HARDWAREdotASTRO/Small_Radio_Telescope/Pics/71dty6aQaML._SY679_.jpg

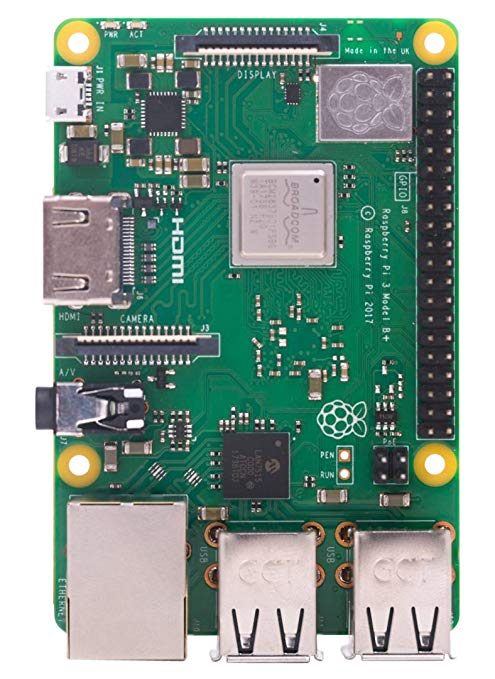
Pics/71dty6aQaML._SY679_.jpg
