HARDWAREdotASTRO/Small_Radio_Telescope/ArduinoTestFiles/SmallRadioTelescope/PicturesAndVideos/SignalsReceiver/SignalsReceiver.jpg

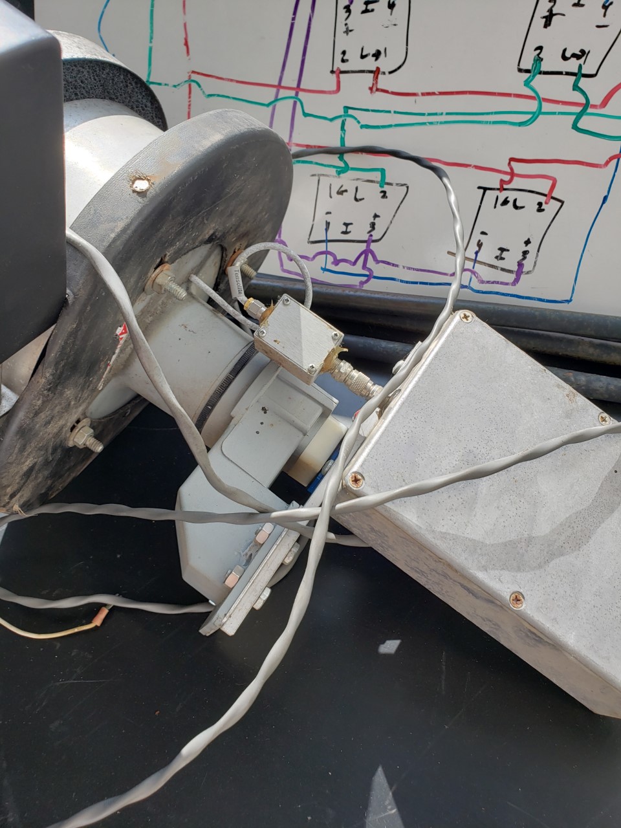
ArduinoTestFiles/SmallRadioTelescope/PicturesAndVideos/SignalsReceiver/SignalsReceiver.jpg
