HARDWAREdotASTRO/Small_Radio_Telescope/README.md

# Small_Radio_Telescope
Code to be used with control system for Winona State University's Small Radio Telescope (SRT).

For specific information about the workings see https://osf.io/wx659/wiki/home/
