HARDWAREdotASTRO/Small_Radio_Telescope/Research/Resources/ecliptic_to_motor_translation_math.pdf

SRT MEMO #018
MASSACHUSETTS INSTITUTE OF TECHNOLOGY HAYSTACK OBSERVATORY
WESTFORD, MASSACHUSETTS 01886

June 13, 2005
Telephone: 978-692-4764
Fax: 781-981-0590
To: SRT Group

From: Alan E.E. Rogers

Subject: | | Interferometer geometry calculations

For the “VLBI” mode we start with the latitude, longitude and height of each end of the “baseline” and convert to geocentric right handed x, y, z coordinates. This coordinate conversion is done by function
( | ) () (
( | ) () ( )
( | ) () | ()
cos | cos
cos | sin
1 | sin

=+
=+
= +−+
x | n hgt | lat | lon)
y | n hgt | lat | lon
z | n | e hgt | lat
where | ( | ) () 1
2 | 2
n a | e | lat = | −1 sin
a = 6378137 m | WGS84
e = 2f-f ²
f = 1/298.257223563 WGS84

The vector baseline is defined as the vector from site1 (the “reference” site) to site2 (the remote site)

2 | 1
2 | 1
2 | 1

=−
=−
=−

x

y

z

b | xx
b | y | y
b | z | z
The delay τ of a signal’s arrival at the remote site is τ =− | =− | + | + ˆ | ( | ) G
i | xx | yy | zz b s c | bs bs bs c
Where c = velocity of propagation
sˆ = unit vector in the direction of the source
sx = cos (dec) cos (gha)
sy = -cos (dec) sin (gha)
sz = sin(dec)

where gha = gst – ra = Greenwich hour angle gst = Greenwich sidereal time

1

ra = apparent right ascension
dec = apparent declination

or from the derivatives of the phase with respect to ra and dec

φ | πλ = | − ( | ) | ()( ) 2 | cos | cos | cos | sin | sin ( | ) dec | gha b | dec | gha b | dec b x | ( ) ( ) y | z + | ( )

In units of fringes per arc second
( | ) () | () ( | )
( | ) ( ) | ( )( ) | ( )( )( | )
sin | cos | 648,000
cos | cos | sin | sin | sin | 648,000
π | λ
π | λ
= | +
= | − | +
x | y
z | x | y
u | b | gha b | gha
v | b | dec b | gha | dec b | gha | dec

The interferometer phase (normally defined as being positive (NRAO’s convention) when the signal arrives earlier at the 2nd site is
φ | πλ =+2 | ˆ | ( | ) G
b s | radians i
or φ =−2 | ( πτ f | radians)
where λ = wavelength (m)
f = frequency (Hz)

The components of the baseline projected in the direction of the source in the directions of increasing RA and increasing declination are known as u and v and are often expressed in units of fringes per arc second. These can be derived from the baseline projections
| | () | ()
( ) | ( )( ) | ( )( )
sin | cos
cos | cos | sin | sin | sin
= | +
= | − | +
x | y
z | x | y
u b | gha b | gha
v b | dec b | gha | dec b | gha | dec

2
