HARDWAREdotASTRO/Small_Radio_Telescope/ArduinoTestFiles/SmallRadioTelescope/PicturesAndVideos/SRTMotorAssembly/ArduinoSwitchSchematic.jpg

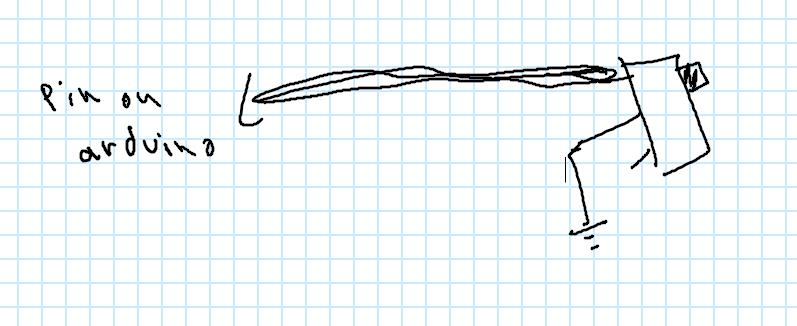
ArduinoTestFiles/SmallRadioTelescope/PicturesAndVideos/SRTMotorAssembly/ArduinoSwitchSchematic.jpg
