HARDWAREdotASTRO/Small_Radio_Telescope/ArduinoTestFiles/SmallRadioTelescope/PicturesAndVideos/SRTMotorAssembly/pololu schematic.jpg

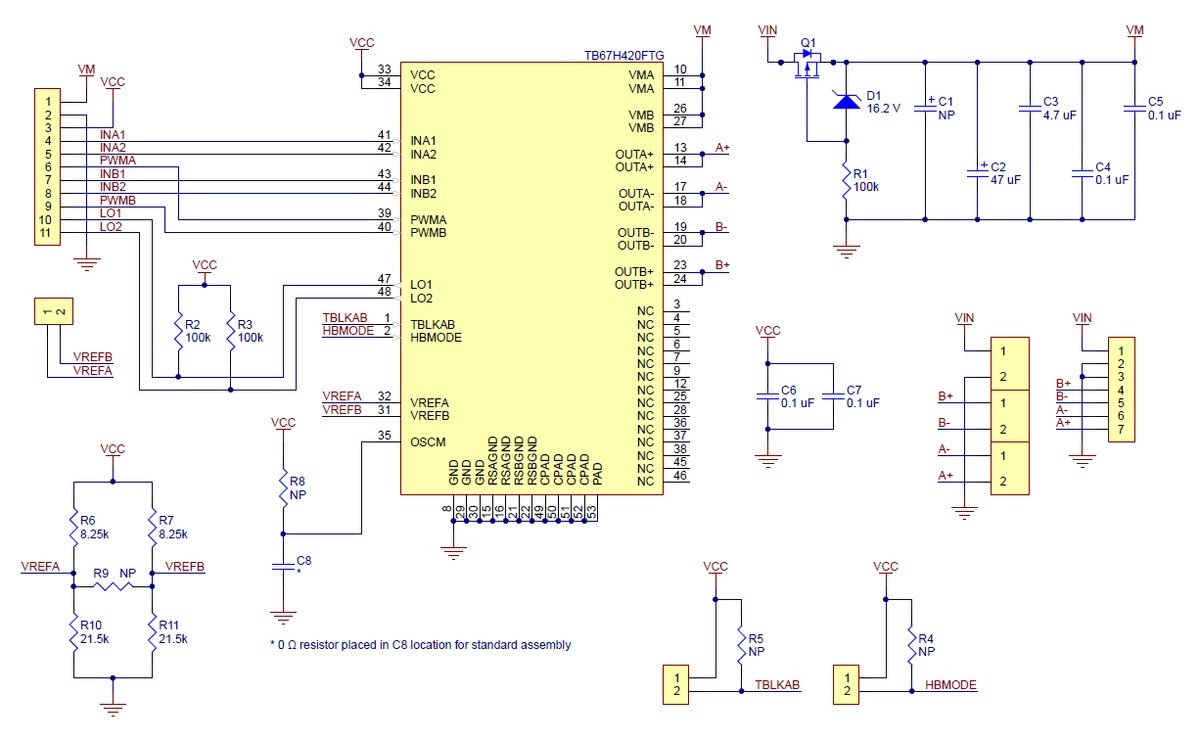
ArduinoTestFiles/SmallRadioTelescope/PicturesAndVideos/SRTMotorAssembly/pololu schematic.jpg
