HARDWAREdotASTRO/Small_Radio_Telescope/ArduinoTestFiles/SmallRadioTelescope/PicturesAndVideos/SRTMotorAssembly/PololuChipPinoutDescriptionTable.PNG

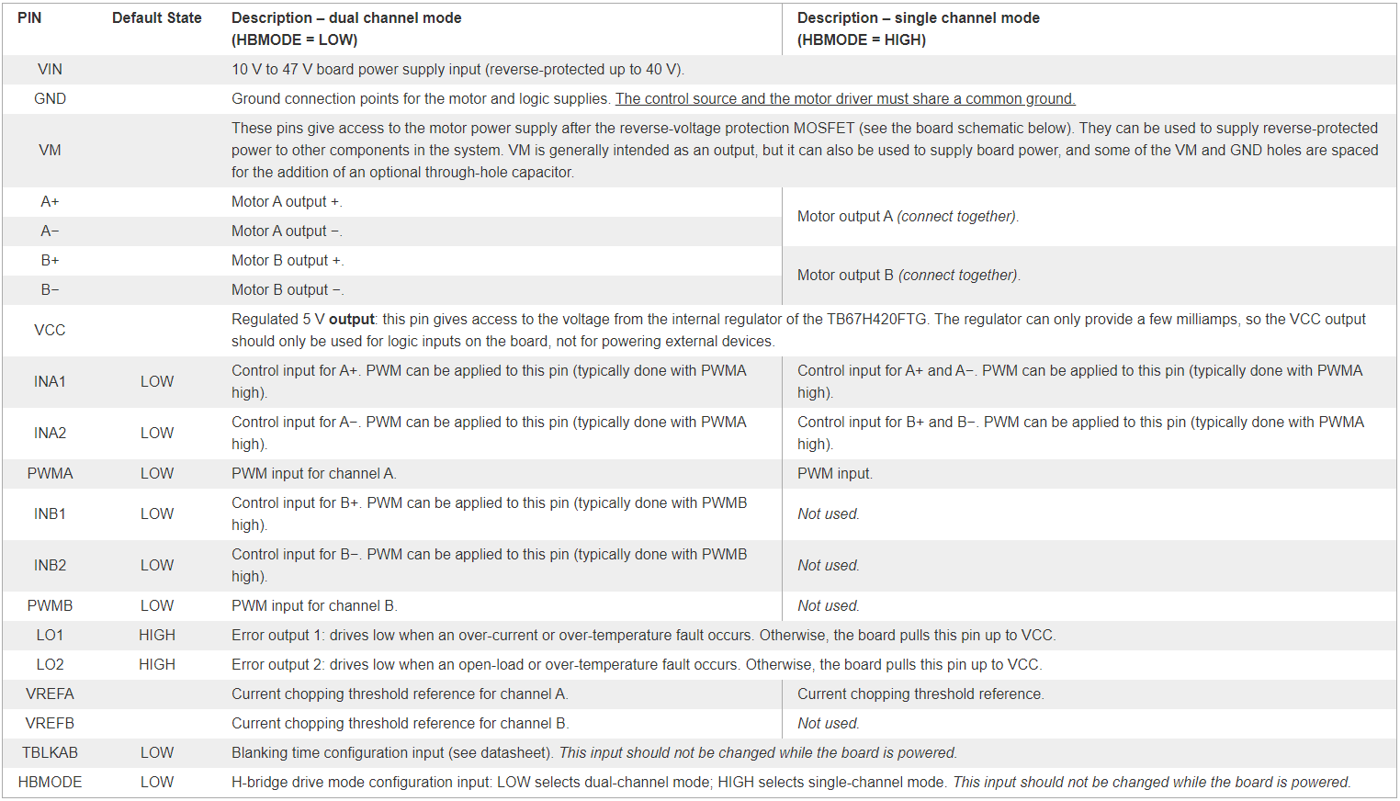
ArduinoTestFiles/SmallRadioTelescope/PicturesAndVideos/SRTMotorAssembly/PololuChipPinoutDescriptionTable.PNG
