HARDWAREdotASTRO/Small_Radio_Telescope/ArduinoTestFiles/SmallRadioTelescope/PicturesAndVideos/SRTMotorAssembly/pololuPinoutDiagram.jpg

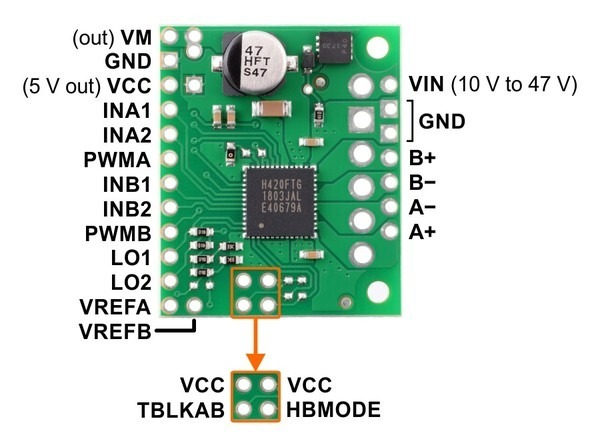
ArduinoTestFiles/SmallRadioTelescope/PicturesAndVideos/SRTMotorAssembly/pololuPinoutDiagram.jpg
