HARDWAREdotASTRO/Small_Radio_Telescope/Pics/4-reed-switch.jpg

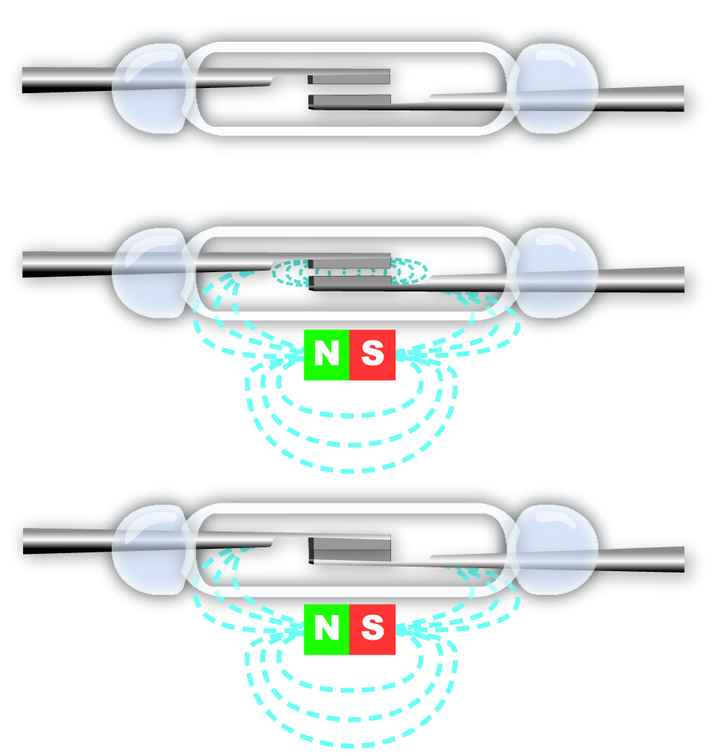
Pics/4-reed-switch.jpg
