HARDWAREdotASTRO/Small_Radio_Telescope/Pics/51K5cifF0kL.jpg

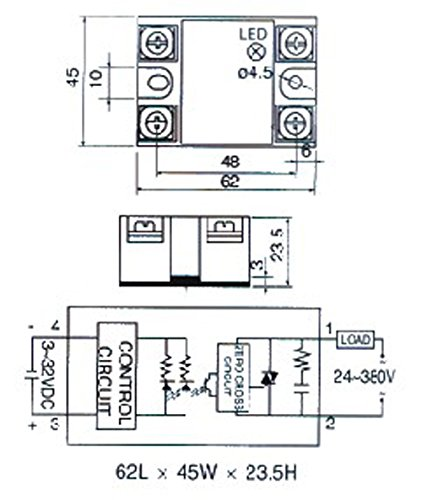
Pics/51K5cifF0kL.jpg
