HARDWAREdotASTRO/Small_Radio_Telescope/Pics/71DZKc+WAvL._SL1000_.jpg

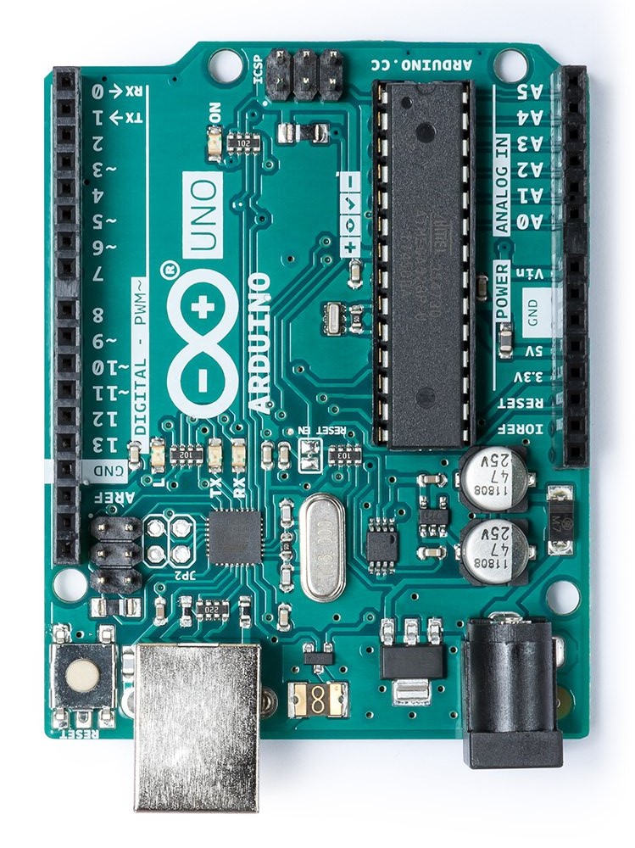
Pics/71DZKc+WAvL._SL1000_.jpg
