HARDWAREdotASTRO/Small_Radio_Telescope/Pics/arduino-raspberry-pi-serial-connect-1024x840.jpg

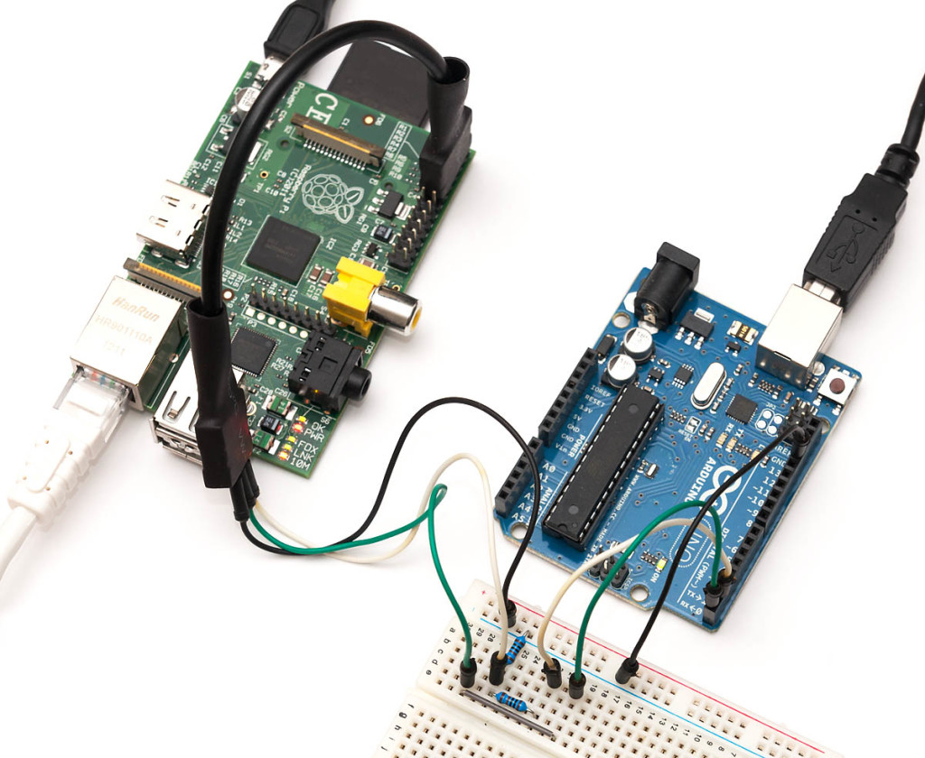
Pics/arduino-raspberry-pi-serial-connect-1024x840.jpg
