HARDWAREdotASTRO/Small_Radio_Telescope/Pics/box2.PNG

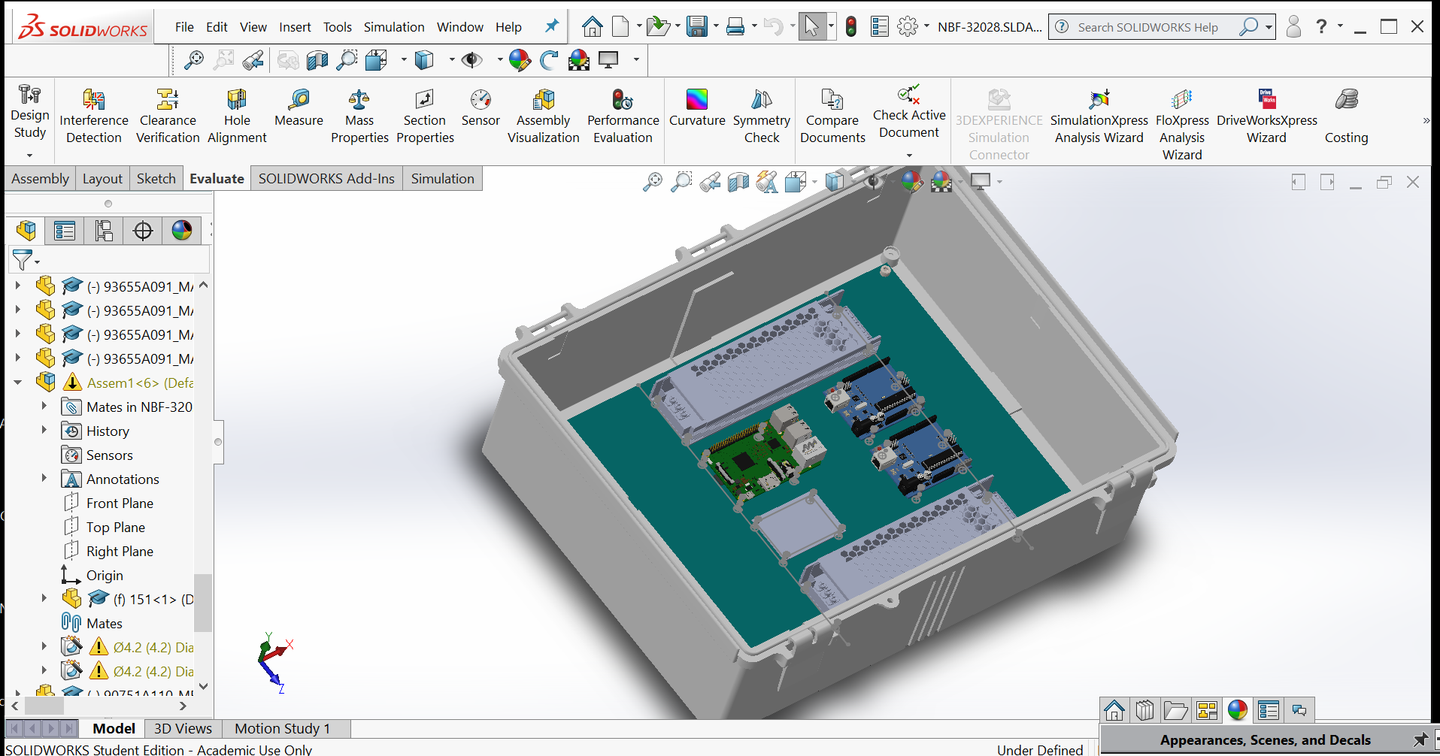
Pics/box2.PNG
