HARDWAREdotASTRO/Small_Radio_Telescope/Pics/box.PNG

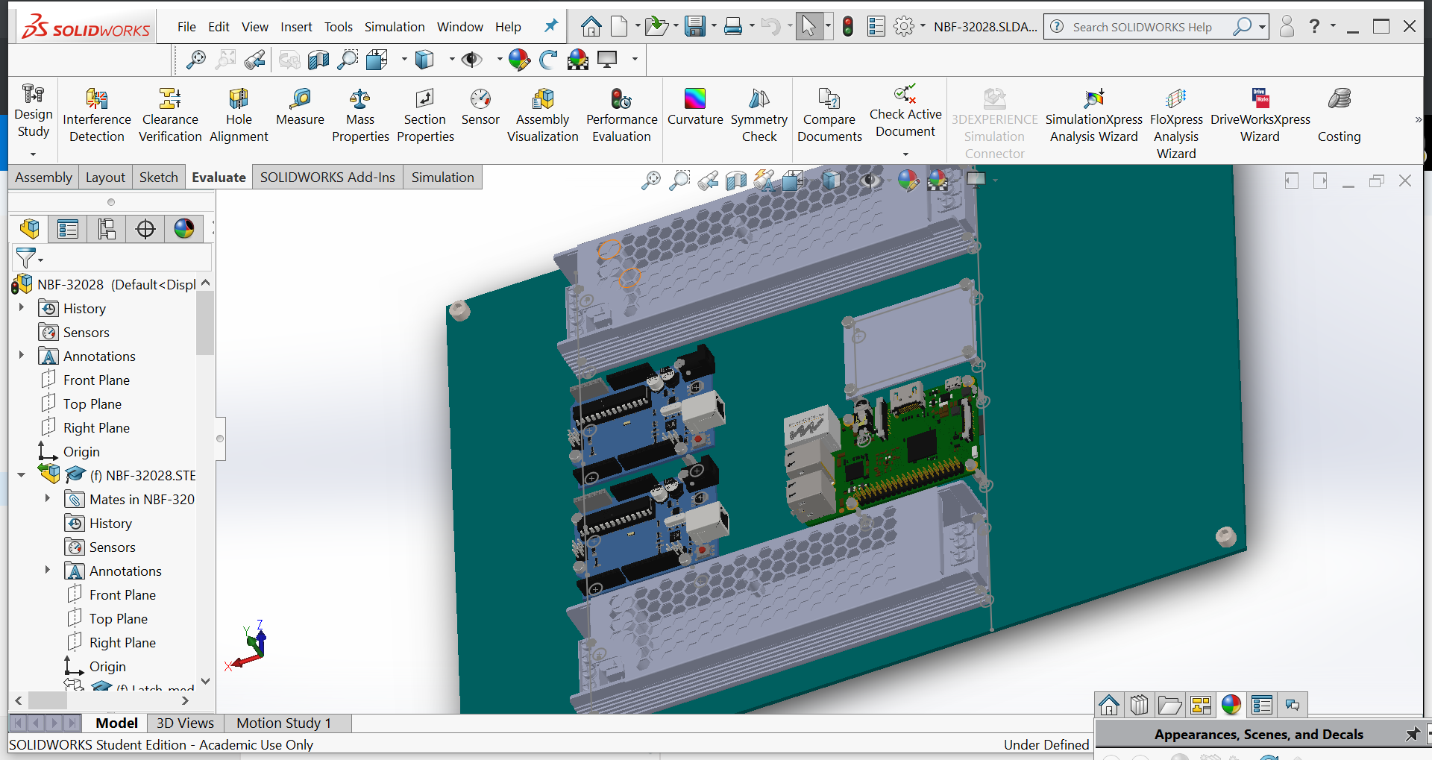
Pics/box.PNG
