HARDWAREdotASTRO/Small_Radio_Telescope/Pics/Capsfgture.PNG

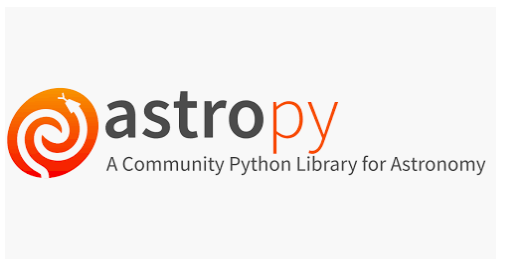
Pics/Capsfgture.PNG
