HARDWAREdotASTRO/Small_Radio_Telescope/Pics/Capture1.PNG

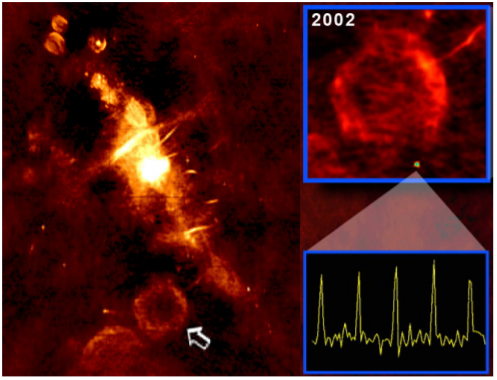
Pics/Capture1.PNG
