HARDWAREdotASTRO/Small_Radio_Telescope/Pics/Capture2.PNG

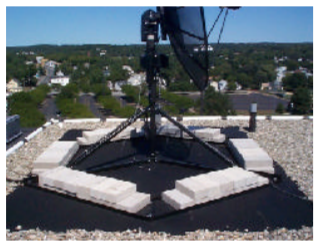
Pics/Capture2.PNG
