HARDWAREdotASTRO/Small_Radio_Telescope/Pics/Capturedgn.PNG

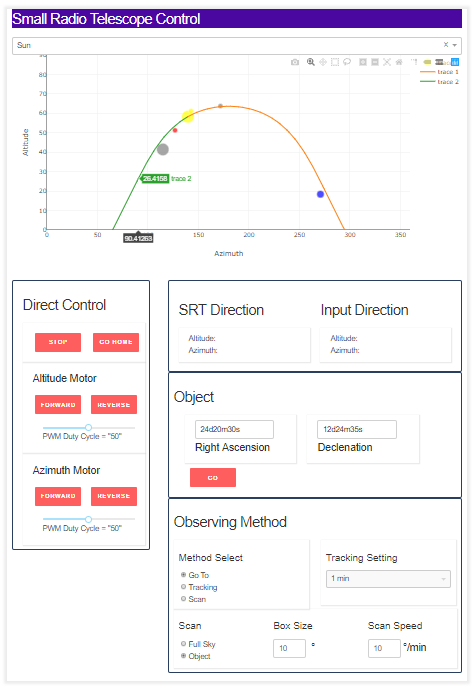
Pics/Capturedgn.PNG
