HARDWAREdotASTRO/Small_Radio_Telescope/Pics/Clean_sens.PNG

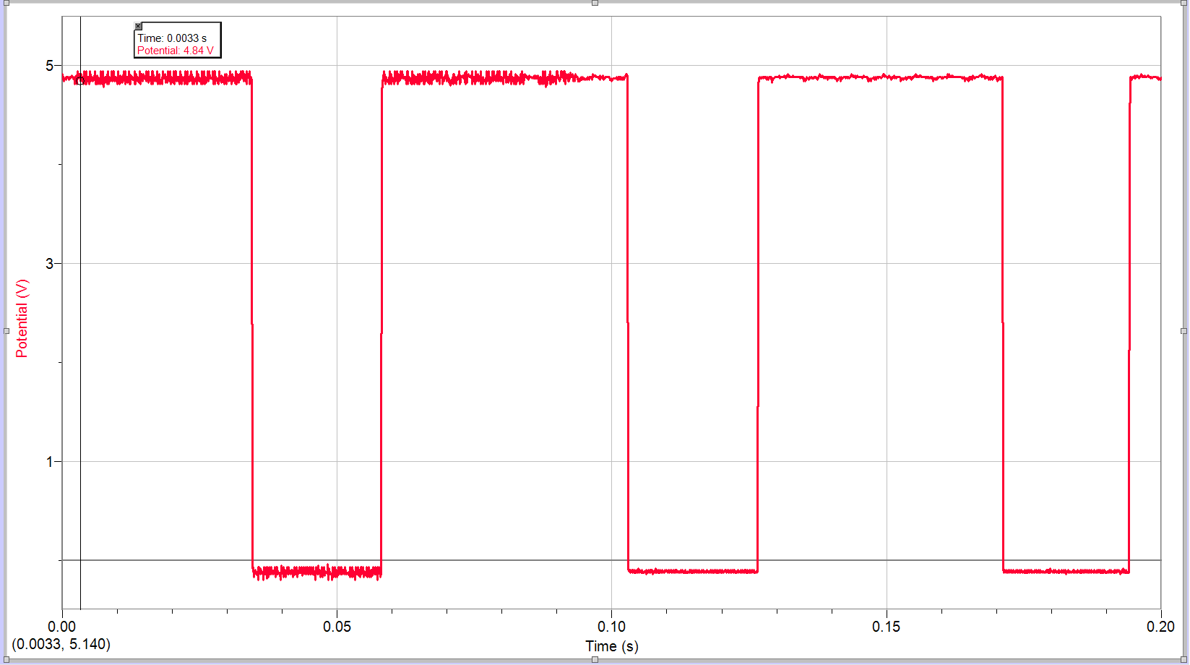
Pics/Clean_sens.PNG
