HARDWAREdotASTRO/Small_Radio_Telescope/Pics/cover.PNG

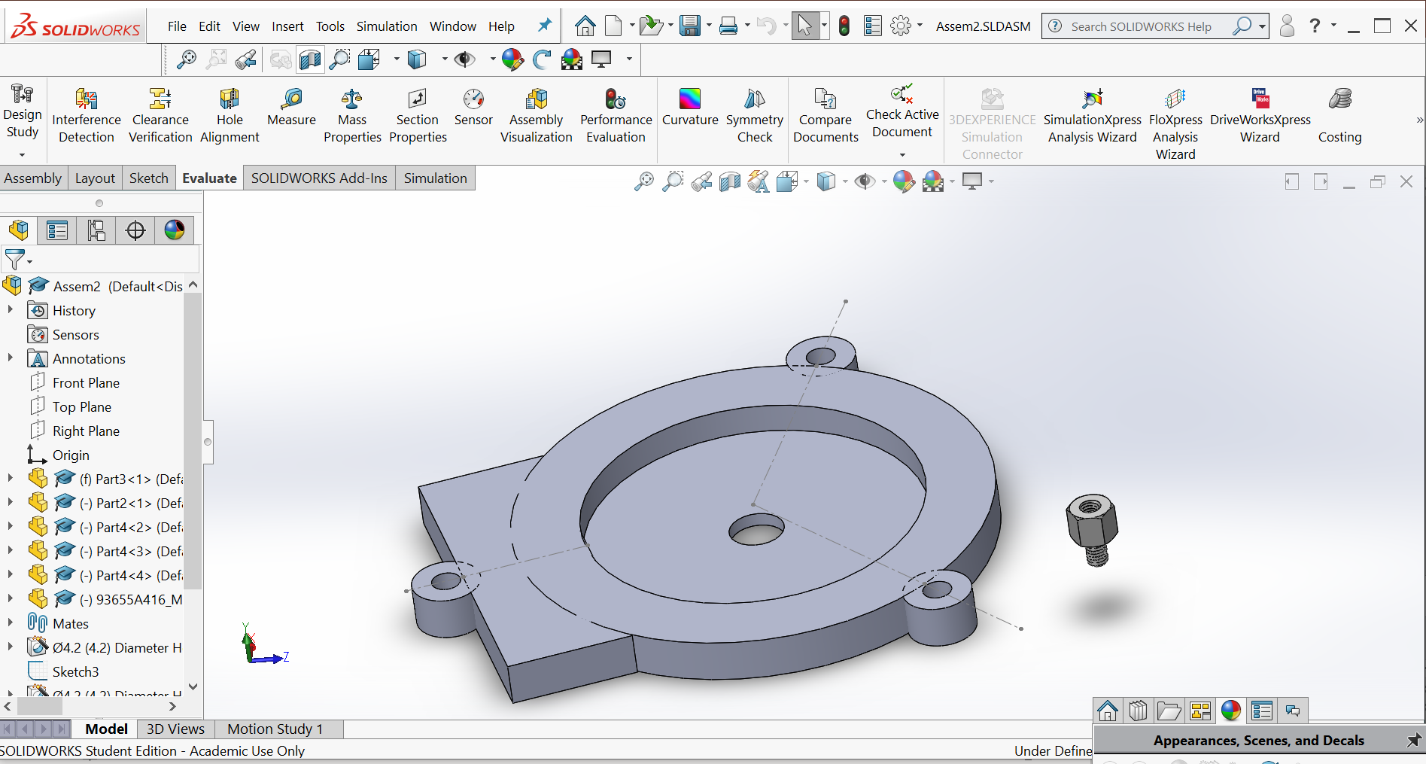
Pics/cover.PNG
