HARDWAREdotASTRO/Small_Radio_Telescope/Pics/cs04p13l.jpg

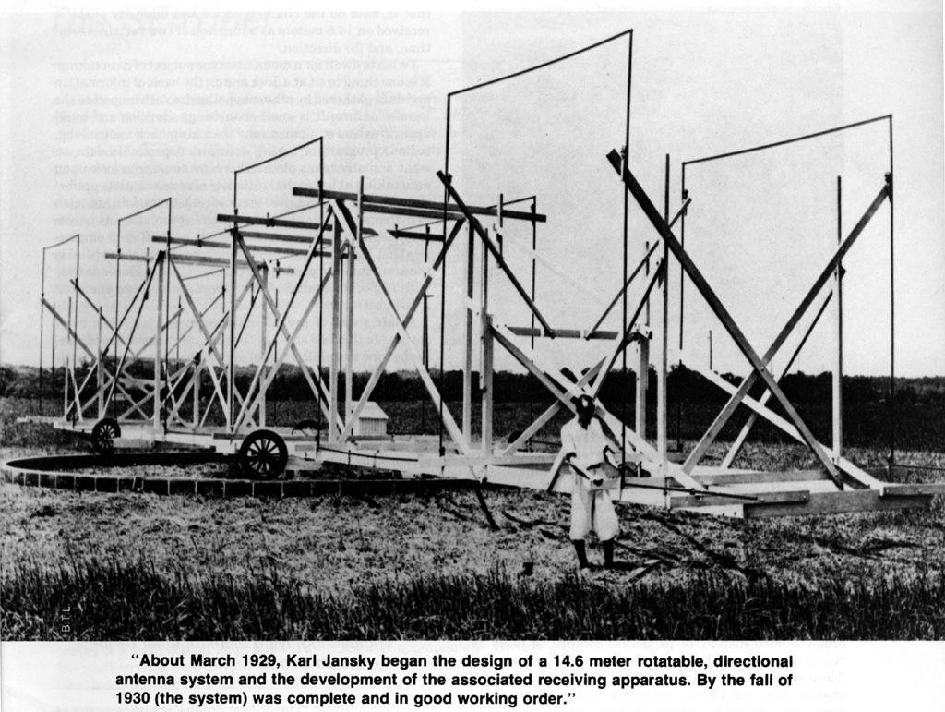
Pics/cs04p13l.jpg
