HARDWAREdotASTRO/Small_Radio_Telescope/Pics/download.jpg

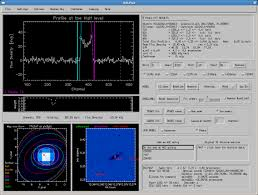
Pics/download.jpg
