HARDWAREdotASTRO/Small_Radio_Telescope/Pics/gc_1meter_big.gif

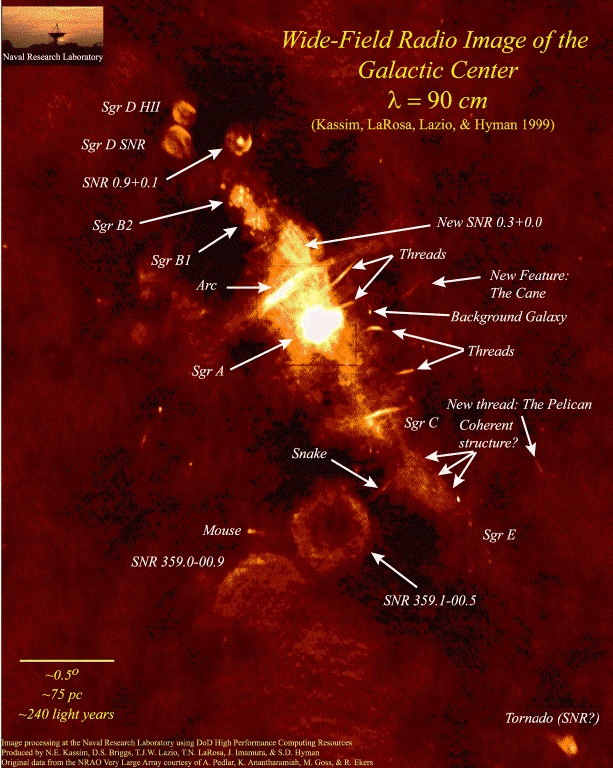
Pics/gc_1meter_big.gif
