HARDWAREdotASTRO/Small_Radio_Telescope/Pics/gears.jpg

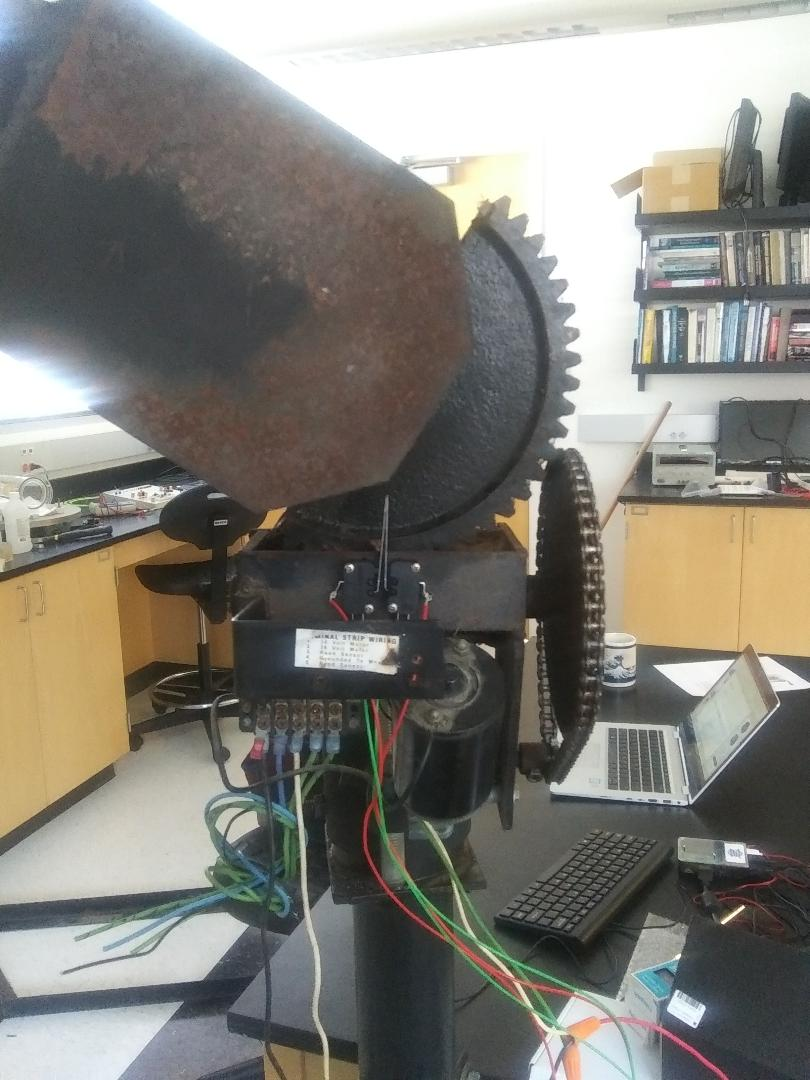
Pics/gears.jpg
