HARDWAREdotASTRO/Small_Radio_Telescope/Pics/GPIOreference.PNG

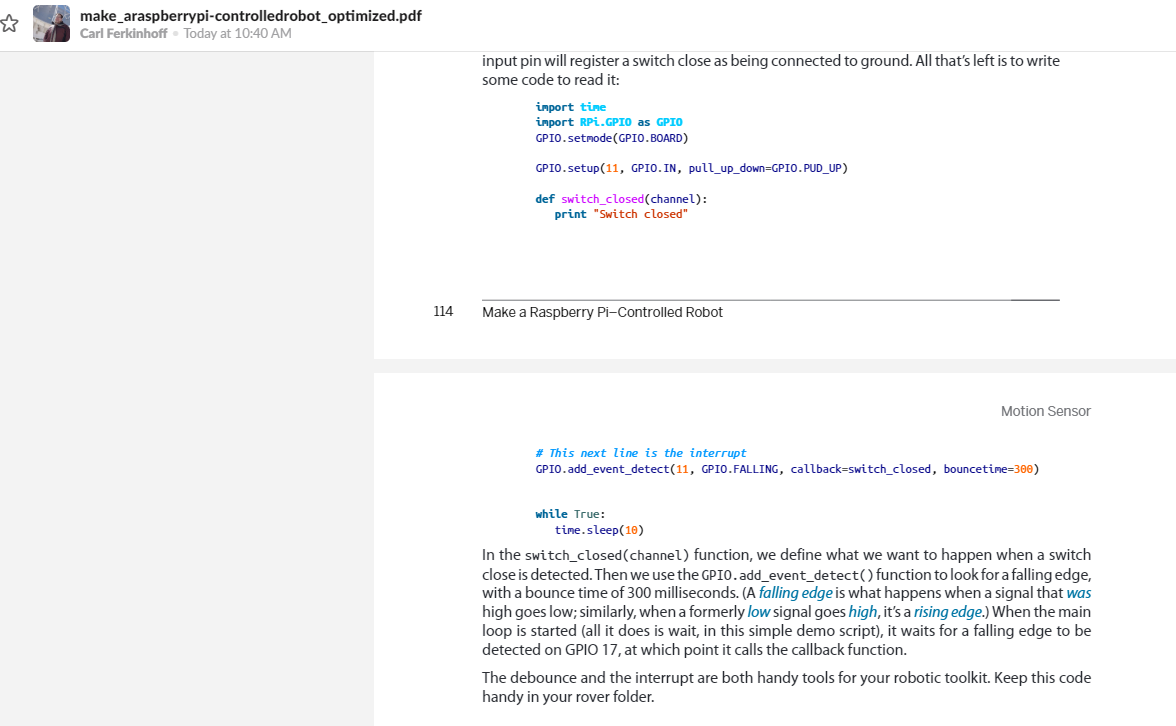
Pics/GPIOreference.PNG
