HARDWAREdotASTRO/Small_Radio_Telescope/Pics/HO_front-page_01.jpg

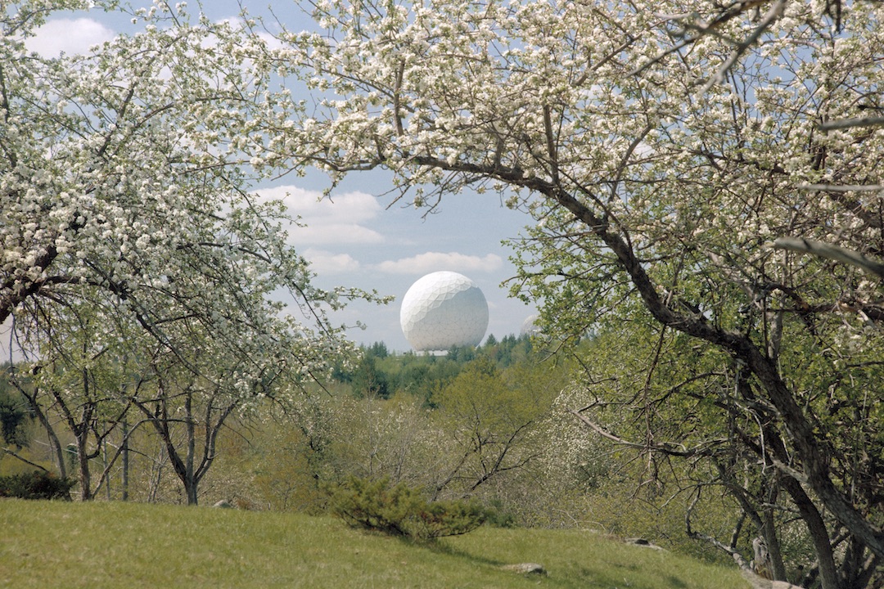
Pics/HO_front-page_01.jpg
