HARDWAREdotASTRO/Small_Radio_Telescope/Pics/IMG_0026.JPG

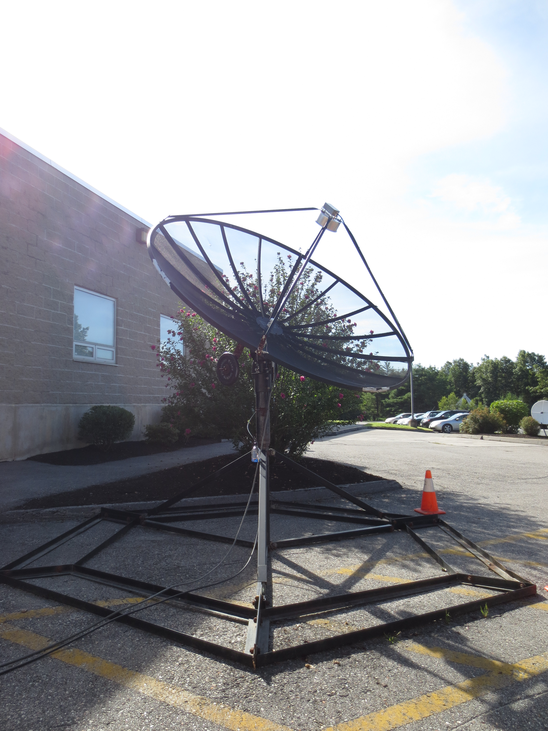
Pics/IMG_0026.JPG
