HARDWAREdotASTRO/Small_Radio_Telescope/Pics/IMGP8953.JPG

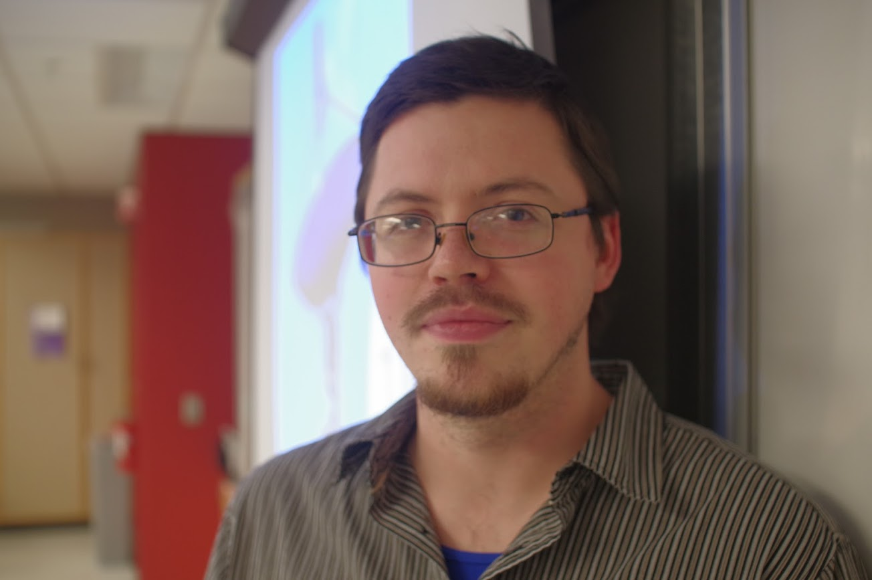
Pics/IMGP8953.JPG
