HARDWAREdotASTRO/Small_Radio_Telescope/Pics/Karl_Jansky.jpg

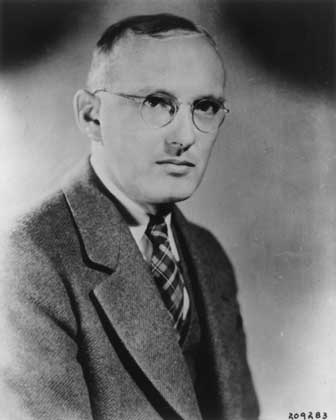
Pics/Karl_Jansky.jpg
