HARDWAREdotASTRO/Small_Radio_Telescope/Pics/limiting_switch.jpg

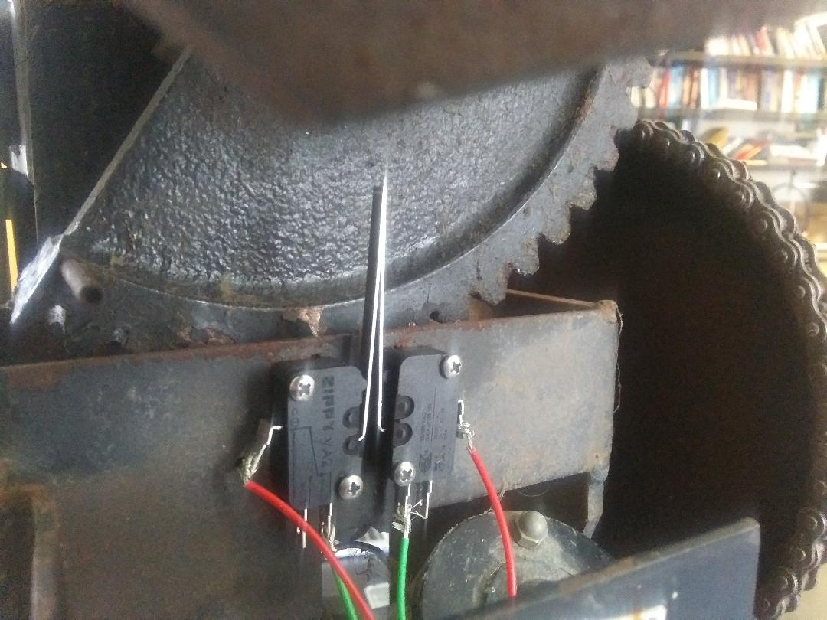
Pics/limiting_switch.jpg
