HARDWAREdotASTRO/Small_Radio_Telescope/Pics/memberimage.jpg

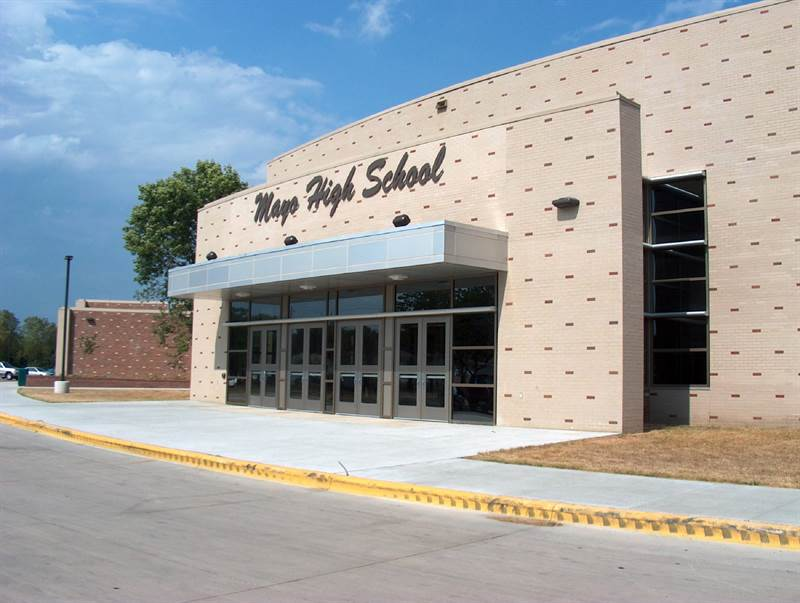
Pics/memberimage.jpg
