HARDWAREdotASTRO/Small_Radio_Telescope/Pics/motor_schematic.PNG

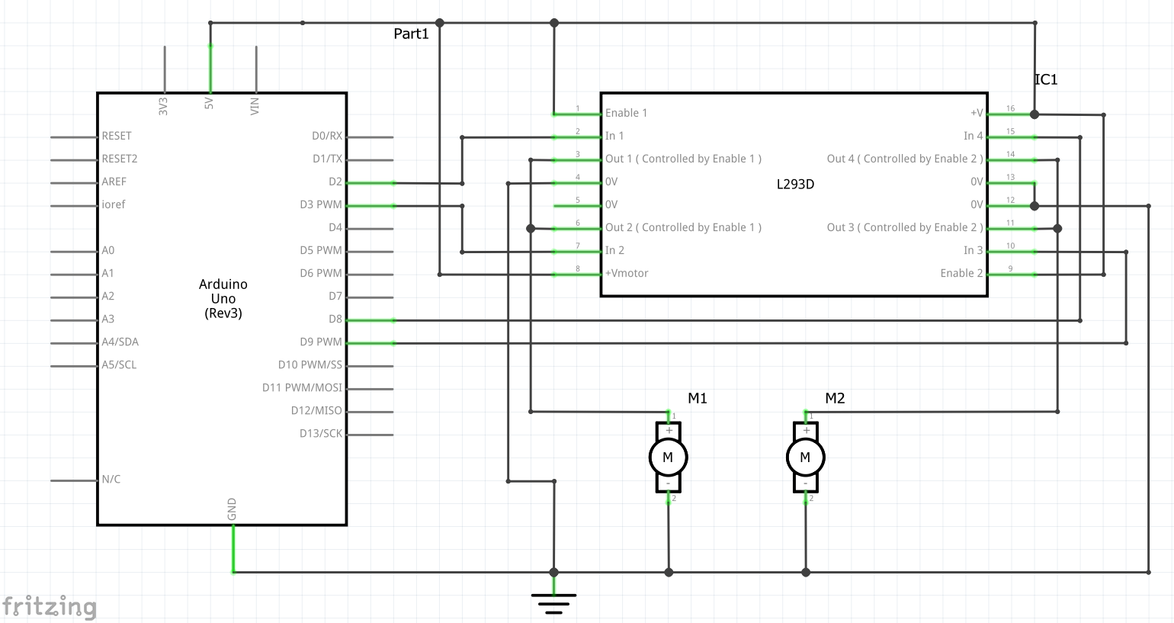
Pics/motor_schematic.PNG
