HARDWAREdotASTRO/Small_Radio_Telescope/Pics/nhi_allsky.gif

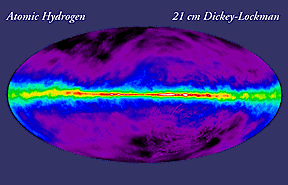
Pics/nhi_allsky.gif
