HARDWAREdotASTRO/Small_Radio_Telescope/Pics/Pololu.jpg

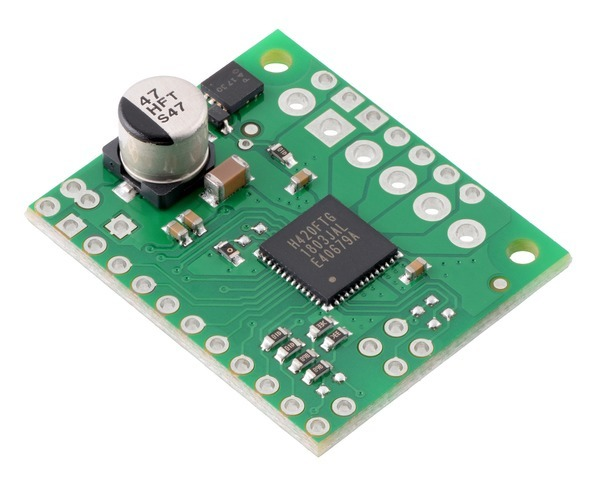
Pics/Pololu.jpg
