HARDWAREdotASTRO/Small_Radio_Telescope/Pics/reed-switch-normally-open.jpg

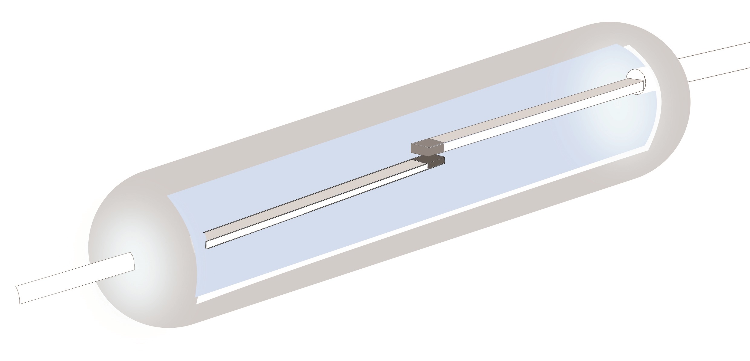
Pics/reed-switch-normally-open.jpg
