HARDWAREdotASTRO/Small_Radio_Telescope/Pics/Reed_switch.jpg

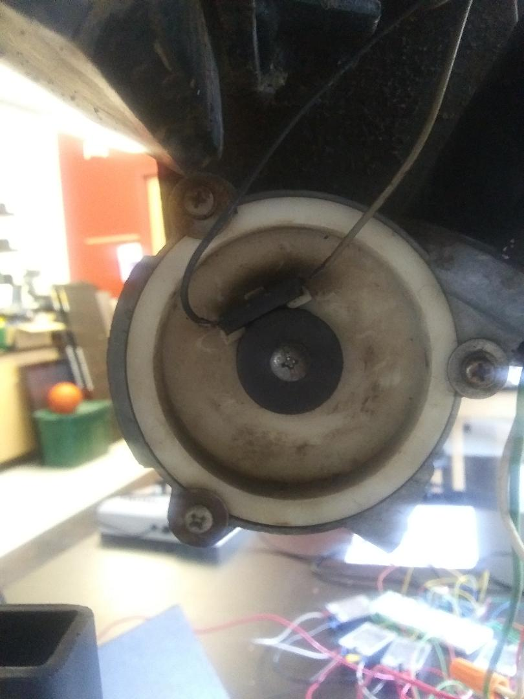
Pics/Reed_switch.jpg
