HARDWAREdotASTRO/Small_Radio_Telescope/Pics/reed_switch.PNG

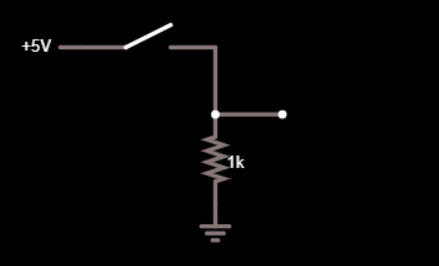
Pics/reed_switch.PNG
