HARDWAREdotASTRO/Small_Radio_Telescope/Pics/Shaft.jpg

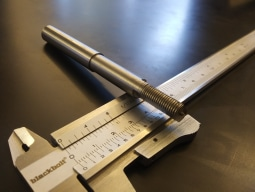
Pics/Shaft.jpg
