HARDWAREdotASTRO/Small_Radio_Telescope/Pics/solid.PNG

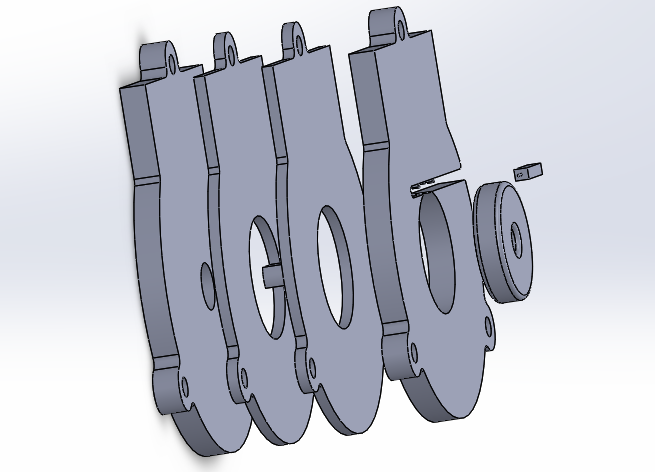
Pics/solid.PNG
