HARDWAREdotASTRO/Small_Radio_Telescope/Pics/srtdecember2.jpg

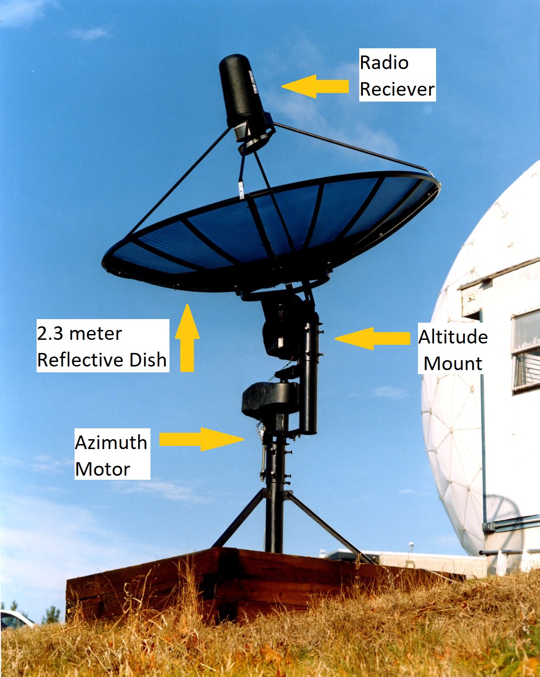
Pics/srtdecember2.jpg
