HARDWAREdotASTRO/Small_Radio_Telescope/Pics/srtdecember22.jpg

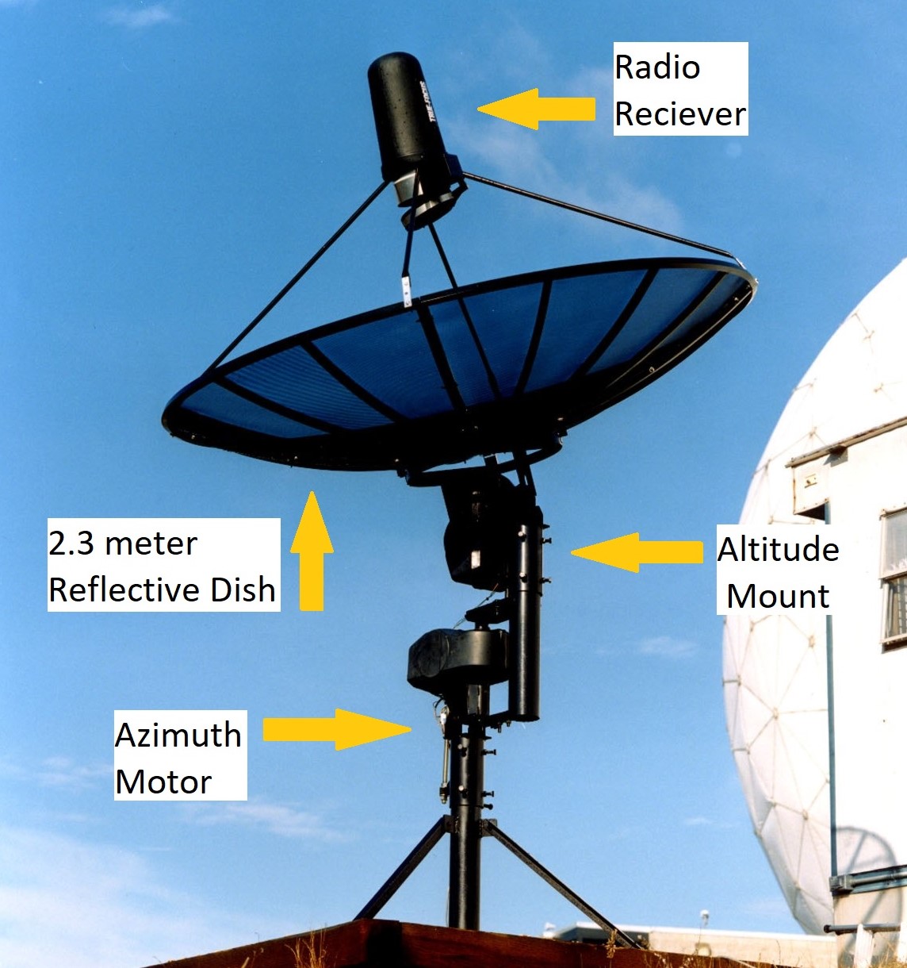
Pics/srtdecember22.jpg
