HARDWAREdotASTRO/Small_Radio_Telescope/Pics/Switches.jpg

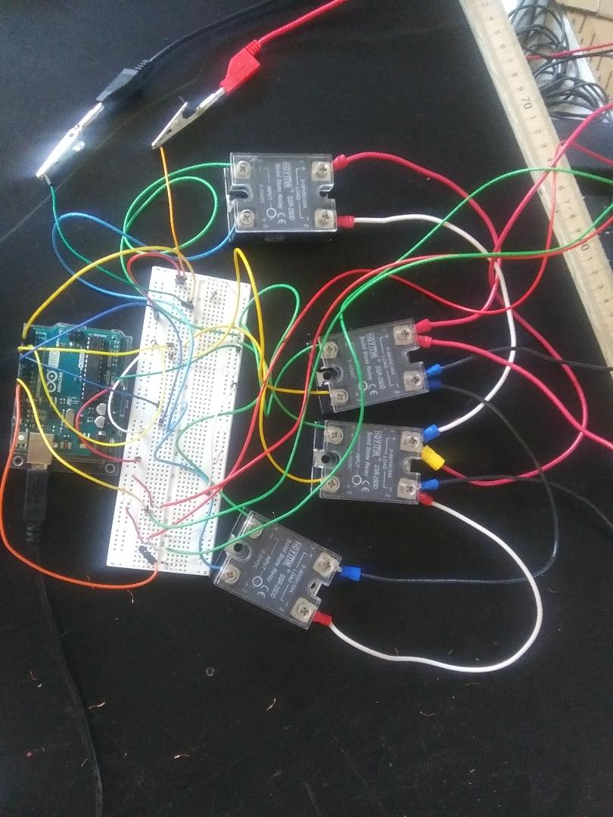
Pics/Switches.jpg
