HARDWAREdotASTRO/Small_Radio_Telescope/Pics/thumbnail3.jpg

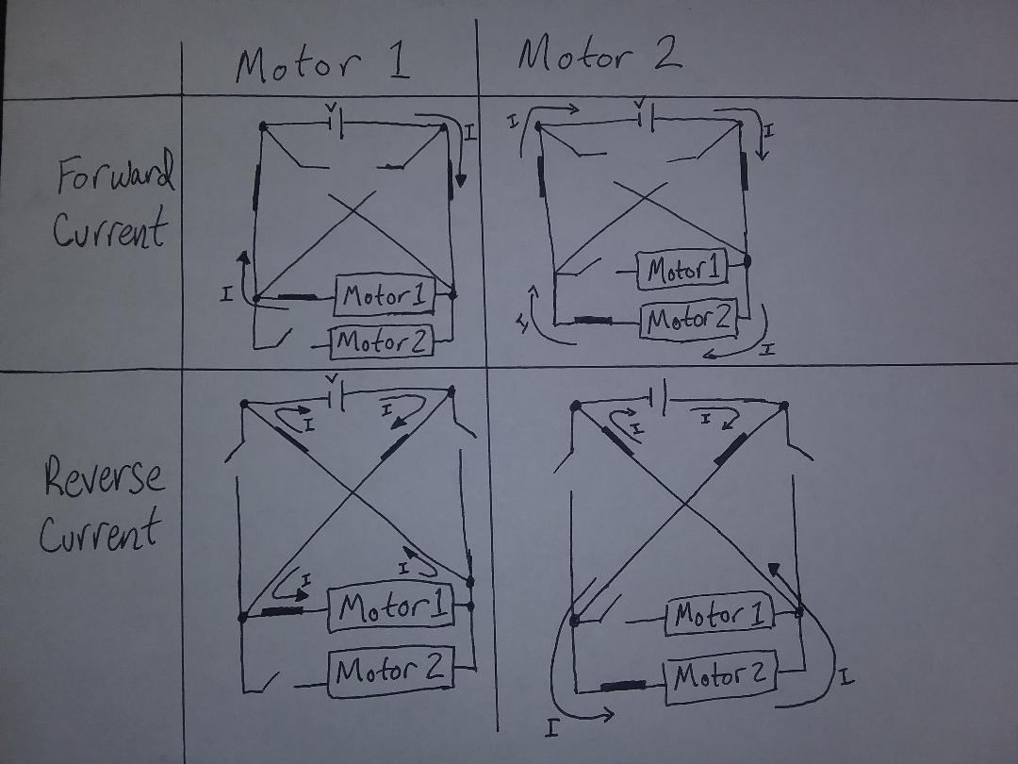
Pics/thumbnail3.jpg
