HARDWAREdotASTRO/Small_Radio_Telescope/Pics/thumbnail4.jpg

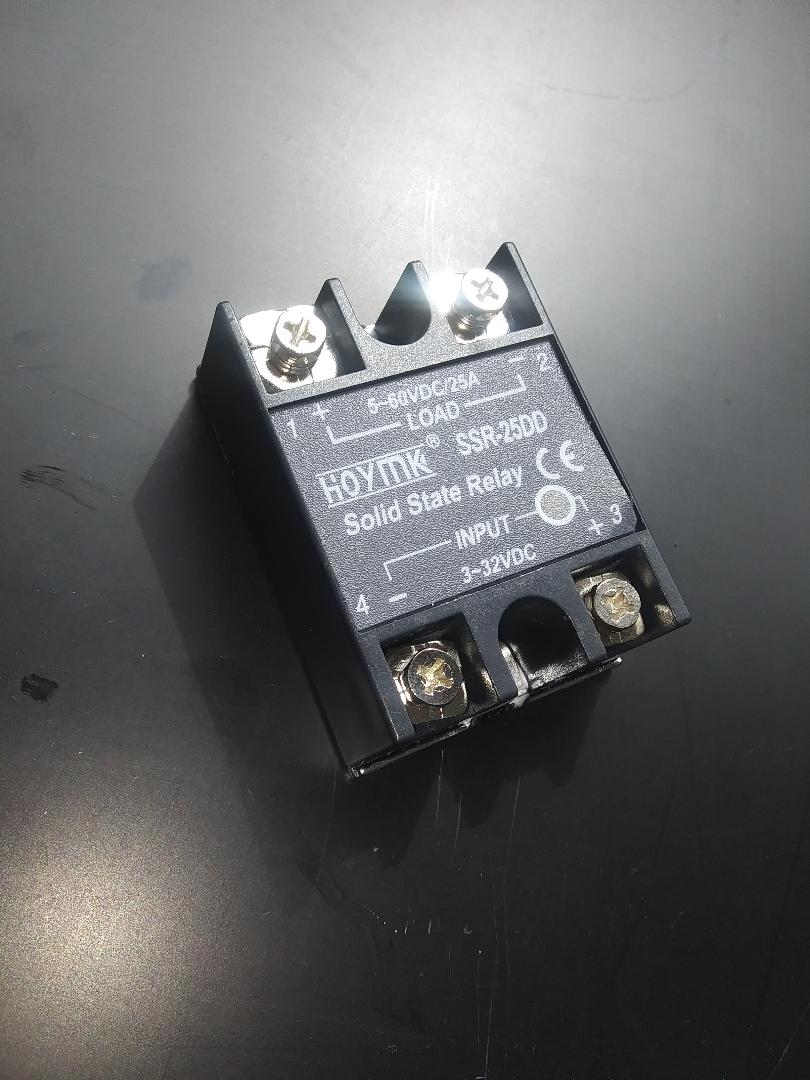
Pics/thumbnail4.jpg
