HARDWAREdotASTRO/Small_Radio_Telescope/Pics/thumbnail (1).jpg

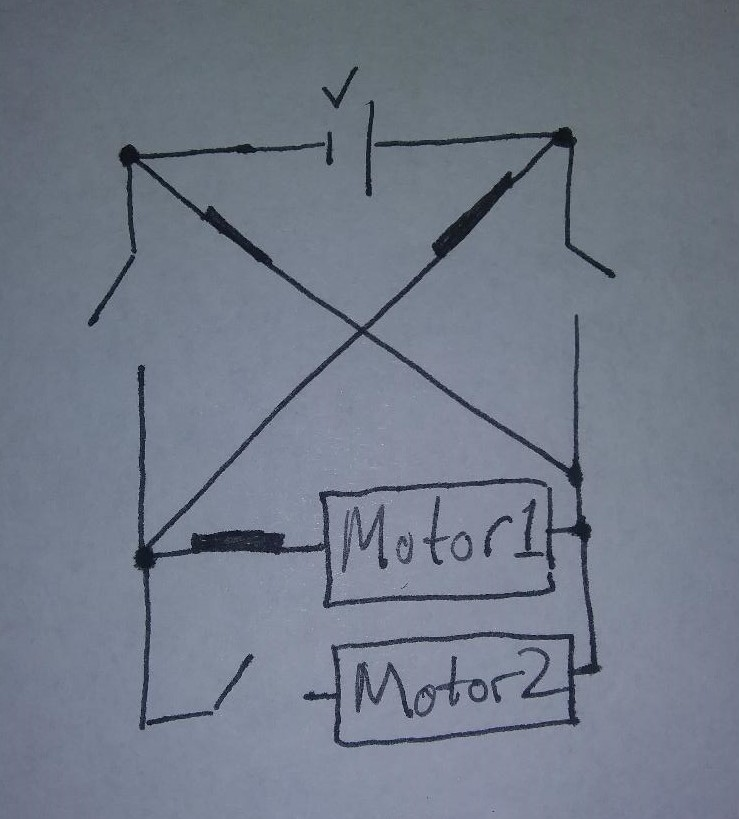
Pics/thumbnail (1).jpg
