HARDWAREdotASTRO/Small_Radio_Telescope/Pics/thumbnail (2).jpg

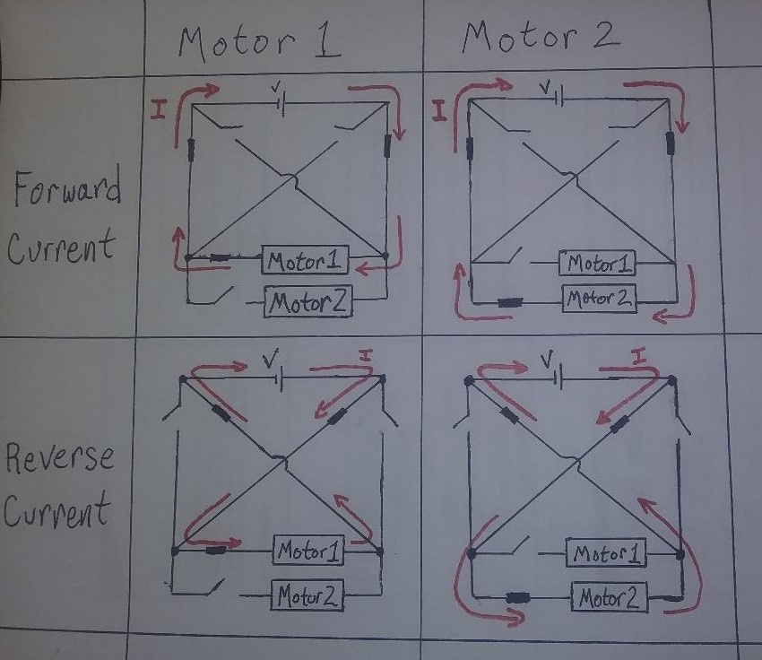
Pics/thumbnail (2).jpg
