HARDWAREdotASTRO/Small_Radio_Telescope/Pics/thumbnail (3).jpg

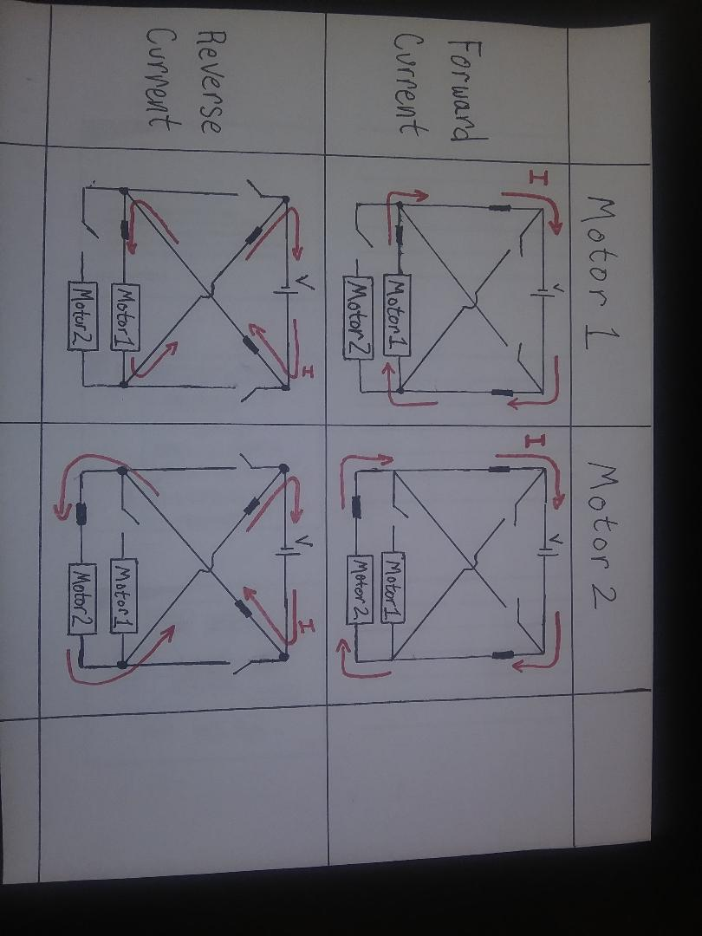
Pics/thumbnail (3).jpg
