HARDWAREdotASTRO/Small_Radio_Telescope/Pics/thumbnail (4).jpg

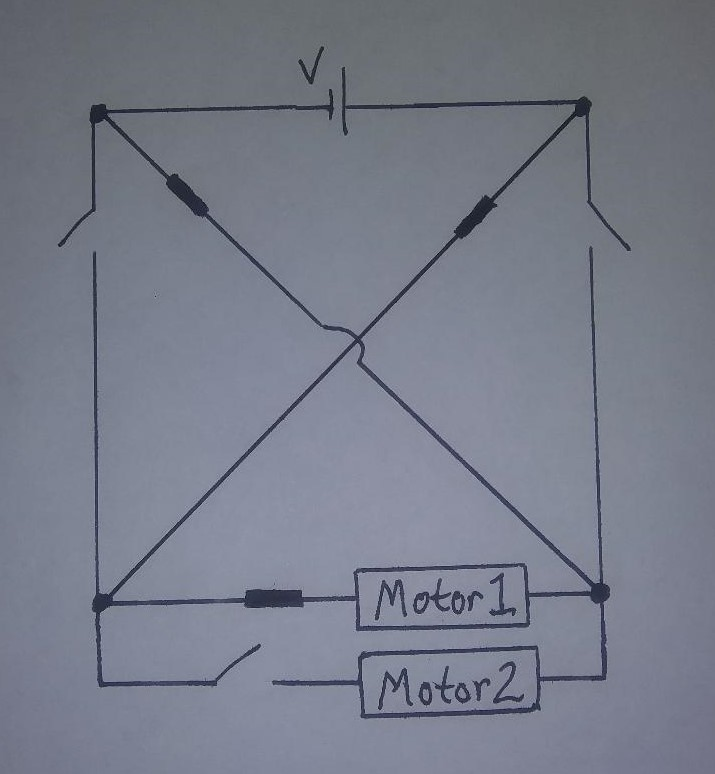
Pics/thumbnail (4).jpg
