HARDWAREdotASTRO/Small_Radio_Telescope/Pics/thumbnail (5).jpg

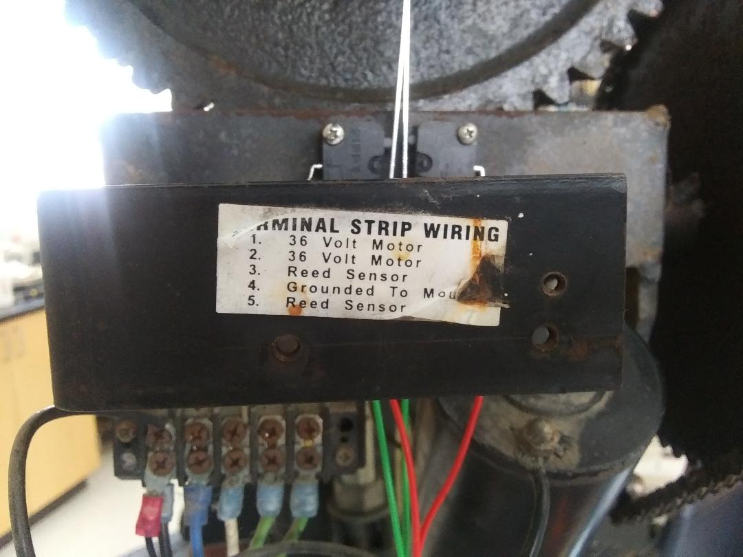
Pics/thumbnail (5).jpg
