HARDWAREdotASTRO/Small_Radio_Telescope/Pics/thumbnail.jpg

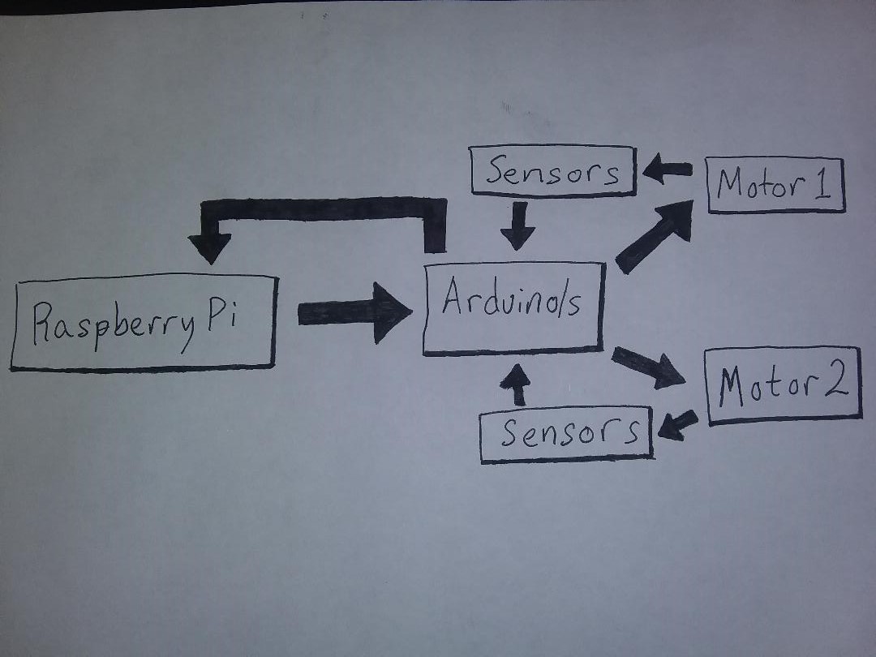
Pics/thumbnail.jpg
