HARDWAREdotASTRO/Small_Radio_Telescope/Pics/Winona State University_200px1.png

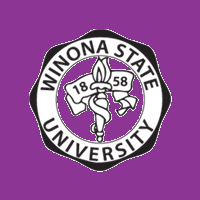
Pics/Winona State University_200px1.png
