HARDWAREdotASTRO/Small_Radio_Telescope/Pics/Winona State University_200px.png

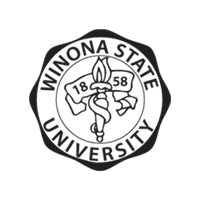
Pics/Winona State University_200px.png
