HARDWAREdotASTRO/Small_Radio_Telescope/Pics/Winona.PNG

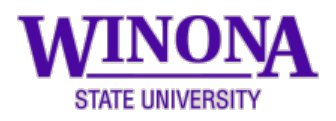
Pics/Winona.PNG
