HARDWAREdotASTRO/Small_Radio_Telescope/Schematics _ Datasheets/Box/Assem1.SLDASM

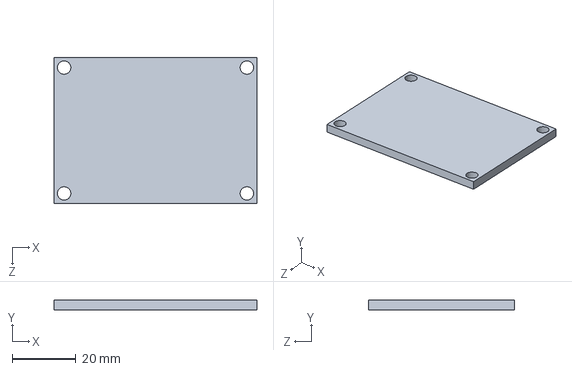
[picture p81: CAD file, 2020-06-30]
Schematics _ Datasheets/Box/Assem1.SLDASM
63.5 x 3.00 x 45.7 mm
