HARDWAREdotASTRO/Small_Radio_Telescope/AdditionalSolidWorksFiles/Box Parts/MW RS-15-5.SLDASM

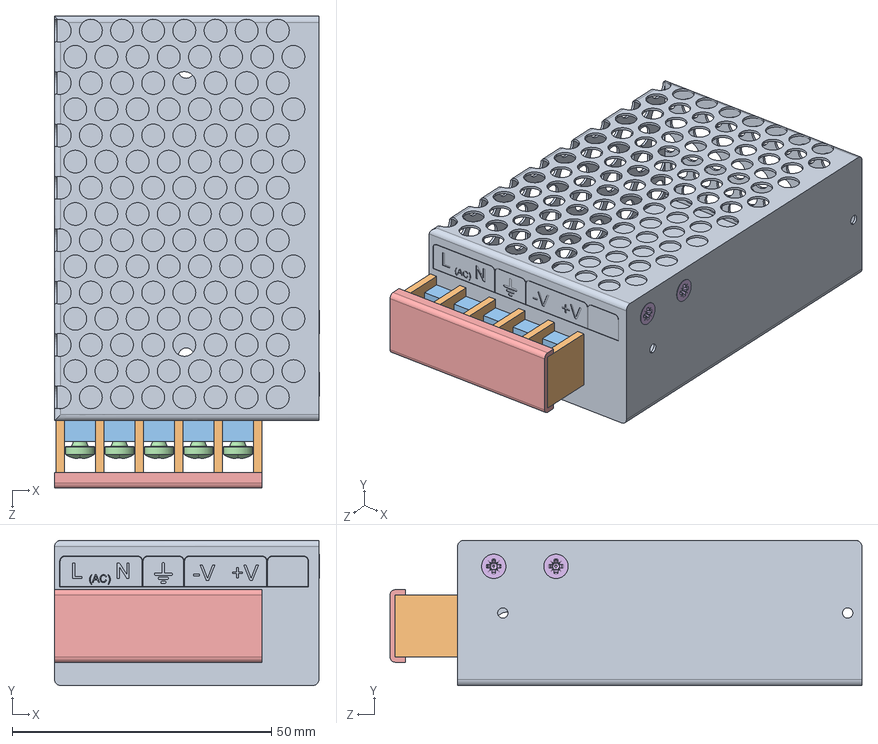
[picture p82: CAD file, 2020-06-30]
AdditionalSolidWorksFiles/Box Parts/MW RS-15-5.SLDASM
51.1 x 28.0 x 91.0 mm
User Library-Power Supply RS-25_Extruded_32-1.STEP
User Library-Power Supply RS-25_Extruded_30-1.STEP x 6
User Library-Power Supply RS-25_Extruded_31-1.STEP x 5
User Library-Power Supply RS-25_screw_iso_7045-m3x4-4_8-h-1.STEP x 5
User Library-Power Supply RS-25_cover transparent-1.STEP
User Library-Power Supply RS-25_screw_uni_7688_-_m2_5x0_45-5-1-4_8_0-1.STEP x 2
