HARDWAREdotASTRO/Small_Radio_Telescope/Schematics _ Datasheets/Motor Cover/Motor Cover/Assem1.SLDASM

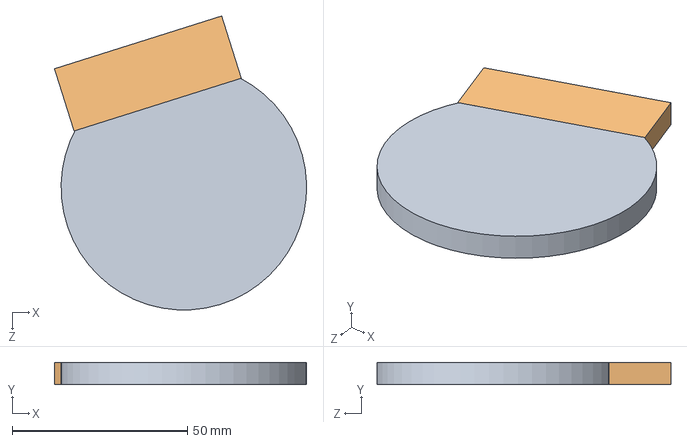
[picture p83: CAD file, 2020-06-30]
Schematics _ Datasheets/Motor Cover/Motor Cover/Assem1.SLDASM
71.9 x 6.35 x 83.8 mm
