HARDWAREdotASTRO/Small_Radio_Telescope/Schematics _ Datasheets/Box 2/NBF-32028 - Copy.SLDASM

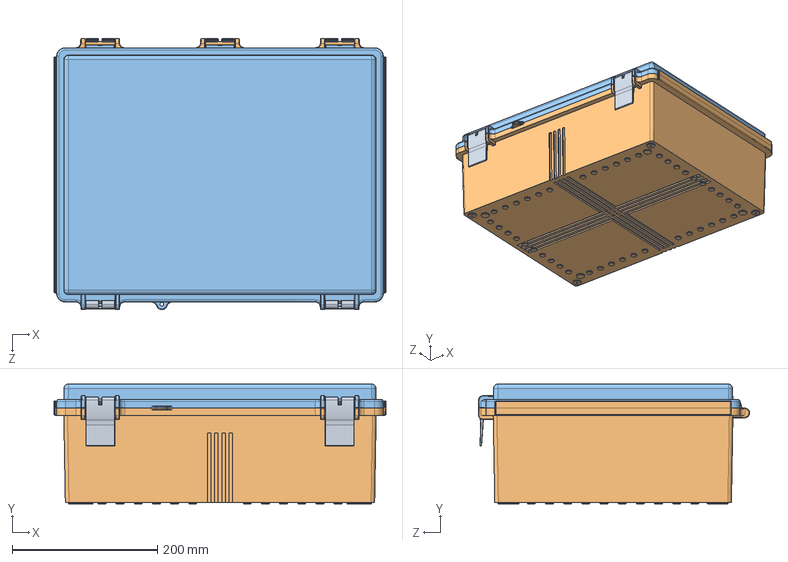
[picture p84: CAD file, 2020-06-30]
Schematics _ Datasheets/Box 2/NBF-32028 - Copy.SLDASM
457.0 x 165.0 x 373.5 mm
Latch-med-large.STEP x 2
NBF-32028-B.STEP
