HARDWAREdotASTRO/Small_Radio_Telescope/Schematics _ Datasheets/Motor Cover/Motor Cover/Assem2.SLDASM

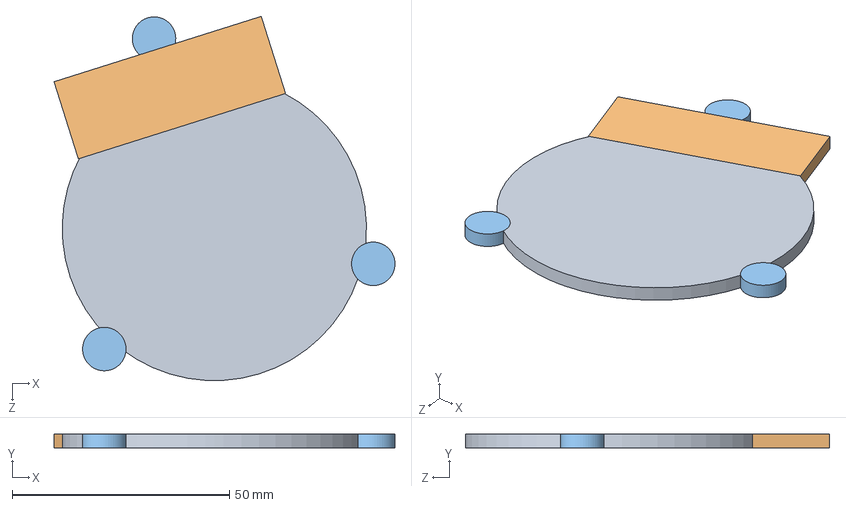
[picture p85: CAD file, 2020-06-30]
Schematics _ Datasheets/Motor Cover/Motor Cover/Assem2.SLDASM
78.5 x 3.17 x 83.8 mm
