HARDWAREdotASTRO/Small_Radio_Telescope/AdditionalSolidWorksFiles/Box Parts/not_a_pololu.SLDPRT

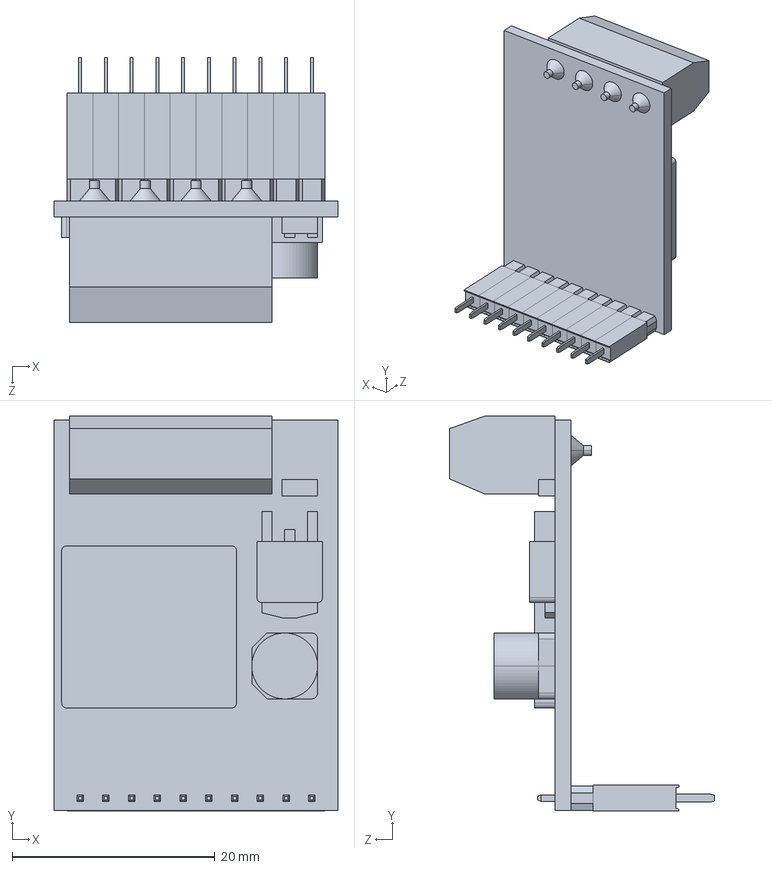
[picture p86: CAD file, 2020-06-30]
AdditionalSolidWorksFiles/Box Parts/not_a_pololu.SLDPRT
28.0 x 39.0 x 26.1 mm
