HARDWAREdotASTRO/Small_Radio_Telescope/AdditionalSolidWorksFiles/Box2020/SingleFuse.SLDPRT

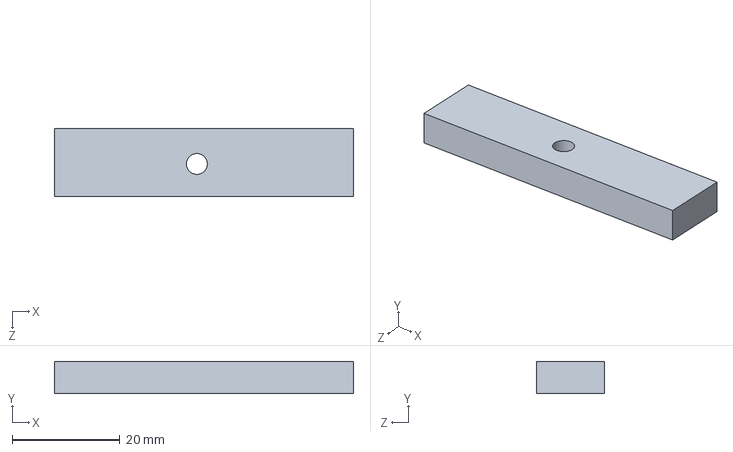
[picture p87: CAD file, 2020-06-30]
AdditionalSolidWorksFiles/Box2020/SingleFuse.SLDPRT
55.6 x 6.00 x 12.7 mm
