HARDWAREdotASTRO/Small_Radio_Telescope/Schematics _ Datasheets/Box 2/152.SLDPRT

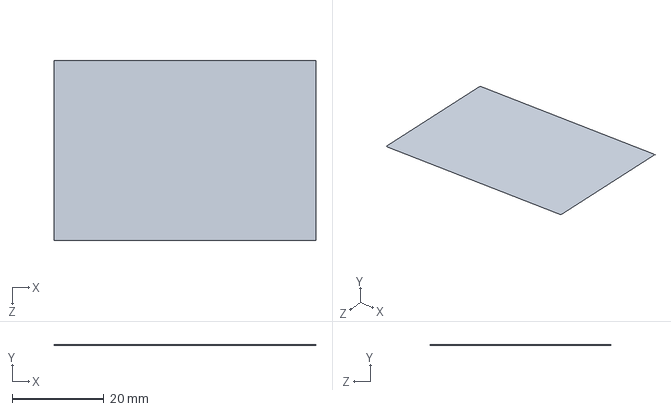
[picture p88: CAD file, 2020-06-30]
Schematics _ Datasheets/Box 2/152.SLDPRT
57.2 x 0.0001 x 39.4 mm
