HARDWAREdotASTRO/Small_Radio_Telescope/Schematics _ Datasheets/Motor Cover/Motor Cover/Part2.SLDPRT

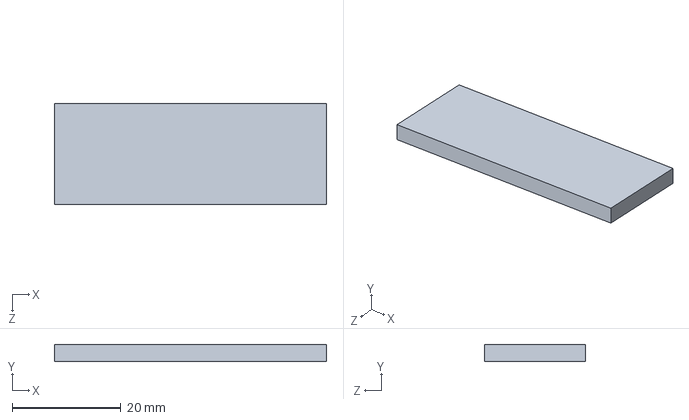
[picture p89: CAD file, 2020-06-30]
Schematics _ Datasheets/Motor Cover/Motor Cover/Part2.SLDPRT
50.0 x 3.17 x 18.6 mm
