HARDWAREdotASTRO/Small_Radio_Telescope/SolidWorks Files/MeanWellUHP200.SLDPRT

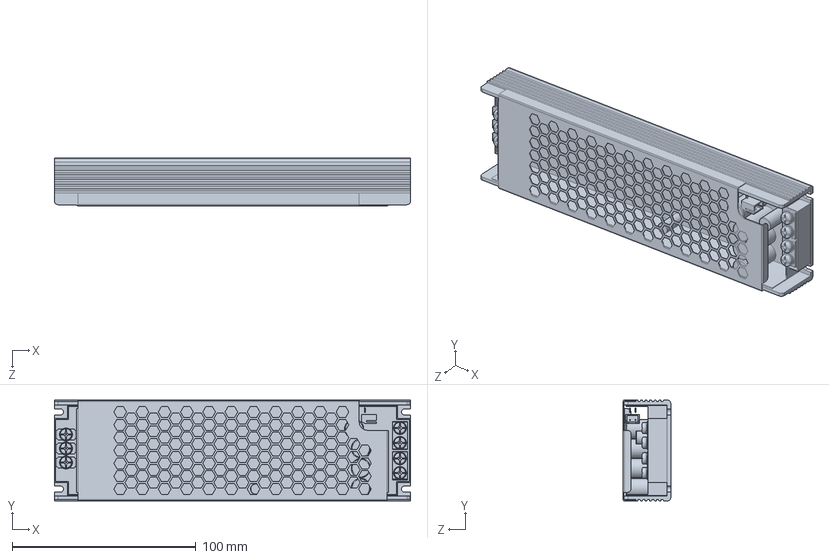
[picture p90: CAD file, 2020-06-04]
SolidWorks Files/MeanWellUHP200.SLDPRT
194.0 x 55.0 x 26.0 mm
