HARDWAREdotASTRO/Small_Radio_Telescope/SolidWorks Files/SRT CAD (updated)/USB-Kabel Stecker Typ B-02.stp

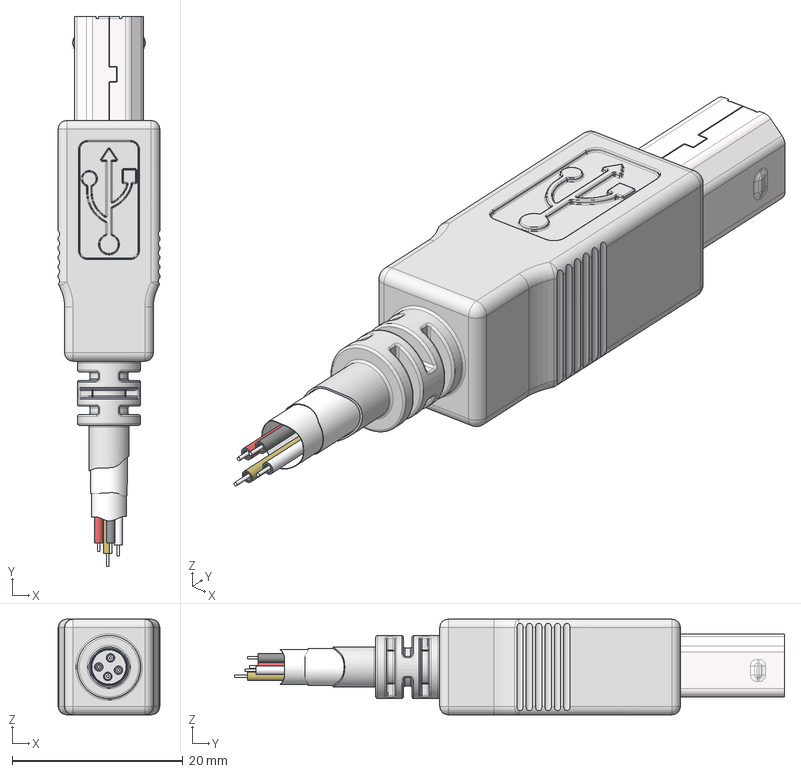
[picture p91: CAD file, 2020-08-05]
SolidWorks Files/SRT CAD (updated)/USB-Kabel Stecker Typ B-02.stp
11.9 x 64.5 x 11.2 mm
