HARDWAREdotASTRO/Small_Radio_Telescope/AdditionalSolidWorksFiles/Box2020/5vpowersup.SLDPRT

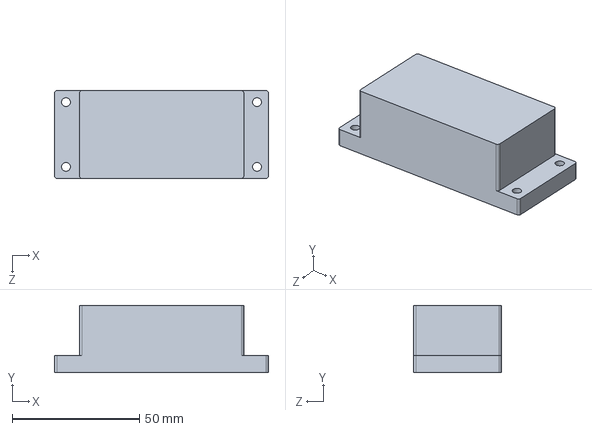
[picture p92: CAD file, 2020-06-30]
AdditionalSolidWorksFiles/Box2020/5vpowersup.SLDPRT
84.0 x 26.4 x 34.5 mm
