HARDWAREdotASTRO/Small_Radio_Telescope/AdditionalSolidWorksFiles/ProperCover/MotorCoverOUTLINE - Copy (2).SLDPRT

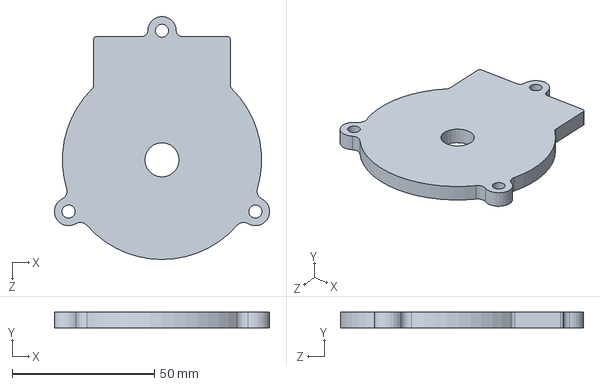
[picture p93: CAD file, 2020-06-30]
AdditionalSolidWorksFiles/ProperCover/MotorCoverOUTLINE - Copy (2).SLDPRT
75.6 x 5.59 x 85.3 mm
