HARDWAREdotASTRO/Small_Radio_Telescope/Schematics _ Datasheets/Box 2/fuzeholder.SLDPRT

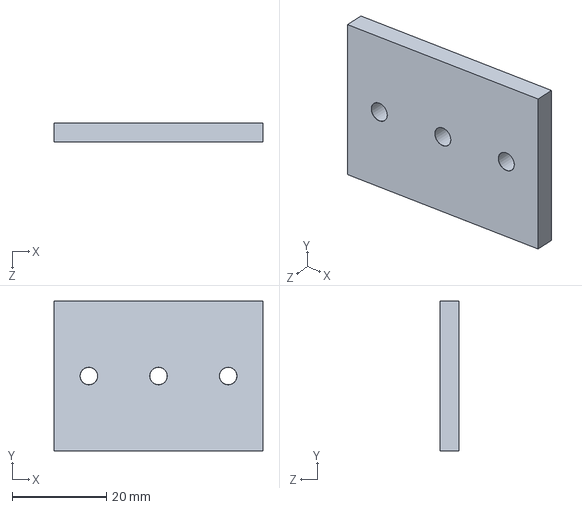
[picture p94: CAD file, 2020-06-30]
Schematics _ Datasheets/Box 2/fuzeholder.SLDPRT
44.4 x 31.8 x 4.00 mm
