HARDWAREdotASTRO/Small_Radio_Telescope/Schematics _ Datasheets/Box/151.SLDPRT

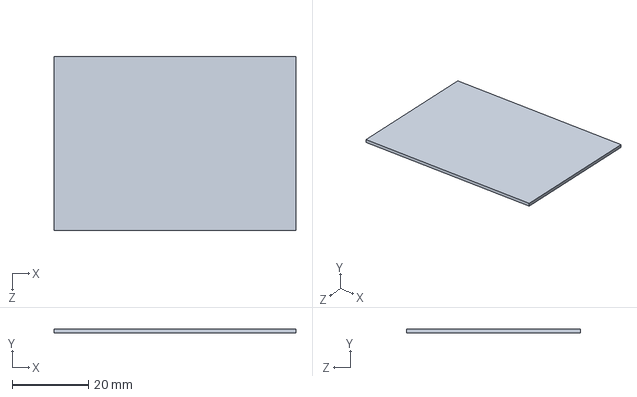
[picture p95: CAD file, 2020-06-30]
Schematics _ Datasheets/Box/151.SLDPRT
63.5 x 1.00 x 45.7 mm
