HARDWAREdotASTRO/Small_Radio_Telescope/Schematics _ Datasheets/Motor Cover/L1_093.SLDPRT

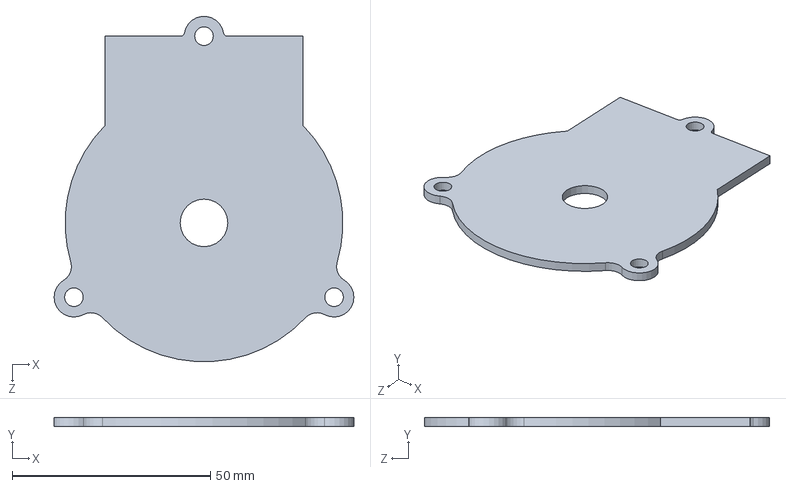
[picture p96: CAD file, 2020-06-30]
Schematics _ Datasheets/Motor Cover/L1_093.SLDPRT
75.6 x 2.38 x 86.9 mm
