HARDWAREdotASTRO/Small_Radio_Telescope/Schematics _ Datasheets/Motor Cover/Motor Cover/Part1.SLDPRT

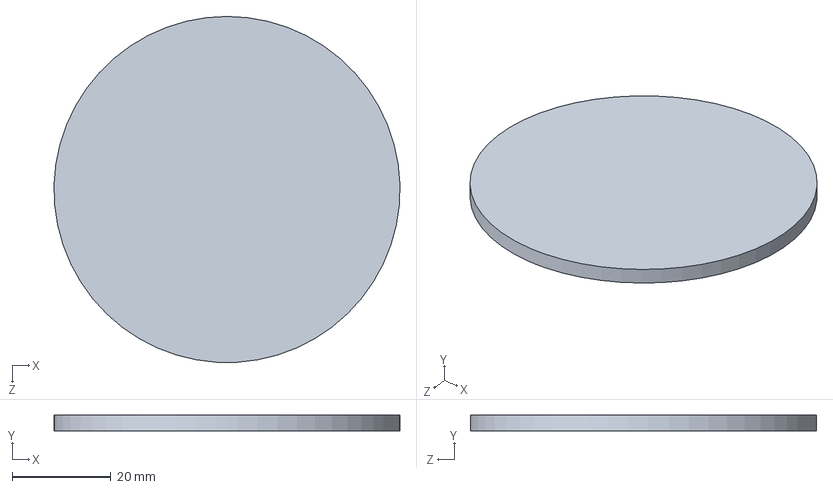
[picture p97: CAD file, 2020-06-30]
Schematics _ Datasheets/Motor Cover/Motor Cover/Part1.SLDPRT
70.0 x 3.17 x 70.0 mm
