HARDWAREdotASTRO/Small_Radio_Telescope/SolidWorks Files/SRT CAD (updated)/USB-C Male.SLDPRT

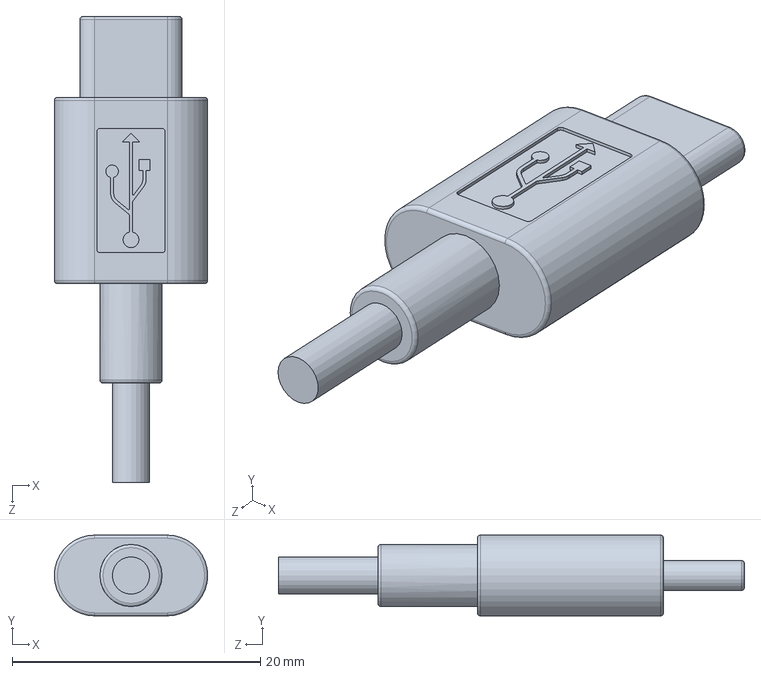
[picture p98: CAD file, 2020-08-05]
SolidWorks Files/SRT CAD (updated)/USB-C Male.SLDPRT
12.4 x 6.50 x 37.5 mm
