HARDWAREdotASTRO/Small_Radio_Telescope/AdditionalSolidWorksFiles/ProperCover/MotorCover093L3.SLDPRT

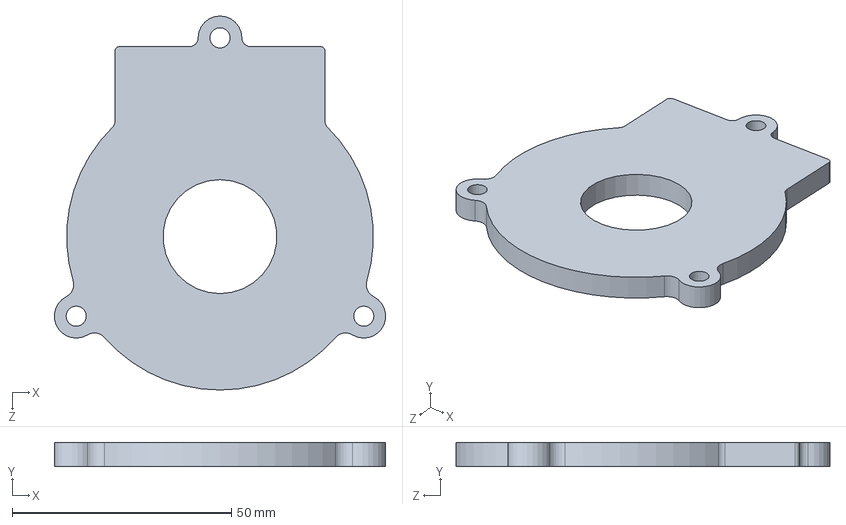
[picture p99: CAD file, 2020-06-30]
AdditionalSolidWorksFiles/ProperCover/MotorCover093L3.SLDPRT
75.6 x 5.59 x 85.3 mm
