HARDWAREdotASTRO/Small_Radio_Telescope/Schematics _ Datasheets/Box 2/Part5.SLDPRT

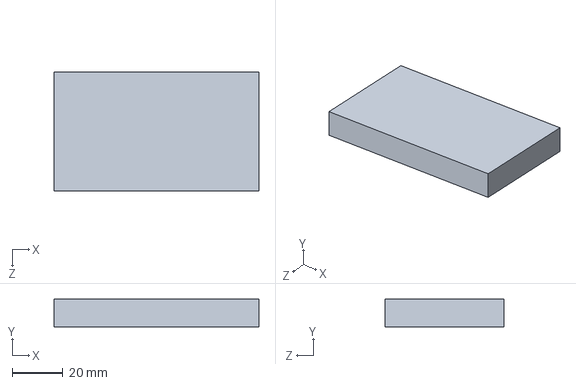
[picture p100: CAD file, 2020-06-30]
Schematics _ Datasheets/Box 2/Part5.SLDPRT
80.8 x 10.9 x 46.7 mm
