HARDWAREdotASTRO/Small_Radio_Telescope/Schematics _ Datasheets/Box/Part3.SLDPRT

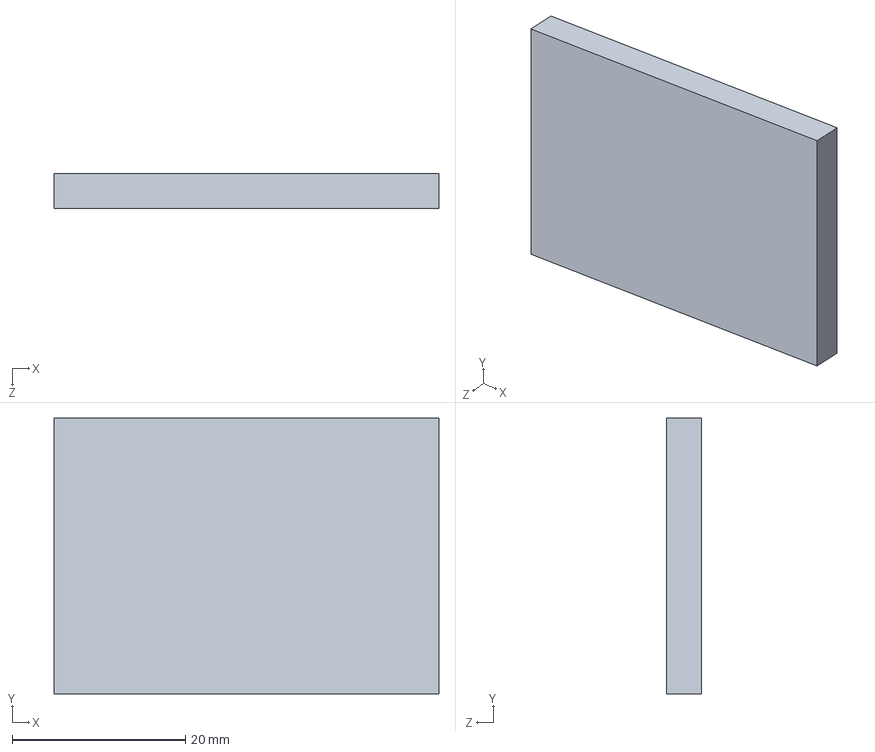
[picture p101: CAD file, 2020-06-30]
Schematics _ Datasheets/Box/Part3.SLDPRT
44.4 x 31.8 x 4.00 mm
