HARDWAREdotASTRO/Small_Radio_Telescope/Schematics _ Datasheets/Motor Cover/ReedSwitch.SLDPRT

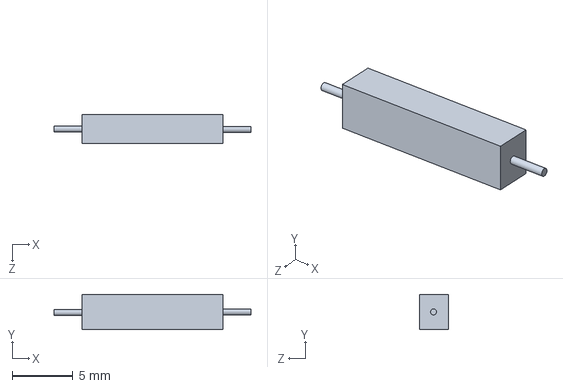
[picture p102: CAD file, 2020-06-30]
Schematics _ Datasheets/Motor Cover/ReedSwitch.SLDPRT
16.3 x 2.92 x 2.41 mm
