HARDWAREdotASTRO/Small_Radio_Telescope/SolidWorks Files/SRT CAD (updated)/USB Male.STEP

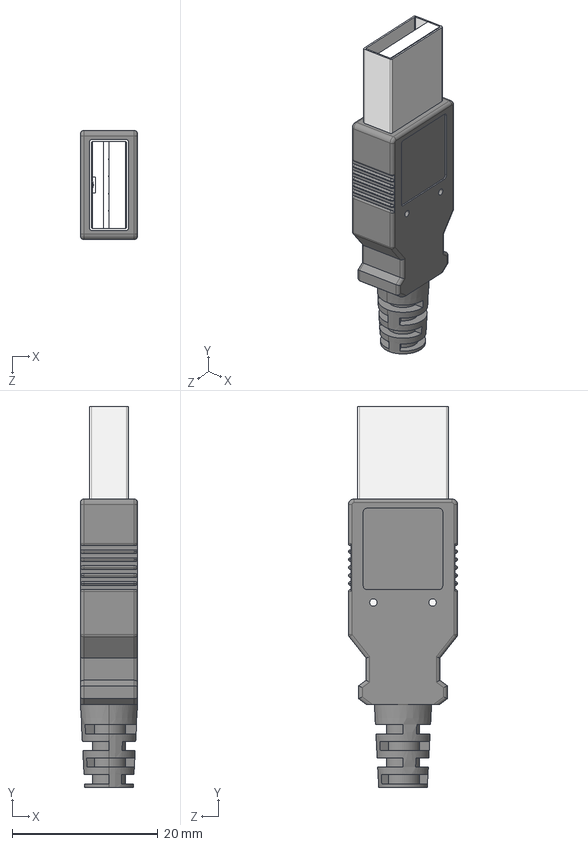
[picture p103: CAD file, 2020-08-05]
SolidWorks Files/SRT CAD (updated)/USB Male.STEP
7.87 x 52.3 x 15.0 mm
