HARDWAREdotASTRO/Small_Radio_Telescope/AdditionalSolidWorksFiles/Box2020/PowerDistBox.SLDPRT

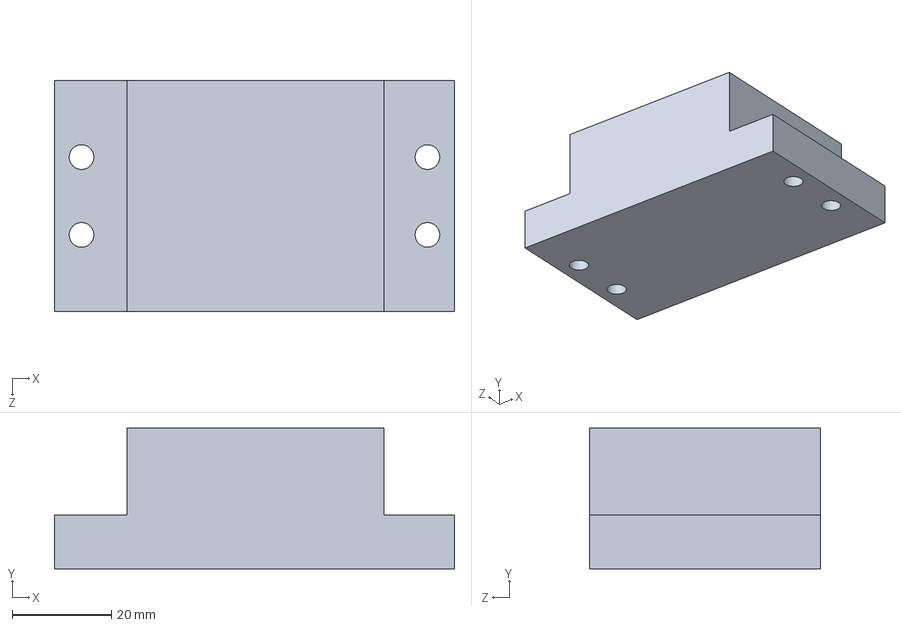
[picture p104: CAD file, 2020-06-30]
AdditionalSolidWorksFiles/Box2020/PowerDistBox.SLDPRT
80.8 x 28.4 x 46.7 mm
