HARDWAREdotASTRO/Small_Radio_Telescope/AdditionalSolidWorksFiles/ProperCover/MotorCoverOUTLINE.DXF

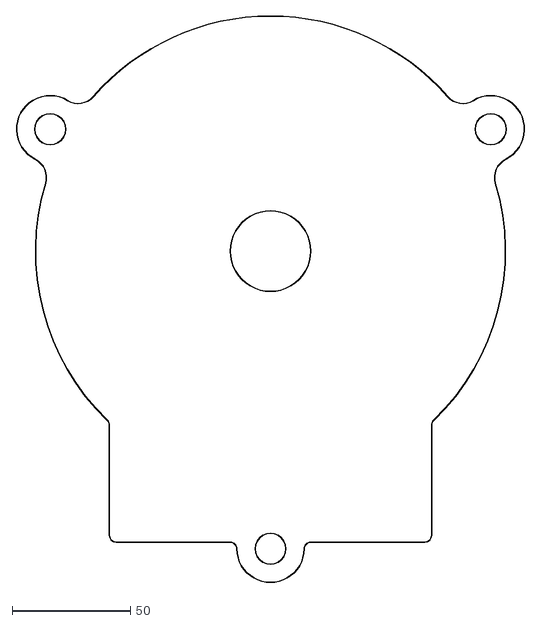
[picture p105: CAD file, 2020-06-30]
AdditionalSolidWorksFiles/ProperCover/MotorCoverOUTLINE.DXF
214.7 x 239.7
