HARDWAREdotASTRO/Small_Radio_Telescope/Schematics _ Datasheets/Box 2/clayton_sheet.SLDPRT

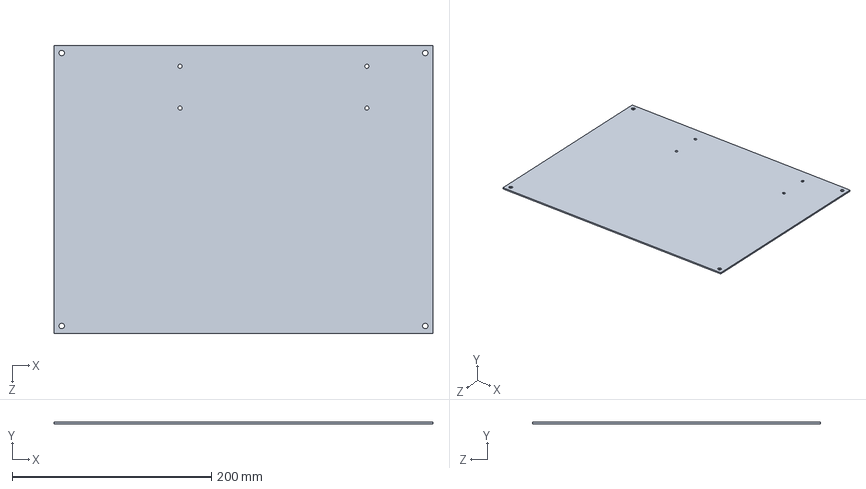
[picture p106: CAD file, 2020-06-30]
Schematics _ Datasheets/Box 2/clayton_sheet.SLDPRT
380.5 x 2.00 x 289.0 mm
