HARDWAREdotASTRO/Small_Radio_Telescope/Schematics _ Datasheets/Motor Cover/Magnet.SLDPRT

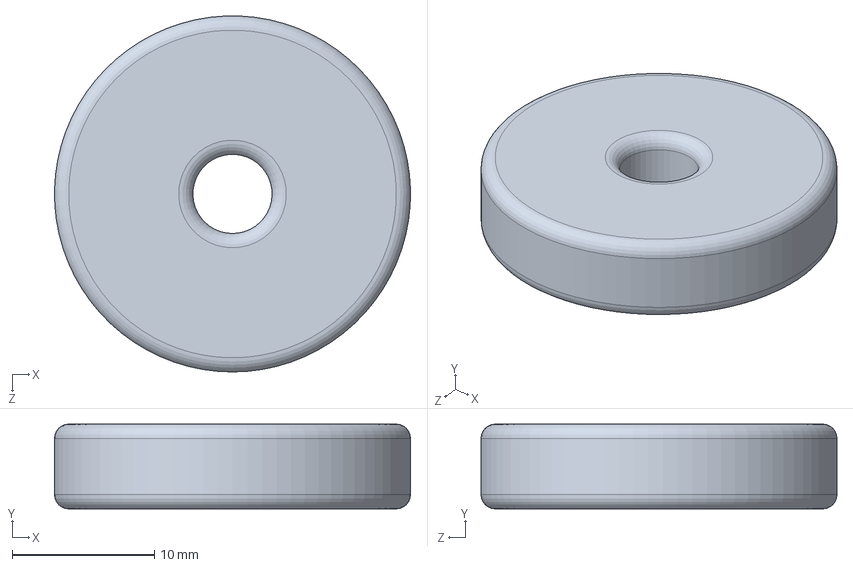
[picture p107: CAD file, 2020-06-30]
Schematics _ Datasheets/Motor Cover/Magnet.SLDPRT
25.0 x 5.95 x 25.0 mm
