HARDWAREdotASTRO/Small_Radio_Telescope/SolidWorks Files/SRT CAD (updated)/TE_1776275-2.SLDPRT

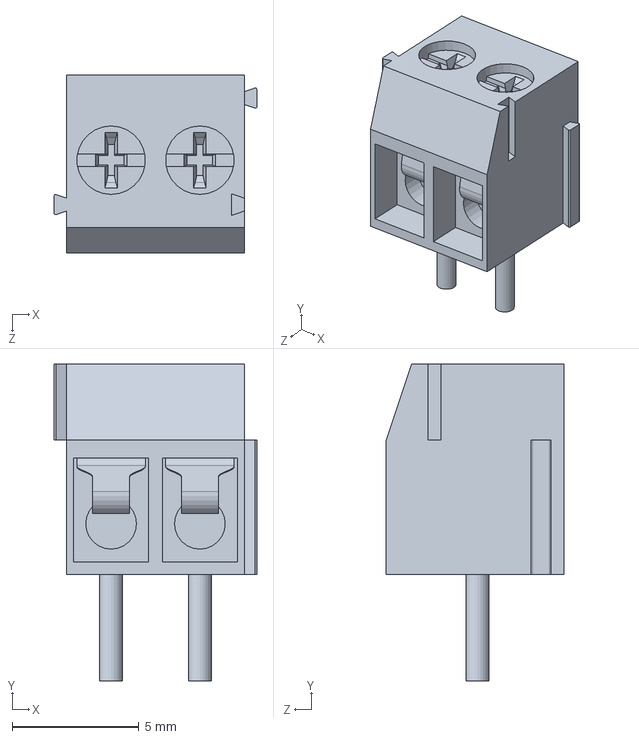
[picture p108: CAD file, 2020-08-05]
SolidWorks Files/SRT CAD (updated)/TE_1776275-2.SLDPRT
8.00 x 12.5 x 7.00 mm
