HARDWAREdotASTRO/Small_Radio_Telescope/Schematics _ Datasheets/Motor Cover/Shaft.SLDPRT

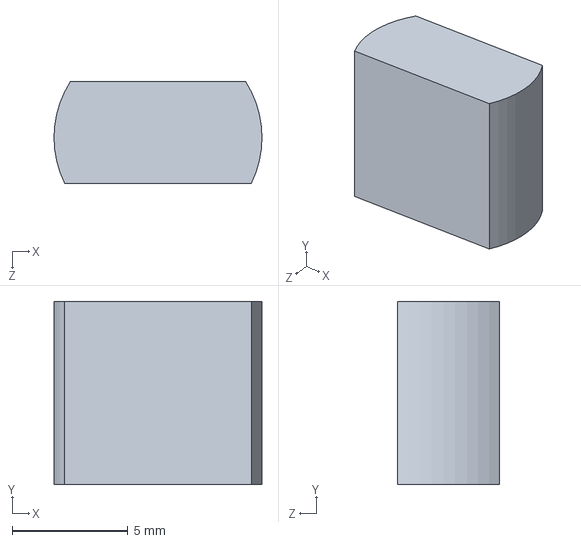
[picture p109: CAD file, 2020-06-30]
Schematics _ Datasheets/Motor Cover/Shaft.SLDPRT
9.00 x 7.94 x 4.40 mm
