HARDWAREdotASTRO/Small_Radio_Telescope/SolidWorks Files/SRT CAD (updated)/PortaFusibleCCA.SLDPRT

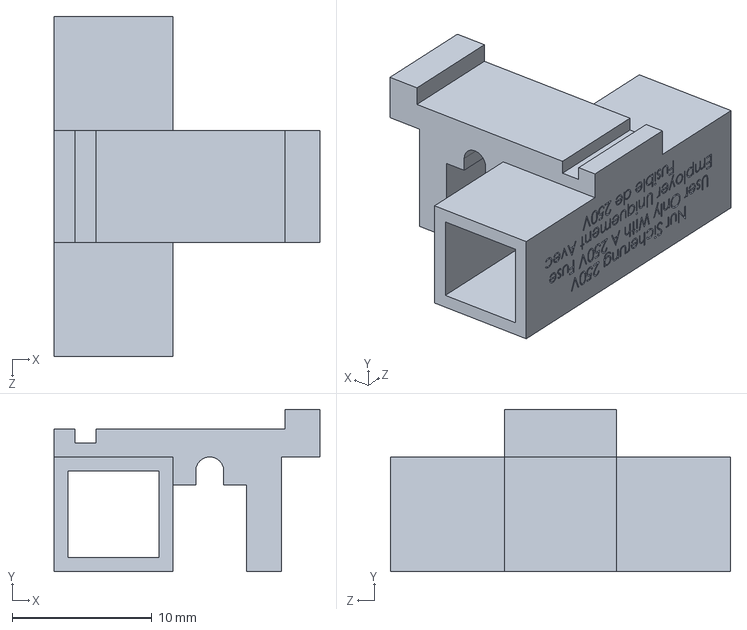
[picture p110: CAD file, 2020-08-05]
SolidWorks Files/SRT CAD (updated)/PortaFusibleCCA.SLDPRT
19.0 x 11.6 x 24.3 mm
