HARDWAREdotASTRO/Small_Radio_Telescope/Schematics _ Datasheets/Box/Power supply RS-35-24 (Meanwell).SLDPRT

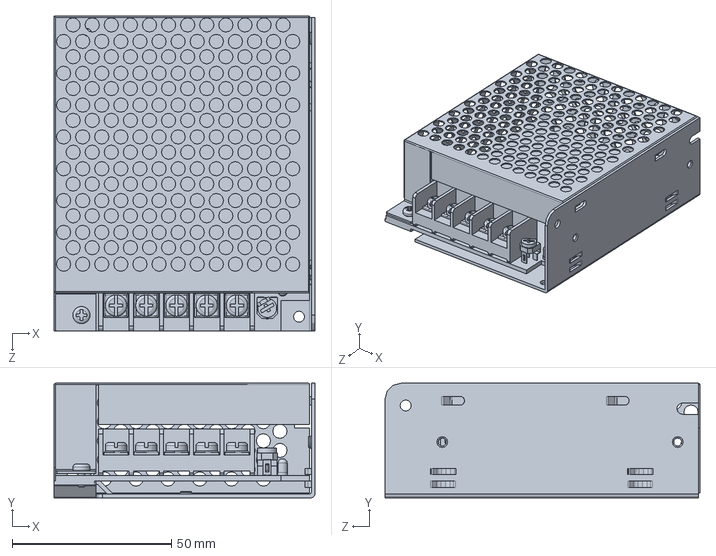
[picture p112: CAD file, 2020-06-30]
Schematics _ Datasheets/Box/Power supply RS-35-24 (Meanwell).SLDPRT
82.0 x 36.0 x 99.0 mm
