HARDWAREdotASTRO/Small_Radio_Telescope/Schematics _ Datasheets/Motor Cover/L1_220.SLDPRT

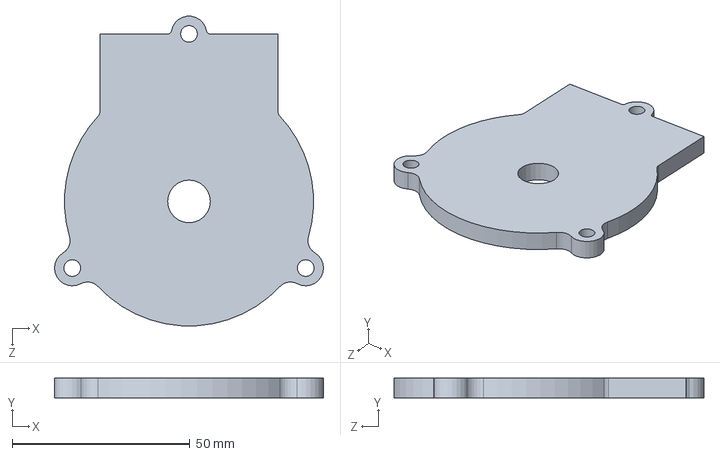
[picture p113: CAD file, 2020-06-30]
Schematics _ Datasheets/Motor Cover/L1_220.SLDPRT
75.6 x 5.59 x 86.9 mm
