HARDWAREdotASTRO/Small_Radio_Telescope/Schematics _ Datasheets/Motor Cover/Motor Cover/Part4.SLDPRT

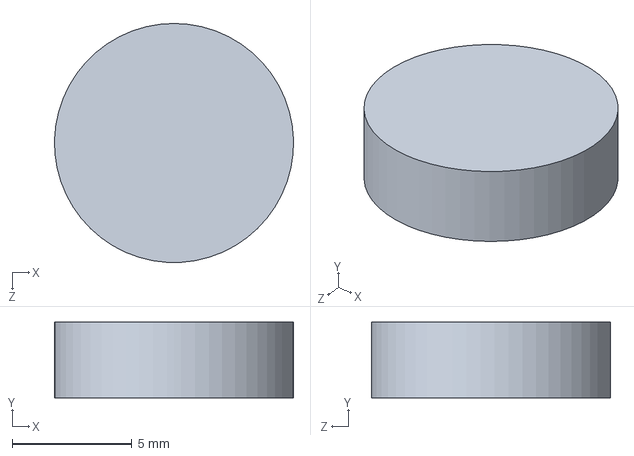
[picture p114: CAD file, 2020-06-30]
Schematics _ Datasheets/Motor Cover/Motor Cover/Part4.SLDPRT
10.00 x 3.17 x 10.0 mm
