HARDWAREdotASTRO/Small_Radio_Telescope/Schematics _ Datasheets/Box 2/Part2.SLDPRT

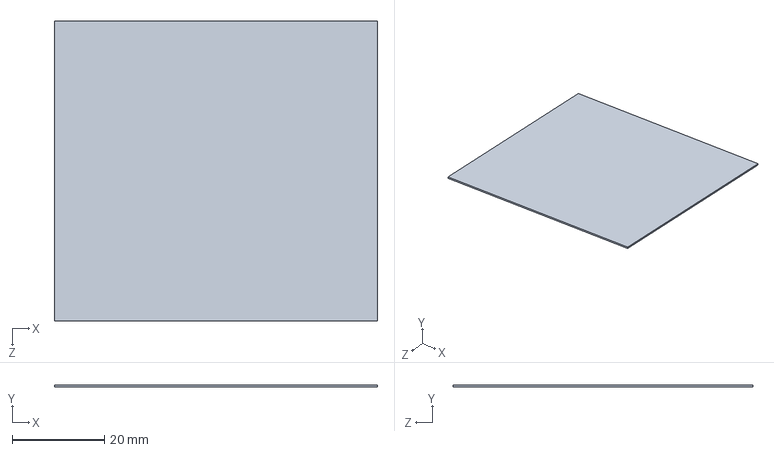
[picture p115: CAD file, 2020-06-30]
Schematics _ Datasheets/Box 2/Part2.SLDPRT
70.0 x 0.5 x 65.0 mm
