HARDWAREdotASTRO/Small_Radio_Telescope/AdditionalSolidWorksFiles/ProperCover/MotorCoverOUTLINE3.DXF

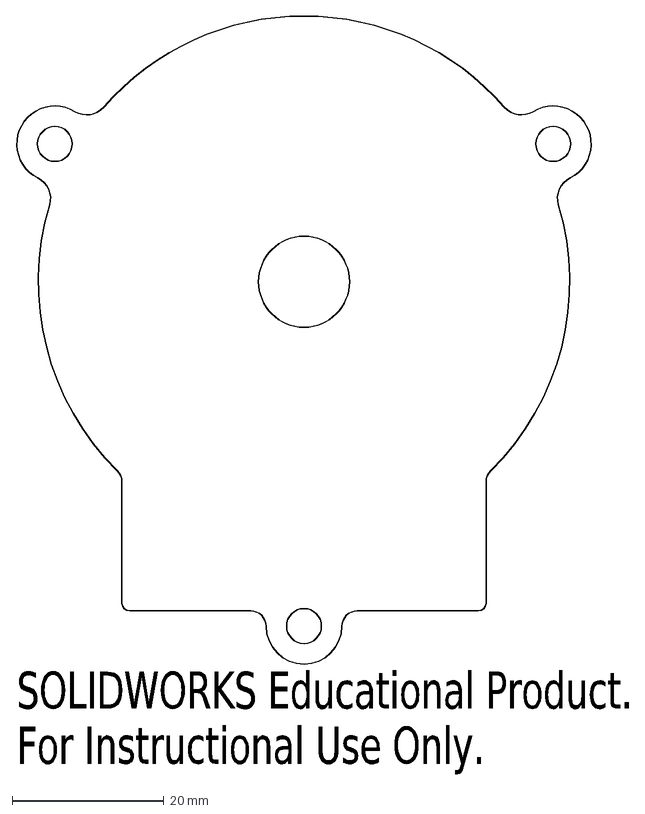
[picture p116: CAD file, 2020-06-30]
AdditionalSolidWorksFiles/ProperCover/MotorCoverOUTLINE3.DXF
SOLIDWORKS Educational Product.
For Instructional Use Only.
