HARDWAREdotASTRO/Small_Radio_Telescope/SolidWorks Files/SRT CAD (updated)/4x_Male_Pin_2.54_mm.STEP

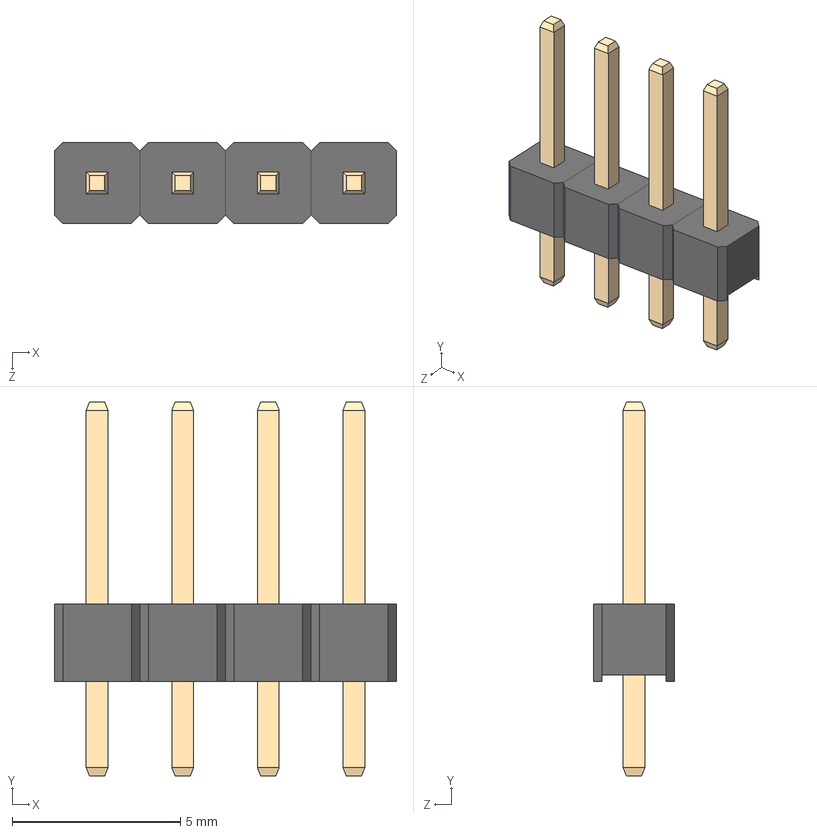
[picture p118: CAD file, 2020-08-05]
SolidWorks Files/SRT CAD (updated)/4x_Male_Pin_2.54_mm.STEP
10.2 x 11.1 x 2.40 mm
1_Male_Pin_2.54_mm x 4
