HARDWAREdotASTRO/Small_Radio_Telescope/SolidWorks Files/SRT CAD (updated)/SIL_Socket10_.stp

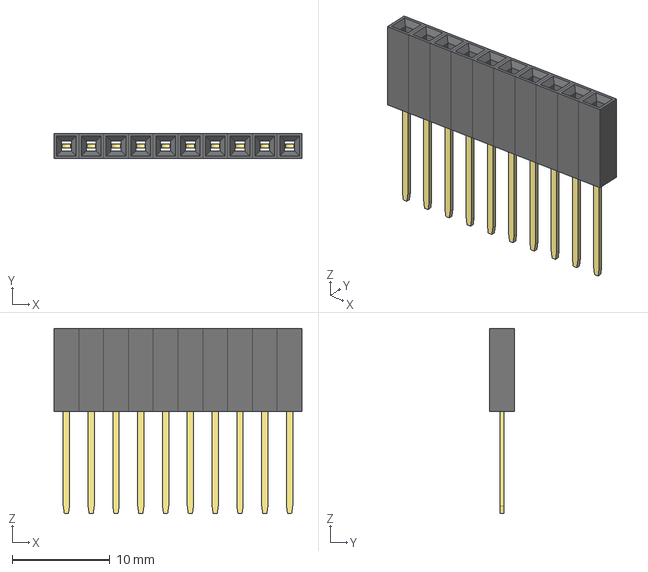
[picture p119: CAD file, 2020-08-05]
SolidWorks Files/SRT CAD (updated)/SIL_Socket10_.stp
25.4 x 2.54 x 19.0 mm
