HARDWAREdotASTRO/Small_Radio_Telescope/SolidWorks Files/SRT CAD (updated)/USB micro B.stp

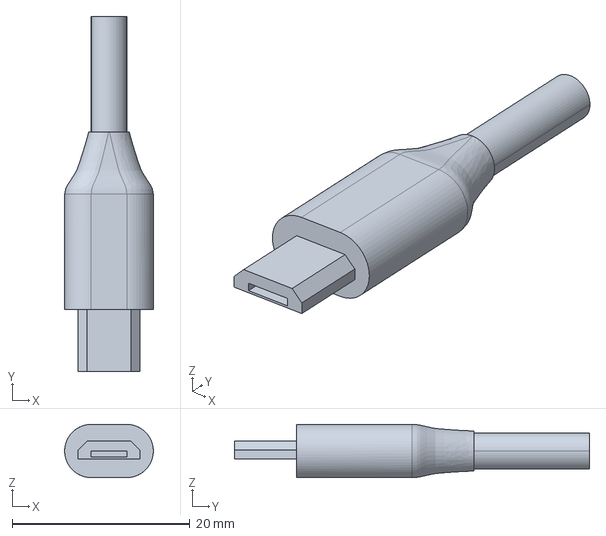
[picture p121: CAD file, 2020-08-05]
SolidWorks Files/SRT CAD (updated)/USB micro B.stp
10.0 x 40.0 x 6.00 mm
