HARDWAREdotASTRO/Small_Radio_Telescope/SolidWorks Files/SRT CAD (updated)/USB Type B.STL

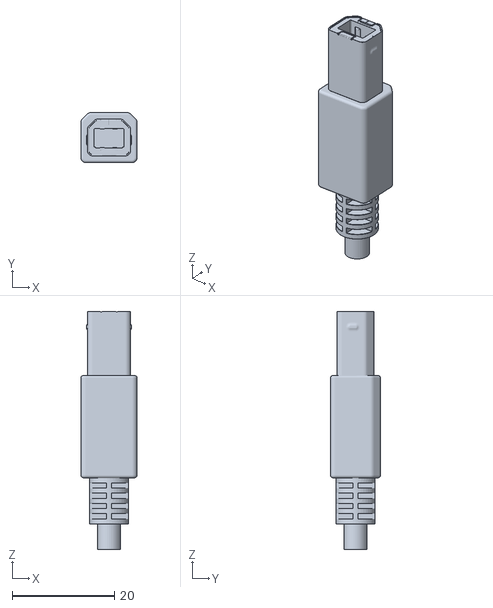
[picture p122: CAD file, 2020-08-03]
SolidWorks Files/SRT CAD (updated)/USB Type B.STL
11.0 x 9.80 x 46.5
