HARDWAREdotASTRO/Small_Radio_Telescope/SolidWorks Files/SRT CAD (updated)/USB - Type B - Male - 90°.SLDPRT

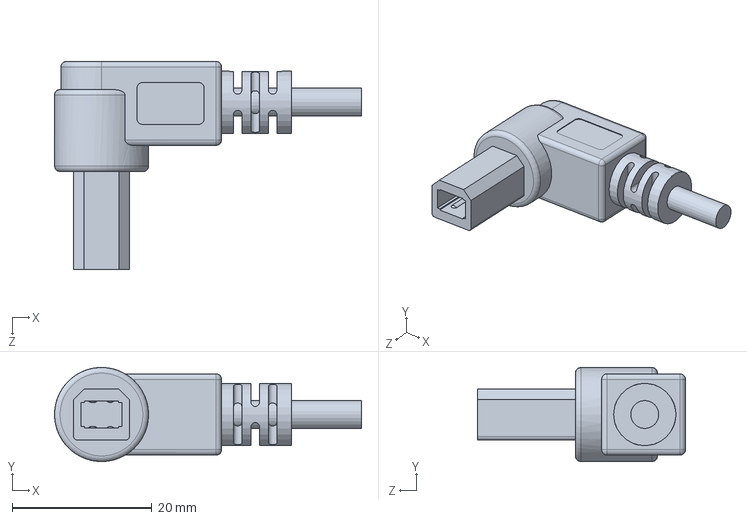
[picture p123: CAD file, 2020-08-03]
SolidWorks Files/SRT CAD (updated)/USB - Type B - Male - 90°.SLDPRT
43.9 x 13.4 x 29.8 mm
