HARDWAREdotASTRO/Small_Radio_Telescope/SolidWorks Files/SRT CAD (updated)/Part2.STEP

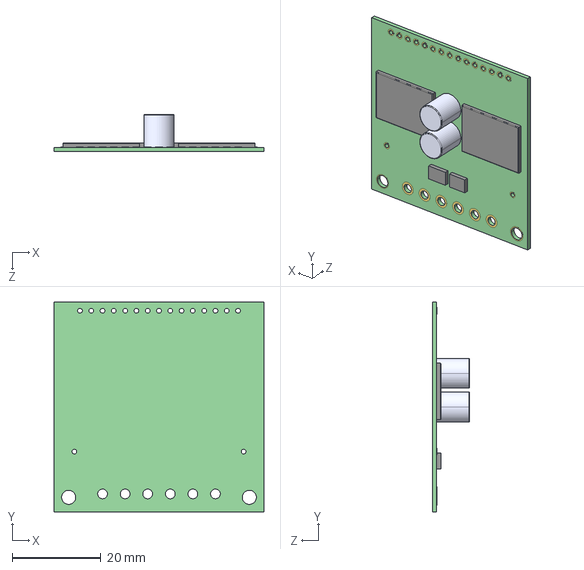
[picture p124: CAD file, 2020-08-03]
SolidWorks Files/SRT CAD (updated)/Part2.STEP
47.2 x 47.2 x 8.42 mm
