HARDWAREdotASTRO/Small_Radio_Telescope/SolidWorks Files/SRT CAD (updated)/micro_usb_plug.SLDPRT

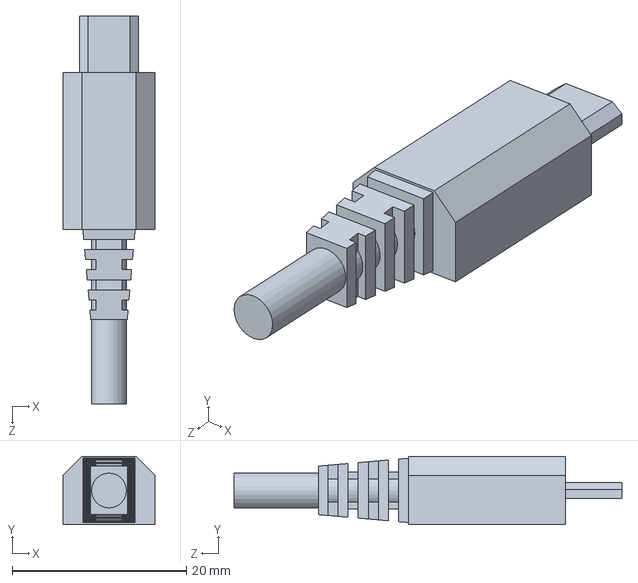
[picture p125: CAD file, 2020-08-03]
SolidWorks Files/SRT CAD (updated)/micro_usb_plug.SLDPRT
10.6 x 7.80 x 44.5 mm
