HARDWAREdotASTRO/Small_Radio_Telescope/SolidWorks Files/SRT CAD (updated)/fuse.STEP

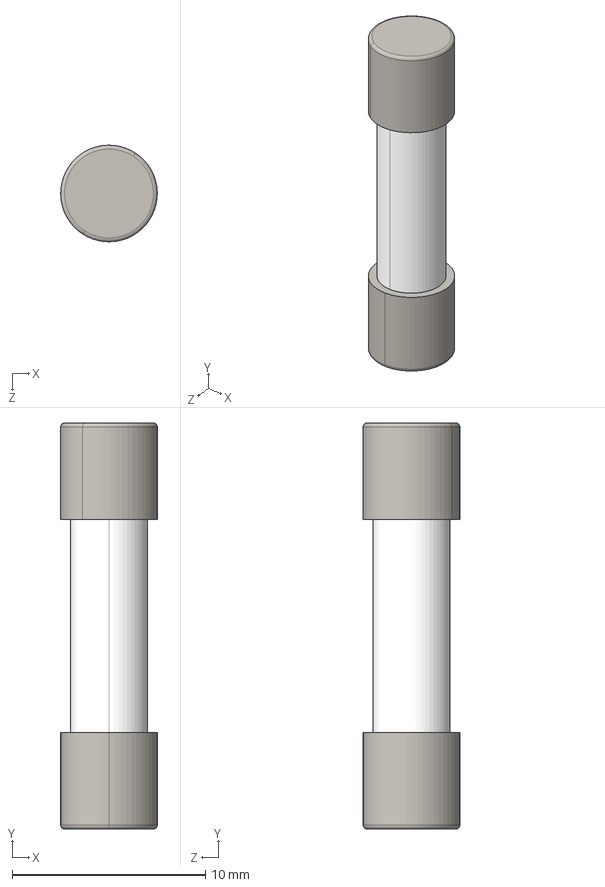
[picture p126: CAD file, 2020-08-03]
SolidWorks Files/SRT CAD (updated)/fuse.STEP
5.00 x 21.0 x 5.00 mm
