HARDWAREdotASTRO/Small_Radio_Telescope/SolidWorks Files/SRT CAD (updated)/Fuse Holders SMD 5x20mm + Fuse.stp

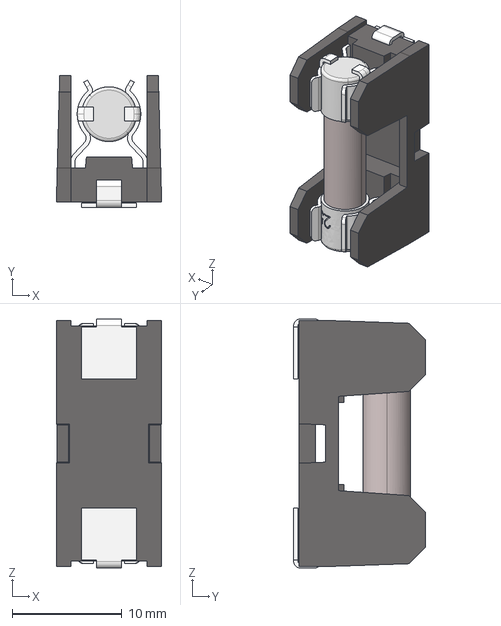
[picture p127: CAD file, 2020-08-03]
SolidWorks Files/SRT CAD (updated)/Fuse Holders SMD 5x20mm + Fuse.stp
9.60 x 12.0 x 22.7 mm
