HARDWAREdotASTRO/Small_Radio_Telescope/SolidWorks Files/SRT CAD (updated)/Fuse Holder - CONQUER CQ-201N_.stp

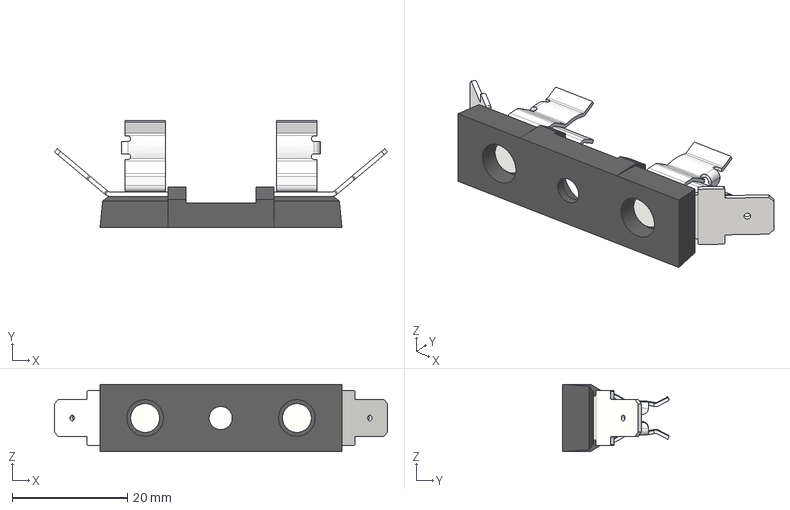
[picture p128: CAD file, 2020-08-03]
SolidWorks Files/SRT CAD (updated)/Fuse Holder - CONQUER CQ-201N_.stp
57.7 x 18.5 x 11.7 mm
Fuse Holder Base
Fuse Holder Terminal End Plate x 2
Fuse Holder Clamp x 2
Fuse Holder Pin x 2
