HARDWAREdotASTRO/Small_Radio_Telescope/SolidWorks Files/SRT CAD (updated)/female_header_a-bl254-eg-g02d.stp

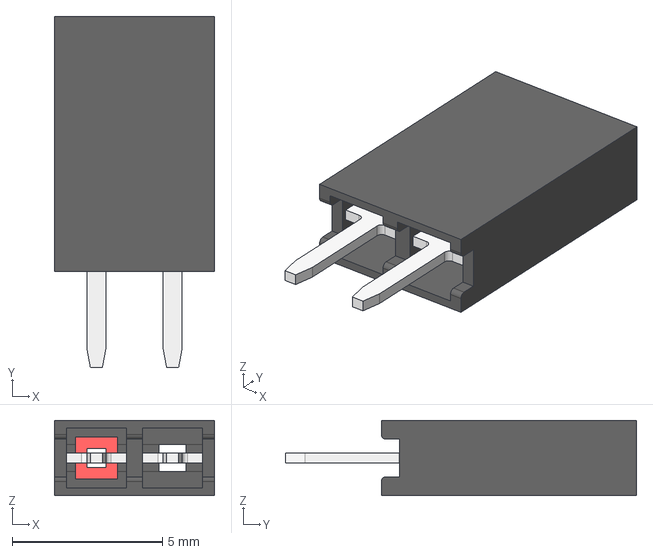
[picture p129: CAD file, 2020-08-03]
SolidWorks Files/SRT CAD (updated)/female_header_a-bl254-eg-g02d.stp
5.33 x 11.7 x 2.50 mm
