HARDWAREdotASTRO/Small_Radio_Telescope/SolidWorks Files/SRT CAD (updated)/EXUUNN EX636-7.26 3-Port v3.step

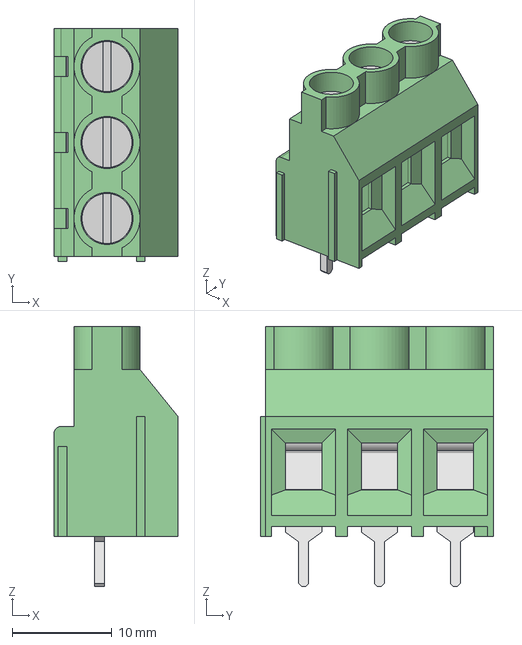
[picture p130: CAD file, 2020-08-03]
SolidWorks Files/SRT CAD (updated)/EXUUNN EX636-7.26 3-Port v3.step
12.4 x 23.3 x 26.0 mm
