HARDWAREdotASTRO/Small_Radio_Telescope/SolidWorks Files/SRT CAD (updated)/cembre_RF-M3.step

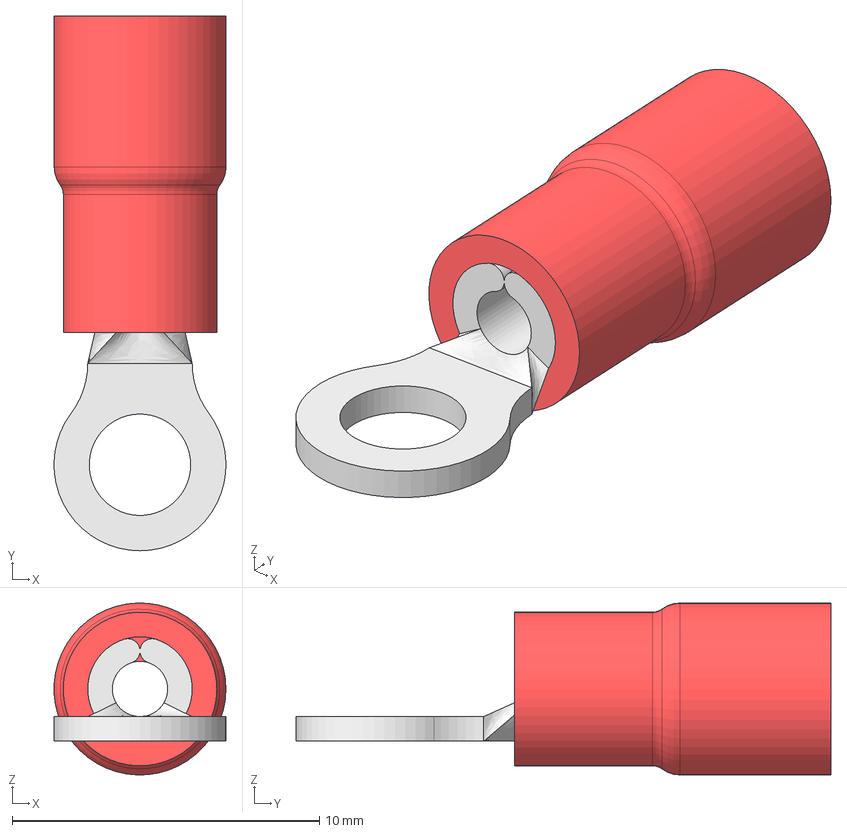
[picture p131: CAD file, 2020-08-03]
SolidWorks Files/SRT CAD (updated)/cembre_RF-M3.step
5.60 x 17.4 x 5.60 mm
