HARDWAREdotASTRO/Small_Radio_Telescope/SolidWorks Files/SRT CAD (updated)/cembre_BF-M3.step

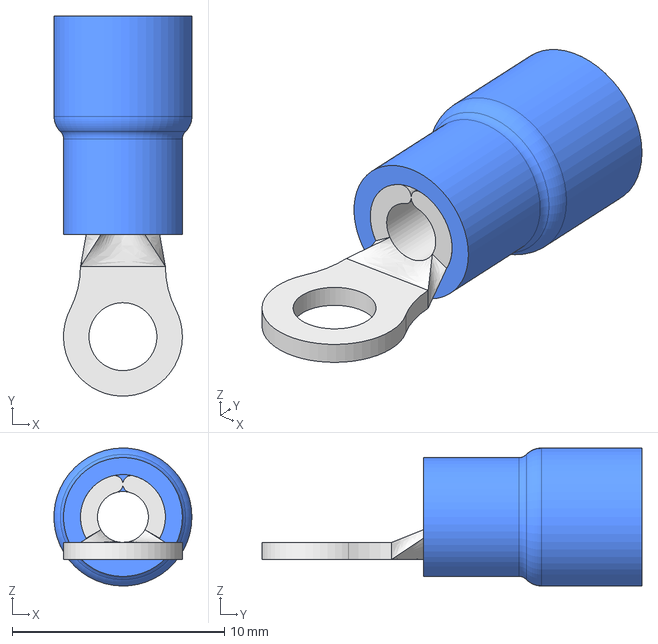
[picture p132: CAD file, 2020-08-03]
SolidWorks Files/SRT CAD (updated)/cembre_BF-M3.step
6.49 x 17.9 x 6.50 mm
