HARDWAREdotASTRO/Small_Radio_Telescope/SolidWorks Files/SRT CAD (updated)/8x_Male_Pin_2.54_mm.STEP

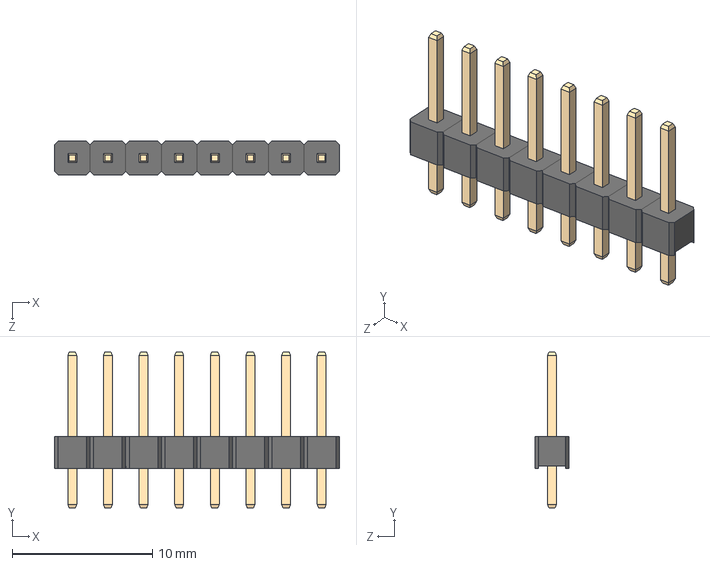
[picture p133: CAD file, 2020-08-03]
SolidWorks Files/SRT CAD (updated)/8x_Male_Pin_2.54_mm.STEP
20.3 x 11.1 x 2.40 mm
1_Male_Pin_2.54_mm x 8
