HARDWAREdotASTRO/Small_Radio_Telescope/SolidWorks Files/SRT CAD (updated)/2x_Male_Pin_2.54_mm.STEP

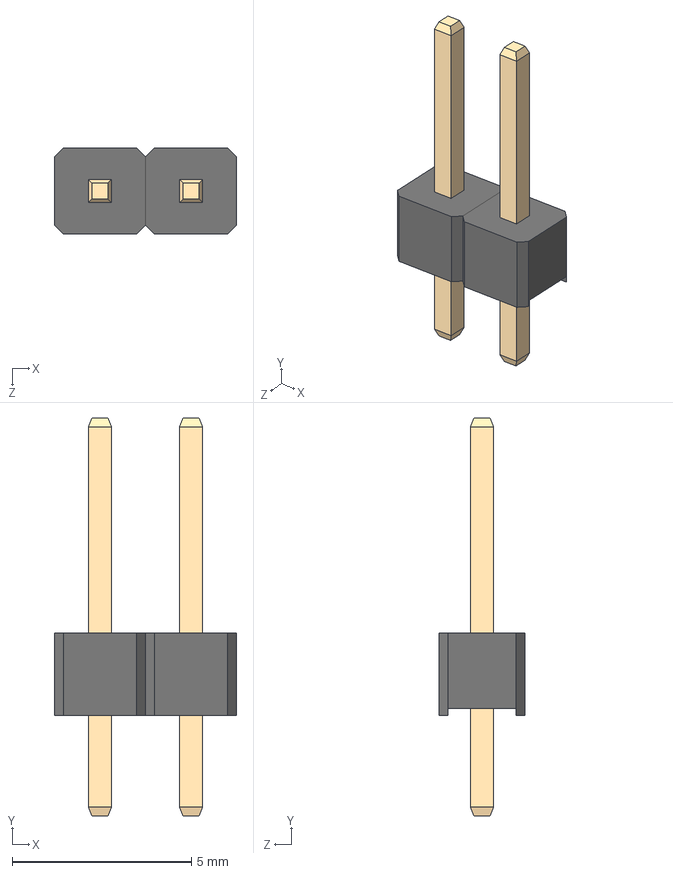
[picture p134: CAD file, 2020-08-03]
SolidWorks Files/SRT CAD (updated)/2x_Male_Pin_2.54_mm.STEP
5.08 x 11.1 x 2.40 mm
1_Male_Pin_2.54_mm x 2
