HARDWAREdotASTRO/Small_Radio_Telescope/(list of files, cad)

Other CAD files:
SolidWorks Files/CAD wires/RouteAssy_6-hardwareBoxTemplate.sldasm
SolidWorks Files/CAD wires/Harness_36-hardwareBoxTemplate-001.sldasm
AdditionalSolidWorksFiles/Box2020/MW RS-15-5.SLDASM
SolidWorks Files/CAD wires/Harness_35-hardwareBoxTemplate.sldasm
SolidWorks Files/CAD wires/Harness_27-hardwareBoxTemplate.sldasm
SolidWorks Files/CAD wires/Harness_21-hardwareBoxTemplate.sldasm
SolidWorks Files/CAD wires/Harness_10-hardwareBoxTemplate.sldasm
SolidWorks Files/CAD wires/Harness_8-hardwareBoxTemplate-001.sldasm
SolidWorks Files/CAD wires/Harness_8-hardwareBoxTemplate.sldasm
SolidWorks Files/CAD wires/Harness_3-hardwareBoxTemplate.sldasm
SolidWorks Files/CAD wires/Harness_2-hardwareBoxTemplate.sldasm
SolidWorks Files/CAD wires/Cable_44-hardwareBoxTemplate.sldasm
SolidWorks Files/CAD wires/Cable_43-hardwareBoxTemplate.sldasm
SolidWorks Files/CAD wires/Cable_42-hardwareBoxTemplate.sldasm
SolidWorks Files/CAD wires/Cable_41-hardwareBoxTemplate.sldasm
SolidWorks Files/CAD wires/Cable_39-hardwareBoxTemplate-002.sldasm
SolidWorks Files/CAD wires/Cable_37-hardwareBoxTemplate.sldasm
SolidWorks Files/CAD wires/Cable_36-hardwareBoxTemplate.sldasm
SolidWorks Files/CAD wires/Cable_34-hardwareBoxTemplate-001.sldasm
SolidWorks Files/CAD wires/Cable_34-hardwareBoxTemplate.sldasm
SolidWorks Files/CAD wires/Cable_33-hardwareBoxTemplate.sldasm
SolidWorks Files/CAD wires/Cable_32-hardwareBoxTemplate.sldasm
SolidWorks Files/CAD wires/Cable_31-hardwareBoxTemplate.sldasm
SolidWorks Files/CAD wires/Cable_26-hardwareBoxTemplate.sldasm
SolidWorks Files/CAD wires/Cable_25-hardwareBoxTemplate.sldasm
SolidWorks Files/CAD wires/Cable_24-hardwareBoxTemplate-002.sldasm
SolidWorks Files/CAD wires/Cable_24-hardwareBoxTemplate-001.sldasm
SolidWorks Files/CAD wires/Cable_24-hardwareBoxTemplate.sldasm
SolidWorks Files/CAD wires/Cable_23-hardwareBoxTemplate.sldasm
SolidWorks Files/CAD wires/Cable_22-hardwareBoxTemplate.sldasm
SolidWorks Files/CAD wires/Cable_21-hardwareBoxTemplate-001.sldasm
SolidWorks Files/CAD wires/Cable_21-hardwareBoxTemplate.sldasm
SolidWorks Files/CAD wires/Cable_20-hardwareBoxTemplate.sldasm
SolidWorks Files/CAD wires/Cable_18-hardwareBoxTemplate-001.sldasm
SolidWorks Files/CAD wires/Cable_18-hardwareBoxTemplate.sldasm
SolidWorks Files/CAD wires/Cable_16-hardwareBoxTemplate.sldasm
SolidWorks Files/CAD wires/Cable_14-hardwareBoxTemplate-001.sldasm
SolidWorks Files/CAD wires/Cable_14-hardwareBoxTemplate.sldasm
SolidWorks Files/CAD wires/Cable_12-hardwareBoxTemplate-004.sldasm
SolidWorks Files/CAD wires/Cable_12-hardwareBoxTemplate-003.sldasm
SolidWorks Files/CAD wires/Cable_12-hardwareBoxTemplate-002.sldasm
SolidWorks Files/CAD wires/Cable_12-hardwareBoxTemplate-001.sldasm
SolidWorks Files/CAD wires/Cable_12-hardwareBoxTemplate.sldasm
SolidWorks Files/CAD wires/Cable_11-hardwareBoxTemplate.sldasm
SolidWorks Files/CAD wires/Cable_11-hardwareBoxTemplate-001.sldasm
SolidWorks Files/CAD wires/Cable_10-hardwareBoxTemplate-002.sldasm
SolidWorks Files/CAD wires/Cable_10-hardwareBoxTemplate-001.sldasm
SolidWorks Files/CAD wires/Cable_8-hardwareBoxTemplate.sldasm
SolidWorks Files/CAD wires/Harness_38-hardwareBoxTemplate.sldasm
SolidWorks Files/CAD wires/Harness_36-hardwareBoxTemplate.sldasm
SolidWorks Files/CAD wires/Harness_34-hardwareBoxTemplate.sldasm
SolidWorks Files/CAD wires/Harness_12-hardwareBoxTemplate.sldasm
SolidWorks Files/CAD wires/Harness_8-hardwareBoxTemplate-002.sldasm
SolidWorks Files/CAD wires/Cable_40-hardwareBoxTemplate.sldasm
SolidWorks Files/CAD wires/Cable_39-hardwareBoxTemplate-001.sldasm
SolidWorks Files/CAD wires/Cable_39-hardwareBoxTemplate.sldasm
SolidWorks Files/CAD wires/Cable_23-hardwareBoxTemplate-001.sldasm
SolidWorks Files/CAD wires/Cable_19-hardwareBoxTemplate.sldasm
SolidWorks Files/CAD wires/Cable_17-hardwareBoxTemplate.sldasm
SolidWorks Files/CAD wires/Cable_15-hardwareBoxTemplate.sldasm
SolidWorks Files/CAD wires/Cable_13-hardwareBoxTemplate.sldasm
SolidWorks Files/CAD wires/Cable_10-hardwareBoxTemplate.sldasm
SolidWorks Files/SRT CAD (updated)/Box.SLDASM
AdditionalSolidWorksFiles/ProperCover/MotorCoverOUTLINE - Copy.SLDPRT
Schematics _ Datasheets/Motor Cover/MotorCoverOUTLINE.SLDPRT
AdditionalSolidWorksFiles/ProperCover/MotorCover220L4.SLDPRT
AdditionalSolidWorksFiles/ProperCover/MotorCover220L1.SLDPRT
Schematics _ Datasheets/Box/MeanWellUHP200.SLDPRT
Schematics _ Datasheets/Motor Cover/Motor Cover/Part3.SLDPRT
SolidWorks Files/SRT CAD (updated)/MeanWellUHP200.SLDPRT
AdditionalSolidWorksFiles/ProperCover/MotorCover093L2.SLDPRT
Schematics _ Datasheets/Box/clayton_sheet.SLDPRT
AdditionalSolidWorksFiles/ProperCover/MotorCoverOuterLayer.SLDPRT
Schematics _ Datasheets/Box 2/MeanWellUHP200.SLDPRT
SolidWorks Files/SRT CAD (updated)/MW RS-15-5.STEP
SolidWorks Files/SRT CAD (updated)/clayton_sheet.SLDPRT
AdditionalSolidWorksFiles/Box Parts/MW RS-15-5.SLDPRT
AdditionalSolidWorksFiles/ProperCover/MotorCover093L3.DXF
AdditionalSolidWorksFiles/ProperCover/MotorCover220L1.DXF
AdditionalSolidWorksFiles/ProperCover/MotorCover220L4.DXF
Research/PN01007-38/PN01007-38.iges
Schematics _ Datasheets/Box/Assem1.SLDPRT
Schematics _ Datasheets/Box/screw stuff/2.5-91292A010_TYPE 18-8 SS SOCKET HEAD CAP SCREW.SLDPRT
Schematics _ Datasheets/Box/screw stuff/2.5-93655A096_MALE-FEM THRDED HEX STANDOFF.SLDPRT
Schematics _ Datasheets/Box/screw stuff/2.5-96439A470_18-8 SS PRESS-FIT NUT FOR SHEET METAL.SLDPRT
Schematics _ Datasheets/Box/screw stuff/3short93655A416_MALE-FEM THRDED HEX STANDOFF.SLDPRT
Schematics _ Datasheets/Box/screw stuff/4-93655A703_MALE-FEM THRDED HEX STANDOFF.SLDPRT
Schematics _ Datasheets/Box/screw stuff/4-96439A650_18-8 SS PRESS-FIT NUT FOR SHEET METAL.SLDPRT
Schematics _ Datasheets/Box/screw stuff/90751A110_METRIC FINE-THREAD 18-18 SS SOCKET HEAD SCREW.SLDPRT
Schematics _ Datasheets/Box/screw stuff/93655A091_MALE-FEM THRDED HEX STANDOFF.SLDPRT
Schematics _ Datasheets/Box/screw stuff/93655A097_MALE-FEM THRDED HEX STANDOFF (1).SLDPRT
Schematics _ Datasheets/Box/screw stuff/96439A530_18-8 SS PRESS-FIT NUT FOR SHEET METAL.SLDPRT
Schematics _ Datasheets/Motor Cover/93655A416_MALE-FEM THRDED HEX STANDOFF.SLDPRT
Schematics _ Datasheets/Motor Cover/L1_220.DXF
Schematics _ Datasheets/Motor Cover/Motor Cover/93655A416_MALE-FEM THRDED HEX STANDOFF.SLDPRT
Schematics _ Datasheets/Motor Cover/Old/CoverAssembly.SLDASM
Schematics _ Datasheets/Motor Cover/Old/NewCover080L1.SLDPRT
Schematics _ Datasheets/Motor Cover/Old/NewCover080L2.SLDPRT
Schematics _ Datasheets/Motor Cover/Old/NewCover093L1.SLDPRT
Schematics _ Datasheets/Motor Cover/Old/NewCover093L2.DXF
Schematics _ Datasheets/Motor Cover/Old/NewCover093L2.SLDPRT
Schematics _ Datasheets/Motor Cover/Old/NewCover1.SLDPRT
Schematics _ Datasheets/Motor Cover/Old/NewCover118L2.SLDPRT
Schematics _ Datasheets/Motor Cover/Old/NewCover2.SLDPRT
Schematics _ Datasheets/Motor Cover/Old/NewCover220.DXF
Schematics _ Datasheets/Motor Cover/Old/NewCover220.SLDPRT
Schematics _ Datasheets/Motor Cover/Old/NewCover220L2.SLDPRT
Schematics _ Datasheets/Motor Cover/Old/NewCoverMagnetSlot080.SLDPRT
Schematics _ Datasheets/Motor Cover/Old/NewCoverMagnetSlot118.SLDPRT
Schematics _ Datasheets/Motor Cover/Old/NewCoverMagnetSlot220.DXF
Schematics _ Datasheets/Motor Cover/Old/NewCoverMagnetSlot220.SLDPRT
Schematics _ Datasheets/Motor Cover/Old/Part3.SLDPRT
Schematics _ Datasheets/Motor Cover/Old/Part4.SLDPRT
Schematics _ Datasheets/Motor Cover/Old/TestNewCover093L1.DXF
SolidWorks Files/SRT CAD (updated)/3ScrewTerminal.SLDPRT
SolidWorks Files/SRT CAD (updated)/4294K120_VERSA-MOUNT UL CLASS FUSE BLOCK.SLDPRT
SolidWorks Files/SRT CAD (updated)/6797T140_WASHDOWN ROCKER SWITCH.SLDPRT
SolidWorks Files/SRT CAD (updated)/6way screw terminal.SLDPRT
SolidWorks Files/SRT CAD (updated)/7010K114_WALL-MOUNT TRANSFORMER.SLDPRT
SolidWorks Files/SRT CAD (updated)/8173T120_SPACE SAVER TERMINAL BLOCK.SLDPRT
SolidWorks Files/SRT CAD (updated)/90618A113_MIL SPEC. BLK-OXIDE 300 SERIES SS FLAT WASHER.SLDPRT
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
