HARDWAREdotASTRO/Small_Radio_Telescope/ArduinoTestFiles/SmallRadioTelescope/Code/PythonCode/CodeGifs/DashDaqBasicTutorial2.gif

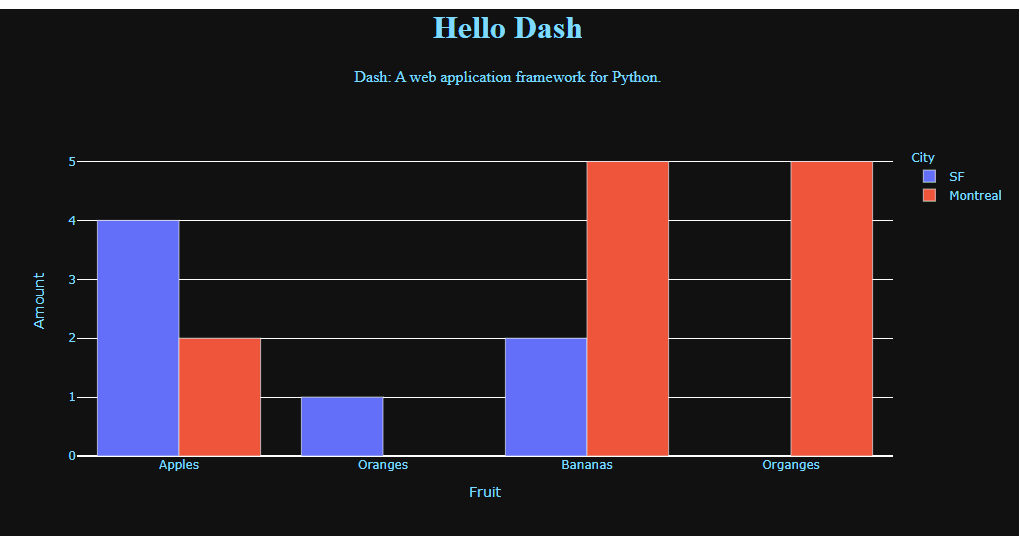
ArduinoTestFiles/SmallRadioTelescope/Code/PythonCode/CodeGifs/DashDaqBasicTutorial2.gif
