HARDWAREdotASTRO/Small_Radio_Telescope/ArduinoTestFiles/SmallRadioTelescope/Code/PythonCode/CodeGifs/DashDaqBasicTutorial3.gif

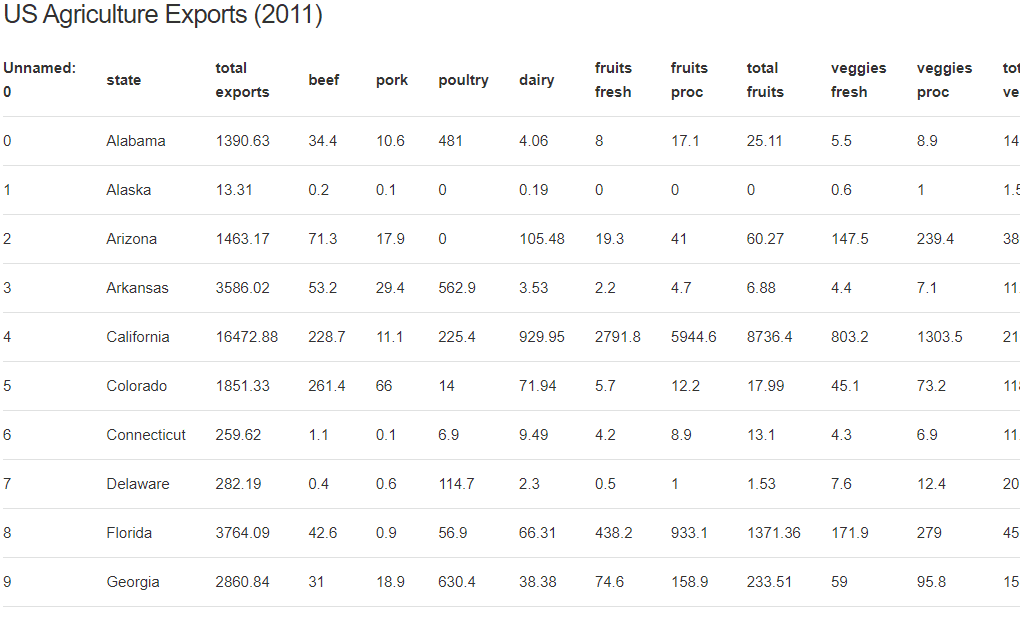
ArduinoTestFiles/SmallRadioTelescope/Code/PythonCode/CodeGifs/DashDaqBasicTutorial3.gif
