HARDWAREdotASTRO/Small_Radio_Telescope/ArduinoTestFiles/SmallRadioTelescope/Code/PythonCode/CodeGifs/DashDaqBasicTutorial4.gif

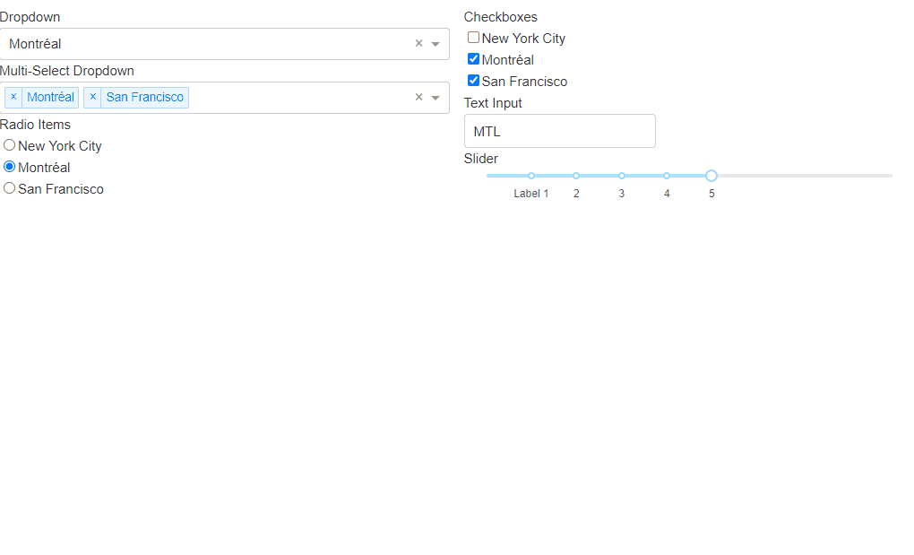
ArduinoTestFiles/SmallRadioTelescope/Code/PythonCode/CodeGifs/DashDaqBasicTutorial4.gif
