HARDWAREdotASTRO/Small_Radio_Telescope/ArduinoTestFiles/SmallRadioTelescope/Code/PythonCode/CodeGifs/DashDaqBasicTutorial.gif

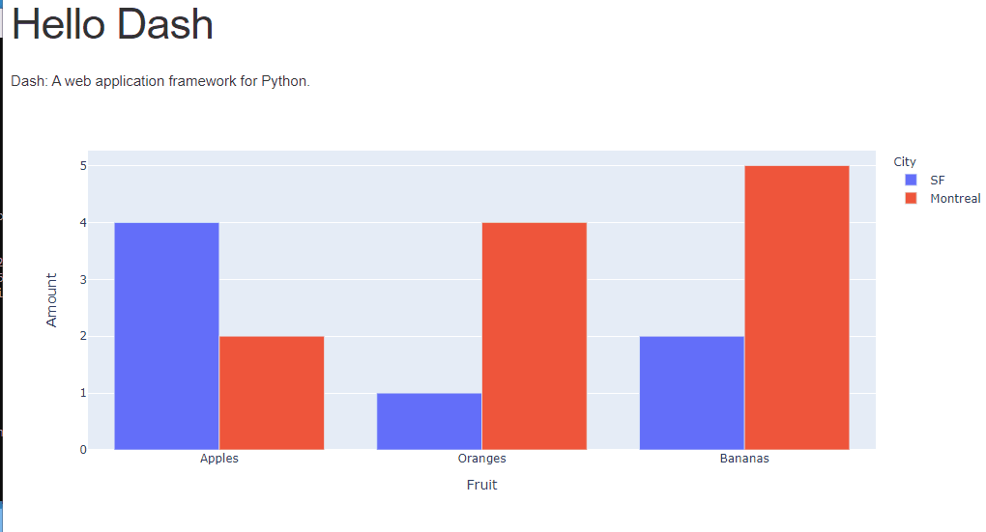
ArduinoTestFiles/SmallRadioTelescope/Code/PythonCode/CodeGifs/DashDaqBasicTutorial.gif
