HARDWAREdotASTRO/Small_Radio_Telescope/ArduinoTestFiles/SmallRadioTelescope/PicturesAndVideos/ProgrammingRPIAndArduino/Arduino/InstallSHFileExecution.jpg

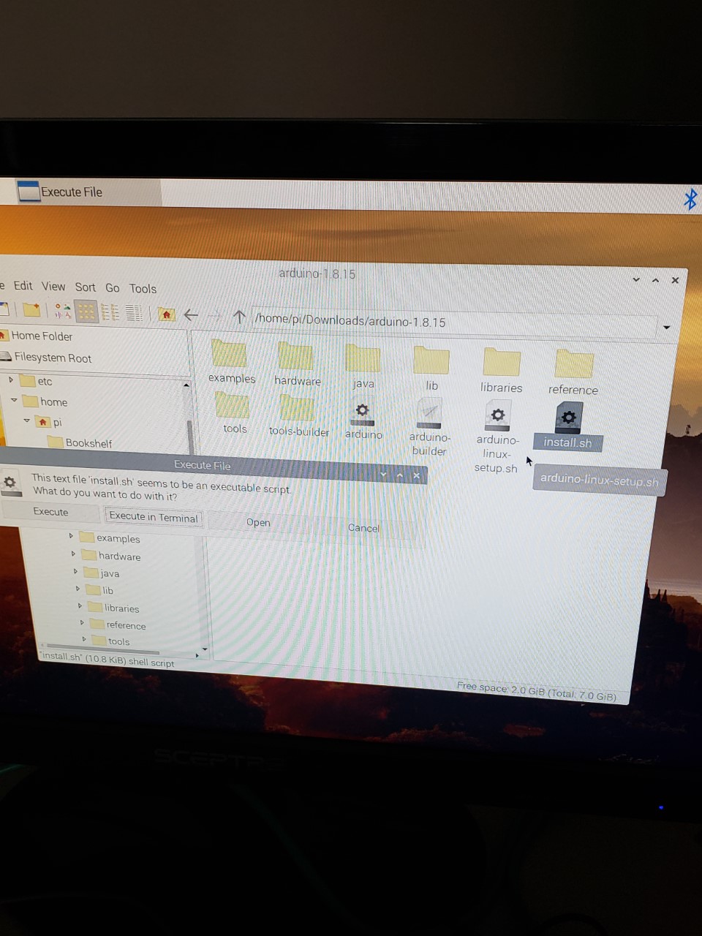
ArduinoTestFiles/SmallRadioTelescope/PicturesAndVideos/ProgrammingRPIAndArduino/Arduino/InstallSHFileExecution.jpg
