HARDWAREdotASTRO/Small_Radio_Telescope/ArduinoTestFiles/SmallRadioTelescope/PicturesAndVideos/ProgrammingRPIAndArduino/Arduino/SuccessfulArduinoInstallation.jpg

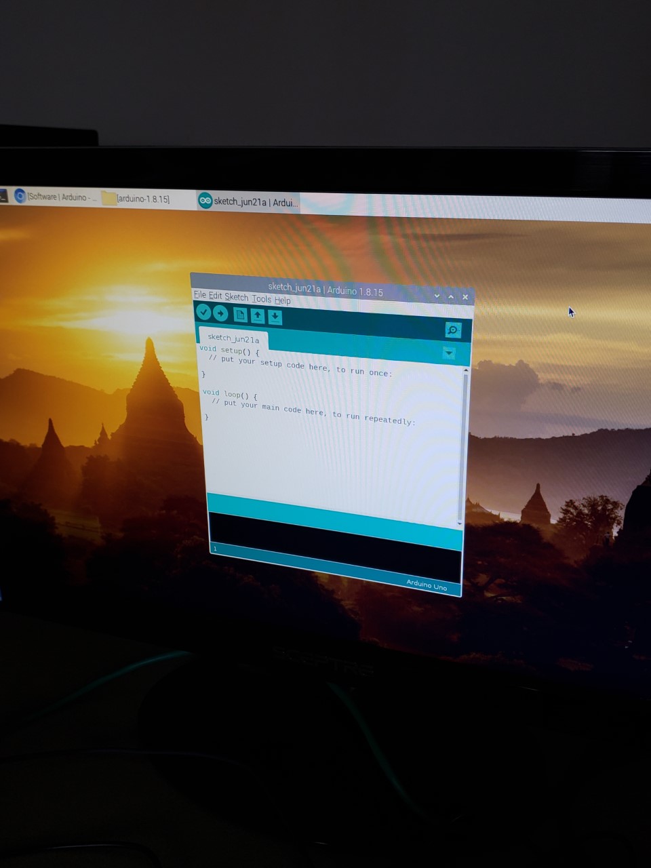
ArduinoTestFiles/SmallRadioTelescope/PicturesAndVideos/ProgrammingRPIAndArduino/Arduino/SuccessfulArduinoInstallation.jpg
