HARDWAREdotASTRO/Small_Radio_Telescope/ArduinoTestFiles/SmallRadioTelescope/PicturesAndVideos/ProgrammingRPIAndArduino/RaspberryPi/SuccessfulLibraryInstallForRPIGUI.jpg

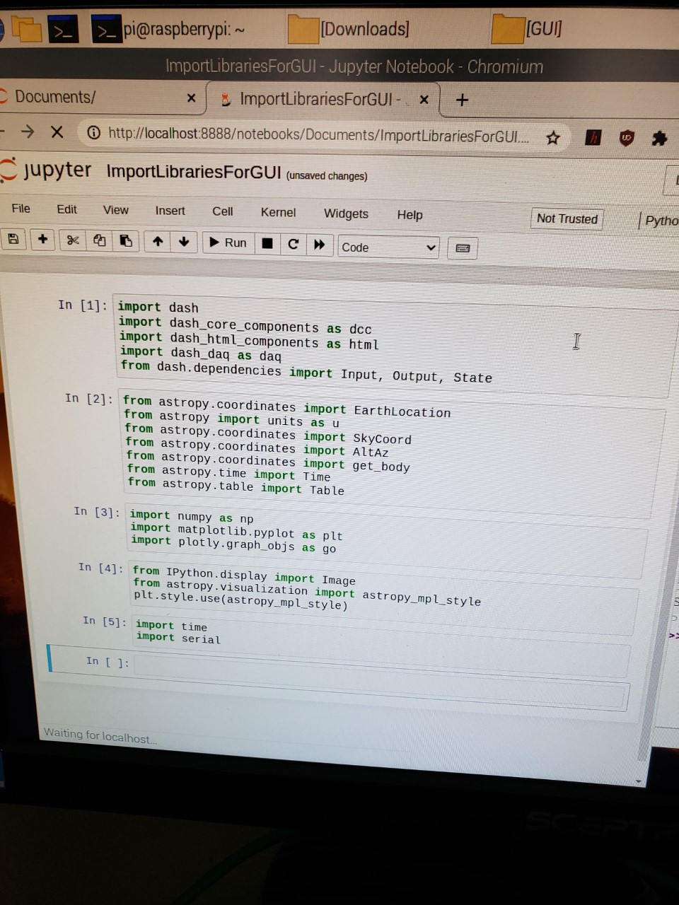
ArduinoTestFiles/SmallRadioTelescope/PicturesAndVideos/ProgrammingRPIAndArduino/RaspberryPi/SuccessfulLibraryInstallForRPIGUI.jpg
