HARDWAREdotASTRO/Small_Radio_Telescope/ArduinoTestFiles/SmallRadioTelescope/PicturesAndVideos/SRTMotorAssembly/ArduinoMotorAssemblySwitch.jpg

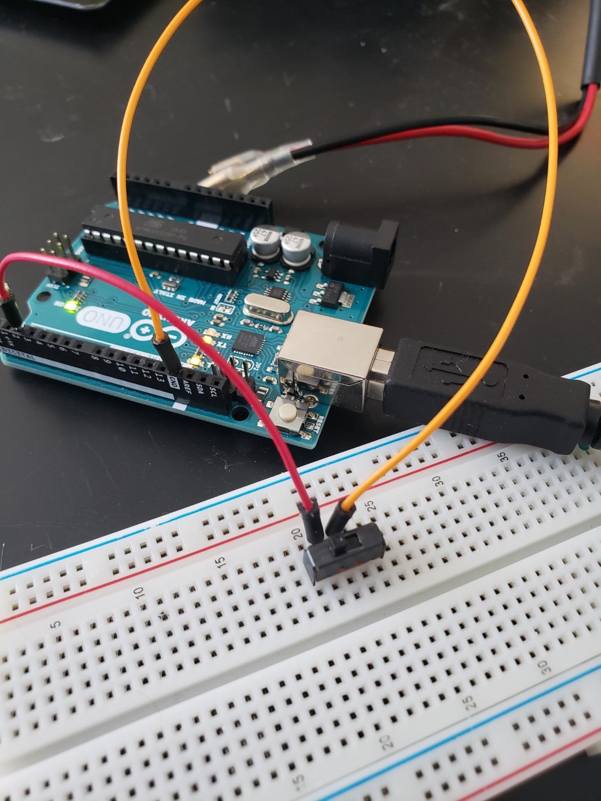
ArduinoTestFiles/SmallRadioTelescope/PicturesAndVideos/SRTMotorAssembly/ArduinoMotorAssemblySwitch.jpg
