HARDWAREdotASTRO/Small_Radio_Telescope/Pics/redonewiringdiagram2.PNG

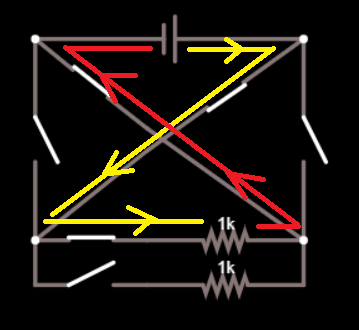
Pics/redonewiringdiagram2.PNG
