HARDWAREdotASTRO/Small_Radio_Telescope/Pics/redonewiringdiagram.PNG

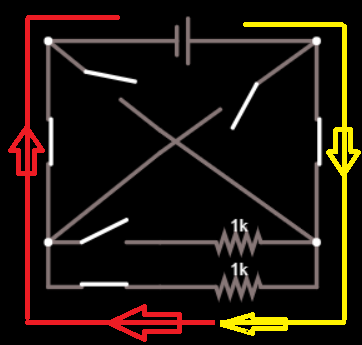
Pics/redonewiringdiagram.PNG
