HARDWAREdotASTRO/Small_Radio_Telescope/Pics/Wiring_diagram1.PNG

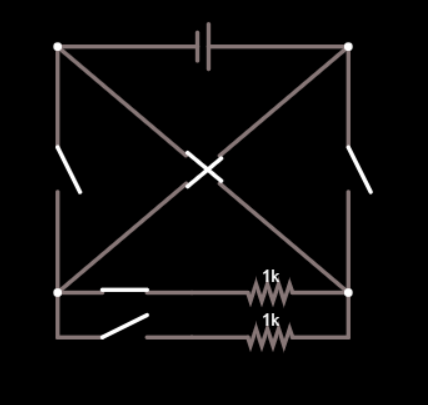
Pics/Wiring_diagram1.PNG
