HARDWAREdotASTRO/Small_Radio_Telescope/Pics/Wiring_diagram2.PNG

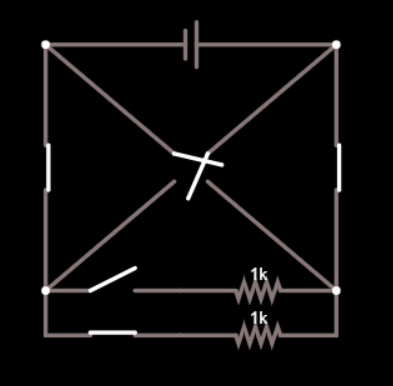
Pics/Wiring_diagram2.PNG
