HARDWAREdotASTRO/Small_Radio_Telescope/ArduinoTestFiles/SmallRadioTelescope/JonathanHasanStrategicPlan.xlsx

Goal | MOS | Key Tasks | Limiting factors | Questions | Key players | Timeline/Date
Motor Assembly | Understand H-bridge and what it does | Compile information from clayton | Understand H-bridge and motors |  | Me, Carl?
Motor Assembly | Understand how the chip will allow this functionality | Compile information from clayton | Understand chip design |  | Me
Motor Assembly | Any changes to design are better than original | Research assembly and Ask professor for guidance and use solidworks | what parts need to be designed? |  | Me, Carl?
Motor Assembly | H-bridge put together and works perfectly | Soder together and use oscilloscope to test | Time to complete task |  | Me, Carl, Friends
Motor Assembly |  |  |  |  | Me
Parts Replacement | Parts needed to be replaced identified | Look over SRT and make a list of all parts | What are all the parts for the SRT? |  | Carl
Parts Replacement | Necessary parts repurchased or remade | Find which parts are needed | What are all the parts for the SRT? |  | Me
Parts Replacement | Parts work as intended | Test it to make sure it works | Test parts |  | Me, Carl
Signal Receiver | Understand mathematical model of a signal receiver | Need to find information about how a signal receiver is modelled. | Need to find information on signal rceiver engineering |  | Me, Carl
Signal Receiver | Build a circuit that performs voltage amplification | Need to research voltage amplification circuits | Research on voltage gain and amplification |  | Me
Signal Receiver | Signal reciever body modelled | Make a model of signal reiver in solidworks | What shape is ideal for signal capture |  | Me, Carl
Signal Receiver | model and circuit are approved for manufacturing | Have experts look at model and circuit to look for any issues | Need to find a good time for them to help me |  | Me
Signal Receiver | Reciever manufactured and works perfectly | Make the reciever and perform necessary tests. | Getting access to resources for manufacturing |  | Me
Programming | Understand code bases for DASH and arduino | Read clayton hanson's code | Need to understand code layout |  | Me
Programming | modify code bases with additions or changes | Make changes to code and fork to new repo | Need to find subsections that can be replaced |  | Me
Programming | Test code bases | Test code and see if it work as well as original | Time to test |  | Me
Practical manufacturing skills | Understand how to use CNC machine | Find what can be done with CNC | Understand how CNC works and actually use it |  | Me, Carl
Practical manufacturing skills | Understand how to use laser cutter | Find what can be done with laser cutter | Understand how laser cutter works and actually use it |  | Me, Carl
Practical manufacturing skills | Understand any other manufacturing techniques | Determine other manufacturing techniques that can be used. | What other techniques are there? |  | Me, Carl
Electronics | Be able to make an initial sketch for intermediate-advanced circuits | Research into electronics Horowitz might be a good start | Analyzing transistors, diodes, capacitors, inductors, other advanced components
Electronics | Put those plans into practice by making circuits | Go to electronics lab and make circuits | Time
Electronics | Circuit works as intended | Test with oscilloscope | TIme
Beginning of strategic plan
Goal | Task | Components 1---# | end Date | Duration | Start date
Motor Assembly | Compile information | Read up on H-bridge | 2018-03-01 | 1 | 2018-02-28
 | Compile information | Take Notes | 2018-03-01 | 1 | 2018-02-28
 | Compile information | Put notes on OSF | 2018-03-01 | 1 | 2018-02-28
 | Compile information | Read up on chip used for H bridge | 2018-03-01 | 5 | 2018-02-24
 | Compile information | Take Notes,pictures | 2018-03-01 | 3 | 2018-02-26
 | Compile information | Put Notes on OSF | 2018-03-01 | 3 | 2018-02-26
 | Design Changes | Analyze current setup | 2018-03-10 | 4 | 2018-03-06
 | Design changes | Take notes, pictures | 2018-03-14 | 4 | 2018-03-10
Motor Assembly | Design Changes | Make Changes | 2018-03-14 | 2 | 2018-03-12
 | Design Changes | Update Notes | 2018-03-16 | 1 | 2018-03-15
 | Assembly | Learn to solder | 2018-03-17 | 1 | 2018-03-16
 | Assembly | Test chip by itself | 2018-03-18 | 1 | 2018-03-17
 | Assembly | Test chip with the motors in simple test | 2018-03-20 | 1 | 2018-03-19
Motor Assembly | Assembly | Assemble final components | 2018-03-21 | 2 | 2018-03-19
 | Test | Make a testing plan for metrics | 2018-03-24 | 3 | 2018-03-21
 | Test | Show to Carl for approval | 2018-03-27 | 1 | 2018-03-26
 | Test | Test according to plan | 2018-03-31 | 2 | 2018-03-29
Motor Assembly | Test | Take notes, pictures | 2018-04-01 | 1 | 2018-03-31
 | Test | Deliver final results for approval | 2018-04-01 | 1 | 2018-03-31
 |  |  | 2018-04-01 | 1 | 2018-03-31
 |  |  |  |  | 0
Parts Replacement | Identify parts | Go to SRT room and perform initial inspection of SRT | 2018-03-10 | 1 | 2018-03-09
 | Identify parts | Find schematics and look over them. | 2018-03-10 | 1 | 2018-03-09
 | Identify parts | Determine if any parts are missing | 2018-03-10 | 5 | 2018-03-05
 | Remake/Purchase | If above is true, identify parts which need to purchase or remake | 2018-03-14 | 5 | 2018-03-09
Parts Replacement | Remake/Purchase | Coalesce items needed into invoice for approval | 2018-03-14 | 5 | 2018-03-09
 | Remake/Purchase | Acquire all parts | 2018-03-14 | 2 | 2018-03-12
 | clean | Clean old parts of rust with sand blaster | 2018-03-14 | 2 | 2018-03-12
 | clean | Take pictures of cleaned parts, update notes | 2018-03-14 | 5 | 2018-03-09
Parts Replacement | Replace | Use purchased parts and replace deficient parts | 2018-03-14 | 2 | 2018-03-12
 | Replace | Use any 3d printed parts and replace deficient parts | 2018-03-14 | 1 | 2018-03-13
 |  |  | 2018-03-14 | 1 | 2018-03-13
 |  |  |  |  | 0
Signals Reciever | Theory | Look up theory behind signals and systems | 2018-06-01 | 20 | 2018-05-12
 | Theory | Practice some math pertaining to above | 2018-06-01 | 20 | 2018-05-12
 | Theory | See how theory extends to receivers | 2018-06-01 | 20 | 2018-05-12
 | Circuits | Research on circuits for receivers | 2018-06-01 | 18 | 2018-05-14
Signals Reciever | Circuits | Make a preliminary sketch for circuit | 2018-06-01 | 17 | 2018-05-15
 | Circuits | Test circuit in LTSpice | 2018-06-01 | 17 | 2018-05-15
 | Circuits | Share with Carl for approval | 2018-06-01 | 16 | 2018-05-16
 | Circuits | Build circuit | 2018-06-01 | 14 | 2018-05-18
 | Circuits | Take pictures, take notes | 2018-06-01 | 14 | 2018-05-18
Signals Reciever | Circuits | Share with Carl for approval | 2018-03-01 | 1 | 2018-02-28
 | Model | Do some solidworks tutorials | 2018-03-01 | 1 | 2018-02-28
 | Model | Make a sketch of reciever design | 2018-03-01 | 1 | 2018-02-28
 | Model | Share with carl, upload to OSF | 2018-03-01 | 1 | 2018-02-28
Signals Reciever | Model | Make model in solidworks | 2018-06-01 | 2 | 2018-05-30
 | Model | Share with carl, upload to OSF | 2018-06-01 | 2 | 2018-05-30
 | Manufacture | Make final circuit | 2018-06-01 | 2 | 2018-05-30
 | Manufacture | Make final enclosure for circuit | 2018-06-01 | 2 | 2018-05-30
 | Manufacture | Make signal receiver body | 2018-06-01 | 2 | 2018-05-30
 | Manufacture | Install circuit into signal reciever body | 2018-06-01 | 2 | 2018-05-30
Signals Reciever | Test | Make a testing plan for metrics | 2018-06-01 | 1 | 2018-05-31
 | Test | Share with Carl | 2018-06-01 | 1 | 2018-05-31
 | Test | Test according to plan | 2018-06-01 | 1 | 2018-05-31
 | Test | Record results and put on OSF, take pictures | 2018-06-01 | 1 | 2018-05-31
 |  |  |  |  | 0
Programming | Analyze Code | Look up Dash tutorials | 2018-03-01 | 7 | 2018-02-22
 | Analyze Code | Look at Clayton's code | 2018-03-01 | 7 | 2018-02-22
 | Modify | Make improvements to code if any | 2018-03-01 | 7 | 2018-02-22
Programming | Modfiy | Make changes to code fi any | 2018-03-01 | 1 | 2018-02-28
 | Test Dash | Make a testing plan for GUI | 2018-03-01 | 1 | 2018-02-28
Programming | Test Dash | Test GUI according to Plan | 2018-03-01 | 1 | 2018-02-28
 | Implement | upload to pi
 | Analyze Code | Look up arduino tutorials
 | Analyze Code | Look at Clayton's code
 | Modify | Make improvements to code if any
 | Modify | Make changes to code fi any
 | Test arduino | Make a testing plan for arduino
 | Test arduino | Test arduino code according to plan
 | Upload final sketch | Upload sketch to arduino
Practical Manufacture | CNC | Learn about CNC
 | Practice | Practice with machine
 | Use | Make something with useful with it
Practical Manufactre
 | Laser cutter | learn about laser cutter
 | practice | practice with laser cutter
 | Use | Make something with useful with it
Practical Manufacture
Electronics | Learn about electronics | Read art of electronics
 |  | Do problems in book
 |  | Implement circuits
 |  | Get up to upper intermediate-lower expert knowledge
 |  | Take pictures and log progress
Electronics |  | Use microcontrollers and rpi if possible
 |  | Learn verilog
 |  | Learn FPGA
Electronics
