HARDWAREdotASTRO/Small_Radio_Telescope/ArduinoTestFiles/SmallRadioTelescope/PicturesAndVideos/MathDerivations/SquareWaveApproximation.gif

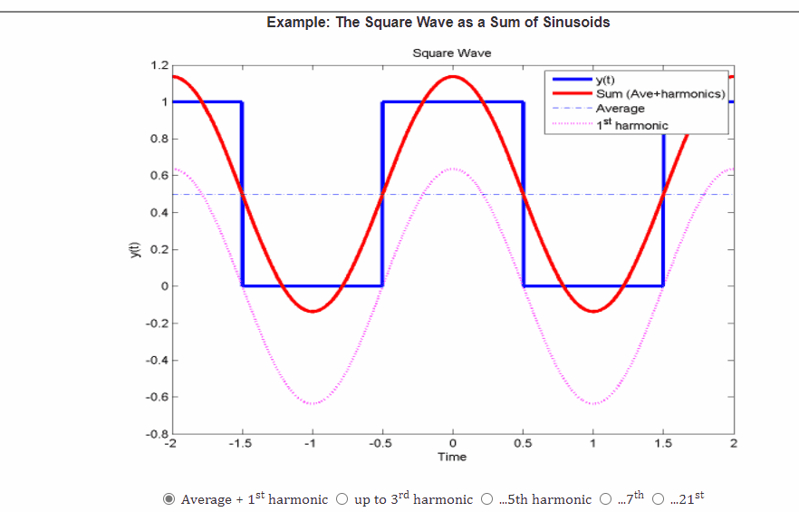
ArduinoTestFiles/SmallRadioTelescope/PicturesAndVideos/MathDerivations/SquareWaveApproximation.gif
