HARDWAREdotASTRO/Small_Radio_Telescope/ArduinoTestFiles/SmallRadioTelescope/PicturesAndVideos/MathDerivations/TriangleWaveApproximation.gif

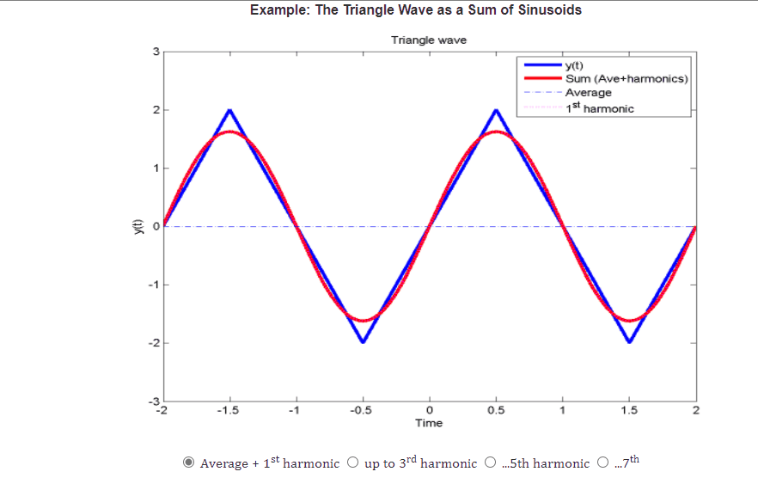
ArduinoTestFiles/SmallRadioTelescope/PicturesAndVideos/MathDerivations/TriangleWaveApproximation.gif
