HARDWAREdotASTRO/Small_Radio_Telescope/ArduinoTestFiles/SmallRadioTelescope/PicturesAndVideos/ProgrammingRPIAndArduino/Arduino/Arduino.jpg

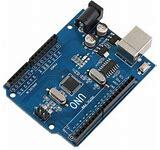
ArduinoTestFiles/SmallRadioTelescope/PicturesAndVideos/ProgrammingRPIAndArduino/Arduino/Arduino.jpg
