HARDWAREdotASTRO/Small_Radio_Telescope/ArduinoTestFiles/SmallRadioTelescope/PicturesAndVideos/ProgrammingRPIAndArduino/Arduino/Button_Switch_Code_Test.gif

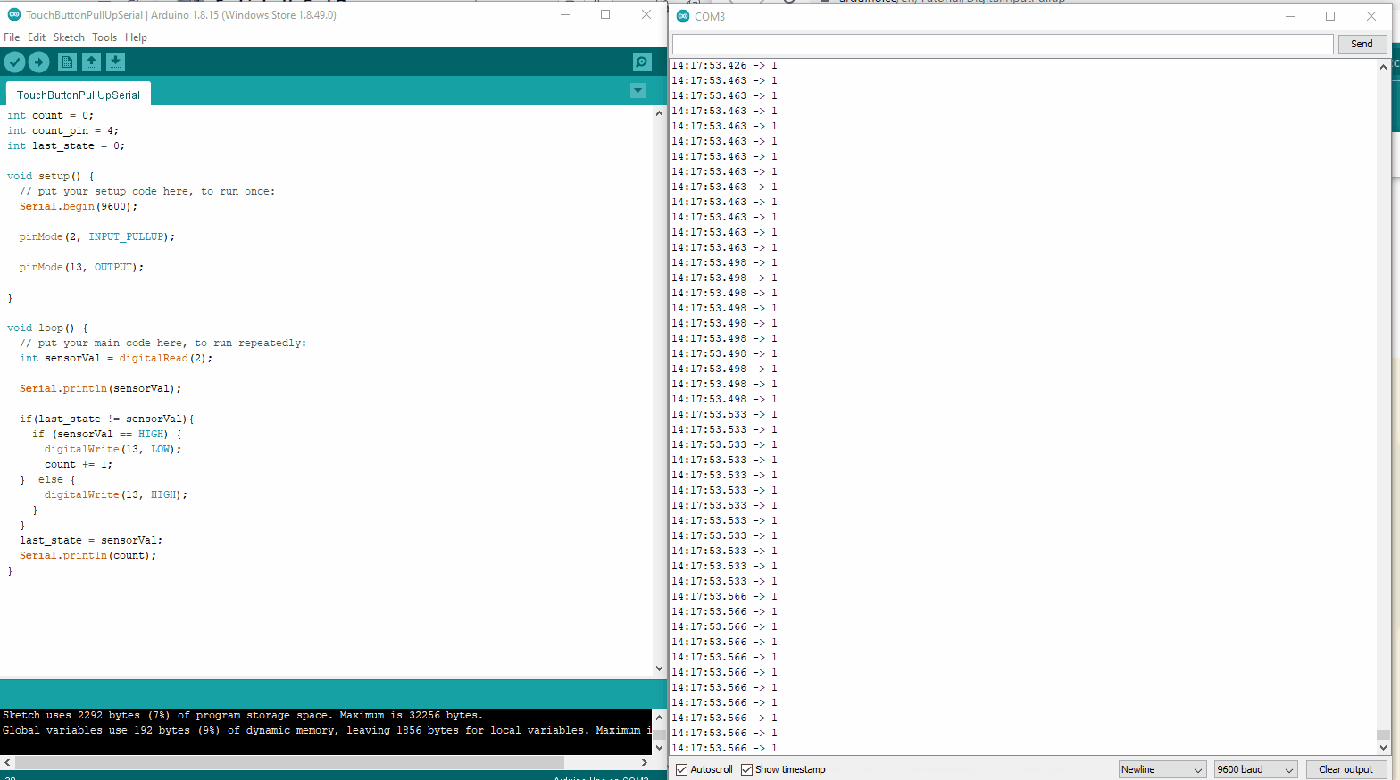
ArduinoTestFiles/SmallRadioTelescope/PicturesAndVideos/ProgrammingRPIAndArduino/Arduino/Button_Switch_Code_Test.gif
