HARDWAREdotASTRO/Small_Radio_Telescope/ArduinoTestFiles/SmallRadioTelescope/PicturesAndVideos/ProgrammingRPIAndArduino/RaspberryPi/Raspberry-Pi-3-1-1619x1080.jpg

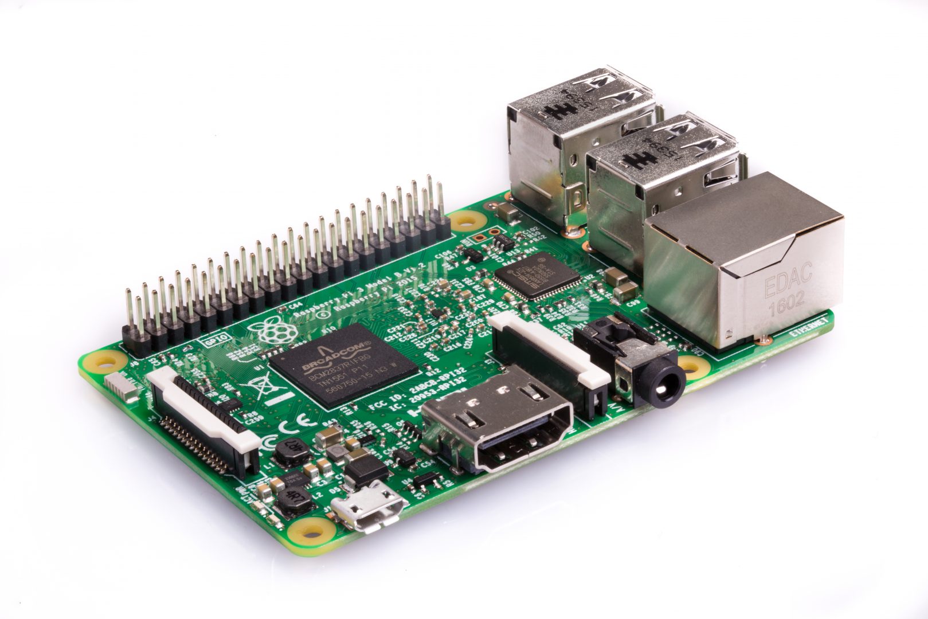
ArduinoTestFiles/SmallRadioTelescope/PicturesAndVideos/ProgrammingRPIAndArduino/RaspberryPi/Raspberry-Pi-3-1-1619x1080.jpg
