HARDWAREdotASTRO/Small_Radio_Telescope/ArduinoTestFiles/SmallRadioTelescope/PicturesAndVideos/SignalsReceiver/SignalsReceiver2.jpg

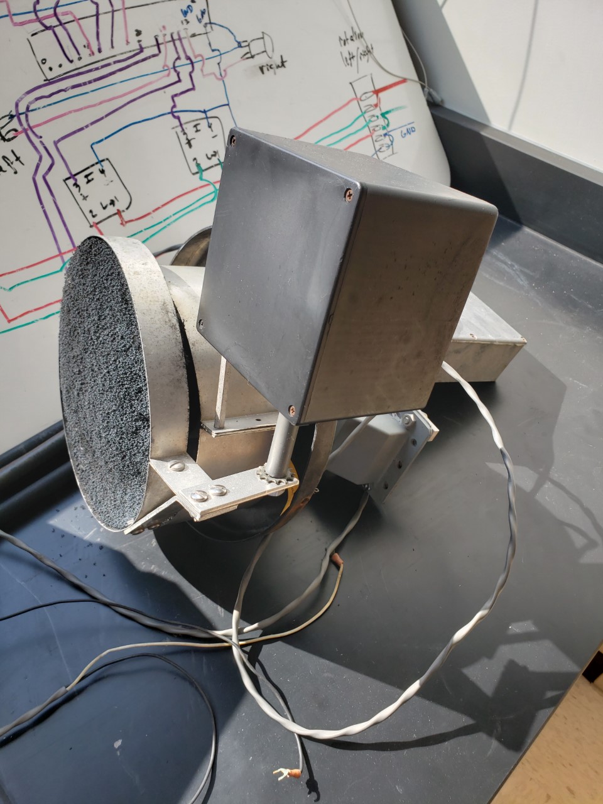
ArduinoTestFiles/SmallRadioTelescope/PicturesAndVideos/SignalsReceiver/SignalsReceiver2.jpg
