HARDWAREdotASTRO/Small_Radio_Telescope/ArduinoTestFiles/SmallRadioTelescope/PicturesAndVideos/ToolsForRadioAstronomy/ToolsForRadioAstronomyBasicDefinitions.jpg

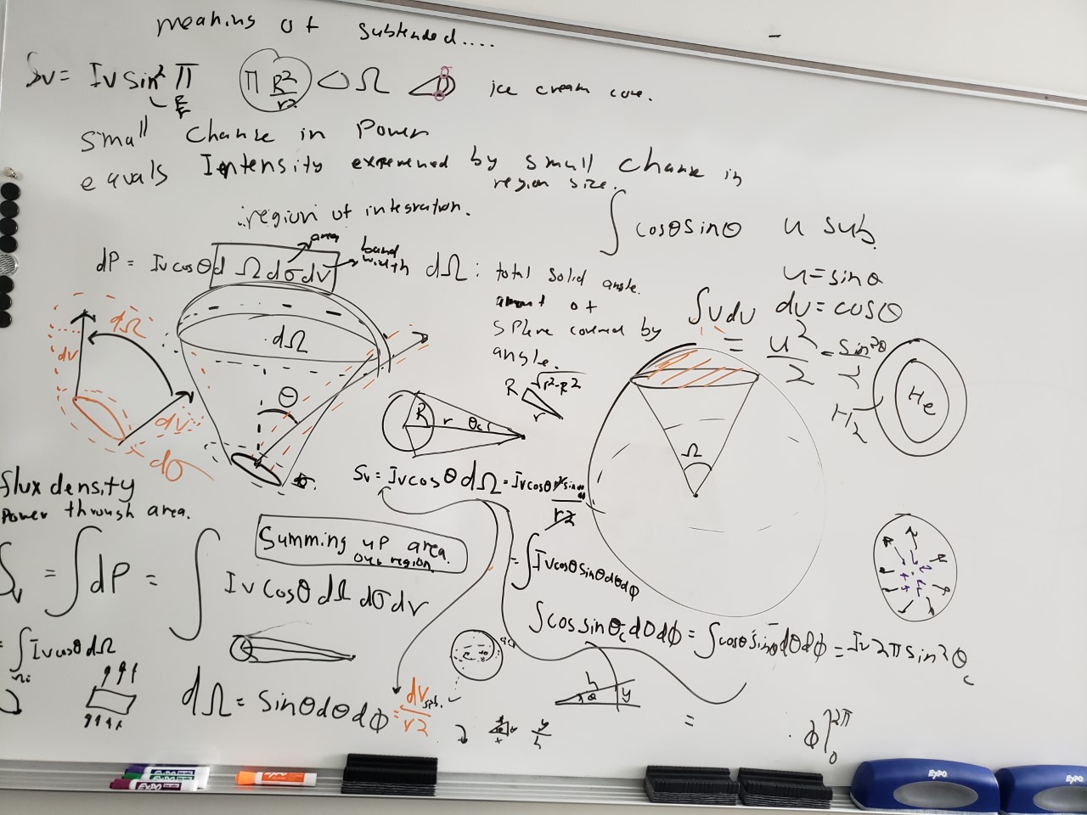
ArduinoTestFiles/SmallRadioTelescope/PicturesAndVideos/ToolsForRadioAstronomy/ToolsForRadioAstronomyBasicDefinitions.jpg
