HARDWAREdotASTRO/Small_Radio_Telescope/ArduinoTestFiles/SmallRadioTelescope/PicturesAndVideos/ToolsForRadioAstronomy/ToolsFOrRadioAstronomyBookCover.jpg

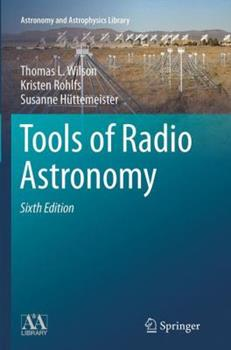
ArduinoTestFiles/SmallRadioTelescope/PicturesAndVideos/ToolsForRadioAstronomy/ToolsFOrRadioAstronomyBookCover.jpg
