HARDWAREdotASTRO/Small_Radio_Telescope/ArduinoTestFiles/SmallRadioTelescope/PicturesAndVideos/ToolsForRadioAstronomy/ToolsForRadioAstronomyRadiativeTransfer.jpg

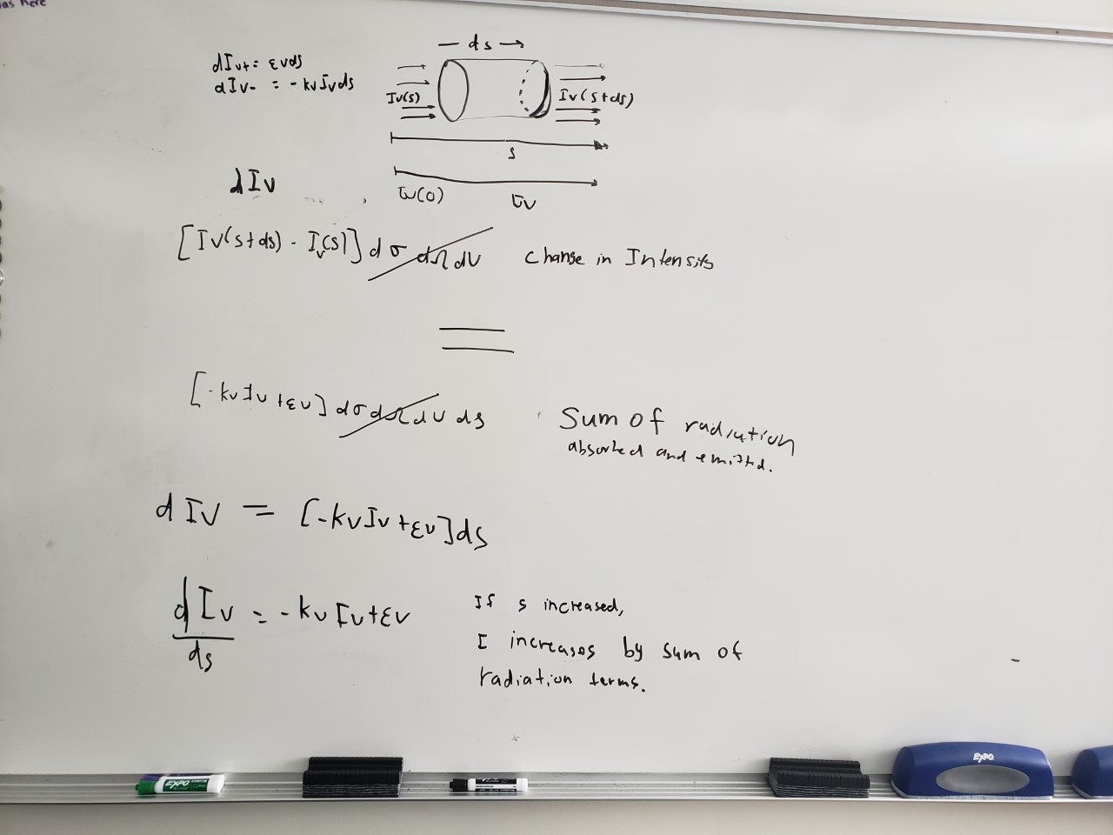
ArduinoTestFiles/SmallRadioTelescope/PicturesAndVideos/ToolsForRadioAstronomy/ToolsForRadioAstronomyRadiativeTransfer.jpg
