HARDWAREdotASTRO/Small_Radio_Telescope/Research/M09403615.pdf

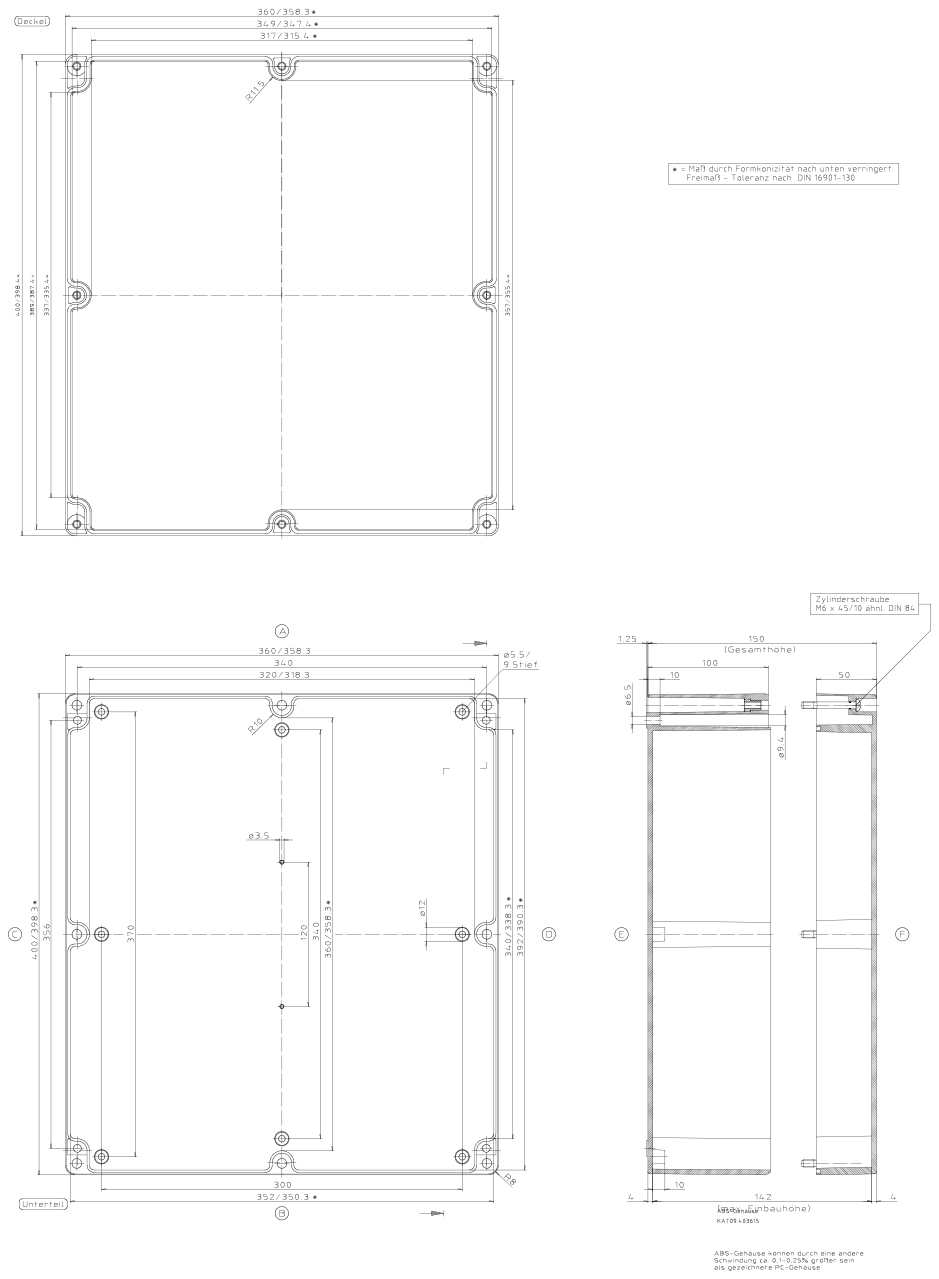
[picture p174: page 1]
