HARDWAREdotASTRO/Small_Radio_Telescope/(list of files, drawings)

Other design files:
AdditionalSolidWorksFiles/DataSheets/L293D_Motor_Driver_Schem.fzz
