HARDWAREdotASTRO/Small_Radio_Telescope/Code/Arduino/JonathanHasanArduinoFiles/FinalCode/Azimuthal/FinalCode/TestingSwitches/MotorTestCodeSRTSwitches/MotorTestCodeSRTSwitches.ino

/*
 * Motor Test Code with SRT switches
 * 
 * Author: Jonathan Hasan
 * Date: 6/24/2021
 * 
 * Updated : 6/28/2021 Time: 11:45 AM
 * UPdated: 4/22/2022
 * 
 * Purpose: 
 * 
 * Create a script that will allow for the running of the motor with arduino, pololu chip
 * tsiny motor and the two limit switches on the SRT
 *
 * 
 * Instructions:
 * 
 *Construct the circuit, install the limit switches, setup the motor and dc supply and then run the code. 
 */


//initialize pins for the motor

int A_1 = 13;       //These pins out put forward, reverse and the
int A_2 = 12;        //pulse width to the Pololu chip.
int A_PWM = 11;

//pins for Left ( activates in CCW direction) and right (activates in CW direction) switch
int leftLimitSwitch = 6;
int rightLimitSwitch = 7; 

//initialize variables 


//instantiate state variables
int last_state1 = 0; 
int last_state2 = 0; 


// Instantiate count variables. For some odd reason, the count increments right away at the beginning. 
//Decided to set the variable to -1 so that it would go up to 0. Not sure what is causing it. 
int leftLimitSwitch_count = -1; 
int rightLimitSwitch_count = -1; 

int val = 255; 


void setup() {
  // put your setup code here, to run once:

  Serial.begin(9600);         //Begin Serial connection.
  
  pinMode(A_1, OUTPUT);       //Initialize output pins.
  pinMode(A_2, OUTPUT);
  pinMode(A_PWM, OUTPUT);

  digitalWrite(A_1, LOW);     //Write output pins low so the
  digitalWrite(A_2, LOW);     //motors are off when the 
  analogWrite(A_PWM, LOW);   //Arduino is turned on.

//1. Uncomment below line when count_pin is instantiated
//  pinMode(count_pin, INPUT_PULLUP);  //Initialize sensor pins.

// Uncomment below lines when forward_pin and reverse_pin are instantiated
  pinMode(leftLimitSwitch, INPUT_PULLUP); 
  pinMode(rightLimitSwitch, INPUT_PULLUP); 
 
  
}

void loop() {

//print both the Right and left limit switch values 

Serial.println("Left Limit switch value: " + String(leftLimitSwitch_count) + " " + "Right Limit switch value: " + String(rightLimitSwitch_count)); 

// Condition for the running of the  motor. 

//if forward or reverse count greater than >= 1, stop the motor. 
  if(leftLimitSwitch_count >= 2  || rightLimitSwitch_count >= 2){
    digitalWrite(A_1, LOW);
    digitalWrite(A_2, LOW);
    digitalWrite(A_PWM, LOW);

    //if count for either forward or reverse exceeds 2, end the serial stream. 
    if(leftLimitSwitch_count >=2){
      Serial.println("count on Left Limit Switch is greater than or equal to 2"); 
    }
    else{
      Serial.println("count on Right Limit Switch is greater than or equal to 2"); 
    }
    Serial.println("Shutting down....");
    Serial.end(); 
  }
// else Start motor in forward direction with 50% duty cycle
  else{digitalWrite(A_1, LOW); 
  digitalWrite(A_2, HIGH); 
  digitalWrite(A_PWM, round(val/2)); 
   }


  //read the pin for switches
  int sensorVal1 = digitalRead(leftLimitSwitch); 
  int sensorVal2 = digitalRead(rightLimitSwitch);


  //check if the state of pins 8, 9 is equal to the sensor value state. 
  //If it is, don't increment count. If not, change value and increase by 1. 
  if(last_state1 != sensorVal1){
    if (sensorVal1 == HIGH) {
      //digitalWrite(5, LOW);
      leftLimitSwitch_count += 1;
  }  else {
      //digitalWrite(5, HIGH); 
      leftLimitSwitch_count += 0; 
    }
  }

  if(last_state2 != sensorVal2){
    if (sensorVal2 == HIGH) {
      //digitalWrite(4, LOW);
      rightLimitSwitch_count += 1;
  }  else {
      //digitalWrite(4, HIGH);
      rightLimitSwitch_count += 0; 
    }
  }


  //change state to recent state and print count
  last_state1 = sensorVal1; 
  last_state2 = sensorVal2; 
  



}
