HARDWAREdotASTRO/Small_Radio_Telescope/Code/Arduino/JonathanHasanArduinoFiles/FinalCode/Azimuthal/FinalCode/TestingSwitches/ArduinoINAPWMTestCode/ArduinoINAPWMTestCode.ino

// Initialize Pins 13, 12 and 11 for INA1, INA2 and PWM 
int A_1 = 13; 
int A_2 = 12; 
int A_PWM = 11; 

// Setup max value for analogwrite. Use for PWM
int val = 255; 

void setup() {
  // put your setup code here, to run once:

  Serial.begin(9600);

//listen on this pins
  pinMode(A_1, OUTPUT); 
  pinMode(A_2, OUTPUT); 
  pinMode(A_PWM, OUTPUT); 

//digitalWrite to INA1, INA2 analogWrite to PWM. 
  digitalWrite(A_1, HIGH); 
  digitalWrite(A_2, LOW); 
  analogWrite(A_PWM, val/2); 
  
}

void loop() {
  // put your main code here, to run repeatedly:

}
