HARDWAREdotASTRO/Small_Radio_Telescope/ArduinoTestFiles/SmallRadioTelescope/Code/ArduinoSketches/ArduinoTutorials/BlinkExample/BlinkExample.ino

int led = 13; 

void setup() {
  // put your setup code here, to run once:
  //initialize the digital pin as an output. 
  pinMode(led, OUTPUT); 
}

void loop() {
  // put your main code here, to run repeatedly:
  digitalWrite(led, HIGH); 
  delay(1000); 
  digitalWrite(led, LOW); 
  delay(1000); 
}
