HARDWAREdotASTRO/Small_Radio_Telescope/(commit log)

2020-05-07 Create SRT Arduino Code
2020-08-03 Added via the Open Science Framework
2020-08-05 Deleted via the Open Science Framework
    [2x_Male_Pin_2.54_mm.STEP, 8x_Male_Pin_2.54_mm.STEP, 90618A113_MIL SPEC. BLK-OXIDE 300 SERIES SS FLAT WASHER.SLDPRT, 91290A103_BLACK-OXIDE CLASS 12.9 SOCKET HEAD CAP SCREW.SLDPRT, 92185A073_TYPE 316 SS SOCKET HEAD CAP SCREW.SLDPRT, 92185A096_TYPE 316 SS SOCKET HEAD CAP SCREW.SLDPRT, 92185A107_TYPE 316 SS SOCKET HEAD CAP SCREW.SLDPRT, 92196A107_18-8 STAINLESS STEEL SOCKET HEAD SCREW.SLDPRT]
2021-10-05 Forward (Clockwise) motor movement script added
2021-10-05 Reverse (Counterclockwise) motor movement script added
    [CumulativeMotorCircuitArduinoCodeReverseDirection.ino]
2021-10-05 Create Readme.MD
    Description of Arduino Test Files folder
2021-10-05 SRT Limit Switch Testing Files Added
2021-10-05 Test Code for Reed switch and limit switch operation, need to update limit switch code to correct version
    [CumulativeMotorCircuitArduinoCode.ino]
2021-10-26 Forward and Reverse Direction Files incorporate new Go Home procedure so that there is a zero point for each direction. Seems to work well, the fix was just to write the motors LOW before restarting 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
    [CumulativeMotorCircuitArduinoCodeForwardDirection.ino, CumulativeMotorCircuitArduinoCodeReverseDirection.ino]
2021-10-28 Removed the limit switch counters, removed limit switch count variables, added comments and cleaned up code.
2021-11-18 Added final cumulative motor circuit
    Includes improved functionality for serial input from pi and pick functions.
2022-03-04 Arduino Test Files added
    Arduino Test folder updated
    [JonathanHasanStrategicPlan.xlsx]
2022-05-22 Alot of updates
    Arduino Files placed in code and old code placed in different folder. Can be deleted later.
    [JonathanHasanStrategicPlan.xlsx]
